gemc/clas12Tags_old/5.1/source/README.md

 
 
 

<b>GE</b>ant4 <b>M</b>onte-<b>C</b>arlo

<b>gemc</b> is an application based on <a href="https://geant4.cern.ch"> Geant4 </a> to simulate the 
passage of particles through matter.

It provides:

* application independent geometry description
* easy interface to build / run experiments
* cad/gdml imports

<p align="center">
	
	
	
	
</p>
<i> examples of experiments using gemc. From left to right: a <a href="https://www.jlab.org/Hall-B/clas12-web/">CLAS12</a> beamline event; 
The electron and ion beamline and interation point detectors for the <a href="https://www.jlab.org/meic/">electron-ion collider</a>.
The gemc simulation of the Electron Ion Collider beamline and detectors.
10,000 electrons producing photons in the 6mm collimator in the bubble experiments at Jefferson Lab.</i>

========

### Overview:

gemc makes easy things trivial and hard things possible.

Users can build and run complex setups with minimal programming knowledge. 
See for example <a href="https://gemc.jlab.org/gemc/html/examples/paddles.html#simplepaddleexample">how to build a TOF with
few lines of code</a>.

Experiments can be loaded  using a combination of several available factories:

- MYSQL
- TEXT
- GDML
- CAD (STL, PLY, OBJ formats)
- C++ Plugin

<p align="center">
	<a href="https://github.com/gemc/detectors/blob/master/humanBody/Upper_GI.stl">
	</a>
	<a href="https://github.com/gemc/detectors/blob/master/forFun/enterprise.stl"> 
	</a><br>
	<small><i> gemc can <a href="https://gemc.jlab.org/gemc/html/documentation/gdmlCadFactories.html">import models from CAD and GDML</a>.
   	Left: the upper gastrointestinal system is modeled in CAD.
   	It can be <a href="https://gemc.jlab.org/gemc/html/examples/humanBody.html">imported in GEMC and made it sensitive</a> 
		so that radiation doses can be measured.
   	Right: the mighty USS Enterprise NCC 1701-A <a href="https://gemc.jlab.org/gemc/html/examples/forFun.html">can be
   	used to shoot protons torpedos</a>. 
   </i></small>
</p>

### Simulations are application independent

Once the user defined setup is loaded, it is translated in geant4. This includes:

- geometry
- materials
- mirrors
- physics list
- digitization
- electromagnetic fields

All particles are transported through matters and
produce radiation, hits, secondaries. The geant4 results are then collected and organized according to user preferences.

<p align="center">
	
</p>

### Documentation:
* <a href="http://gemc.jlab.org"> gemc home page </a>
