gemc/clas12Tags_old/5.1/config/surveyCyril.png

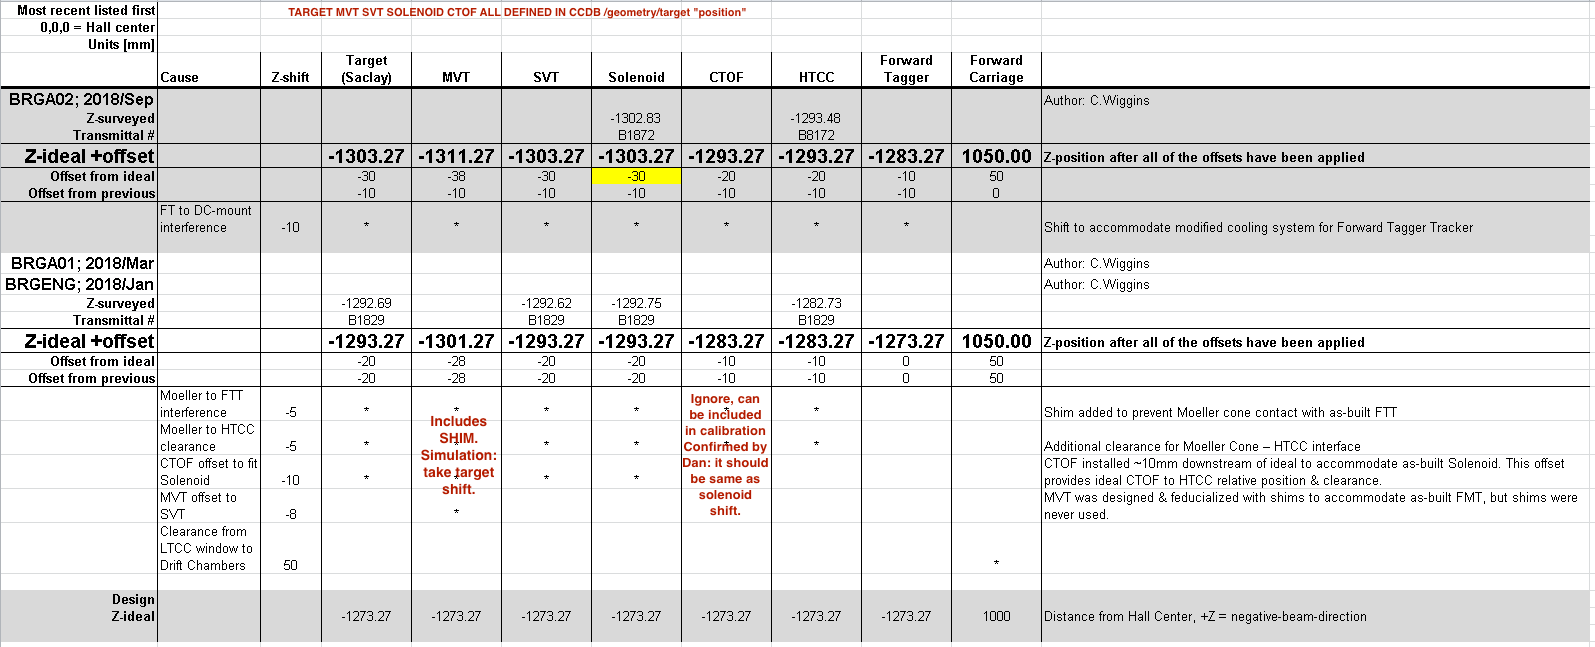
5.1/config/surveyCyril.png
