gemc/clas12Tags_old/ftOff.png

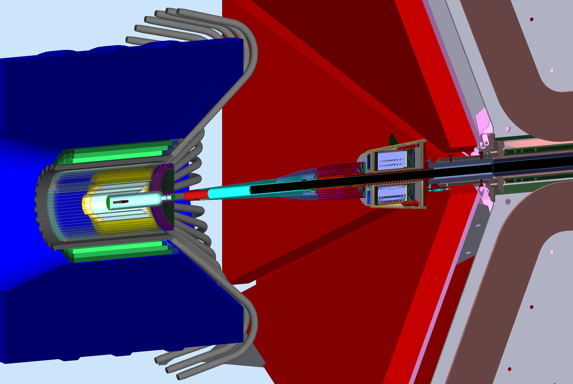
ftOff.png
