gemc/clas12Tags_old/ftOn.png

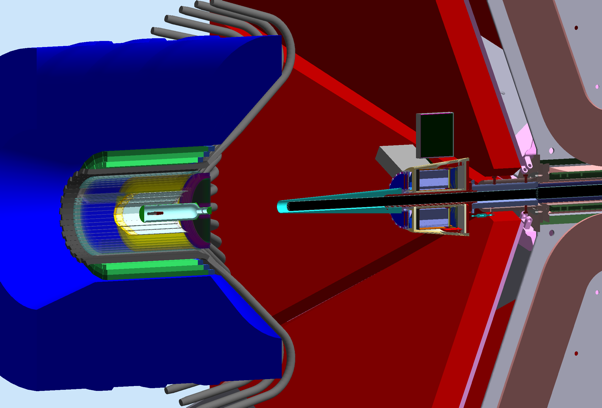
ftOn.png
