gemc/clas12Tags_old/4.4.2/experiments/clas12/beamline/cadBeamline/main-cone.stl

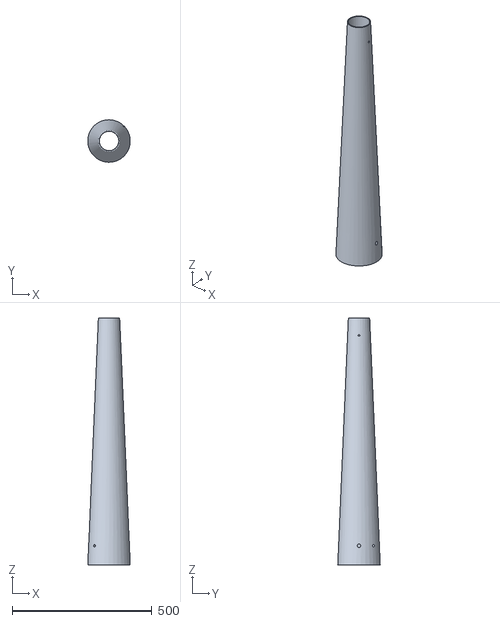
[picture p5: CAD file, 2016-12-02]
4.4.2/experiments/clas12/beamline/cadBeamline/main-cone.stl
151.9 x 152.1 x 882.6
