gemc/clas12Tags_old/4.4.2/experiments/clas12/beamline/cadBeamlineFTOFF/flange-assembly.stl

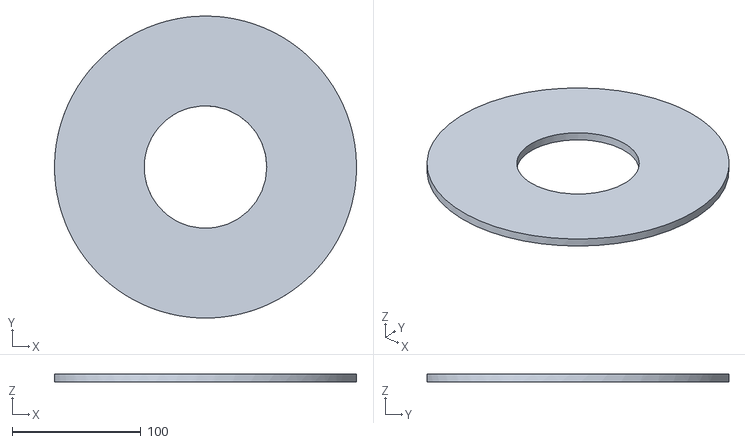
[picture p6: CAD file, 2016-12-02]
4.4.2/experiments/clas12/beamline/cadBeamlineFTOFF/flange-assembly.stl
234.7 x 234.7 x 6.35
