gemc/clas12Tags_old/5.1/experiments/clas12/beamline/cadBeamlineFTOFF/inner-assembly.stl

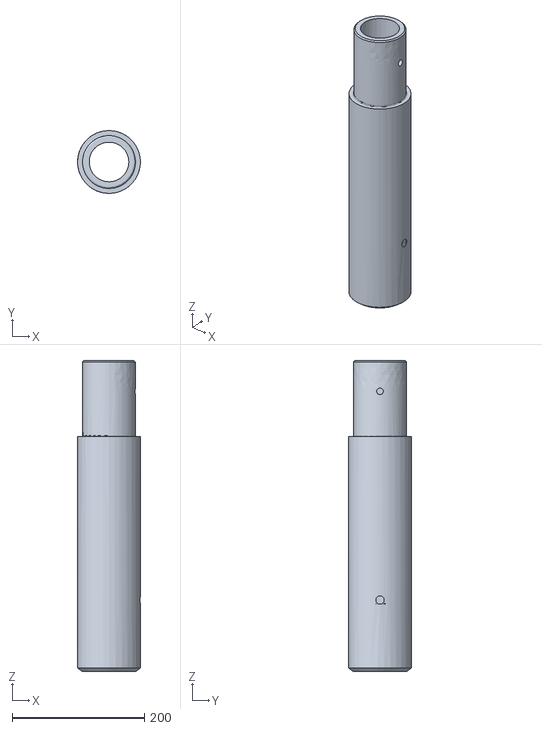
[picture p7: CAD file, 2016-12-02]
5.1/experiments/clas12/beamline/cadBeamlineFTOFF/inner-assembly.stl
95.2 x 95.2 x 471.0
