gemc/clas12Tags_old/5.1/experiments/clas12/beamline/cadBeamlineFTOFF/outer-assembly.stl

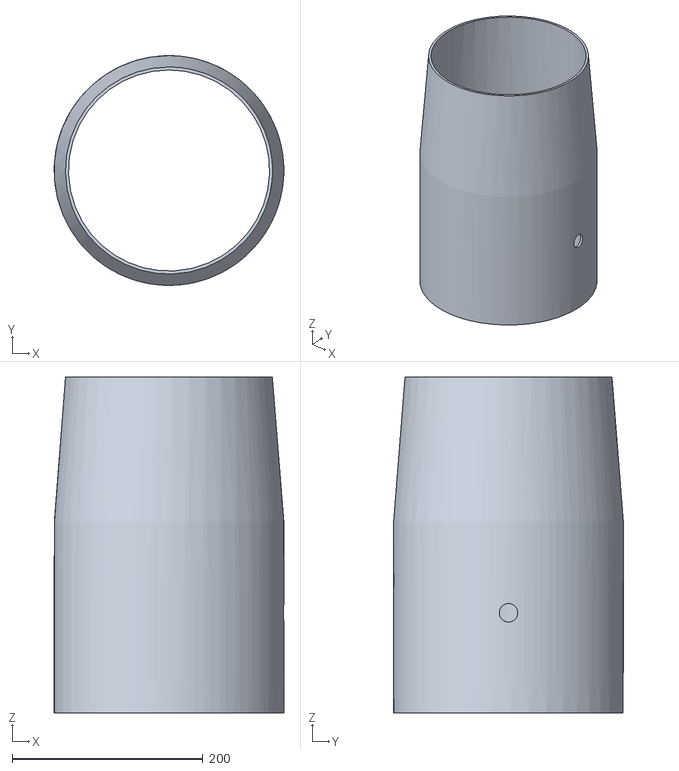
[picture p8: CAD file, 2016-12-02]
5.1/experiments/clas12/beamline/cadBeamlineFTOFF/outer-assembly.stl
241.1 x 241.1 x 352.5
