gemc/clas12Tags_old/4.4.2/experiments/clas12/beamline/cadBeamline/DSShieldFrontAss.stl

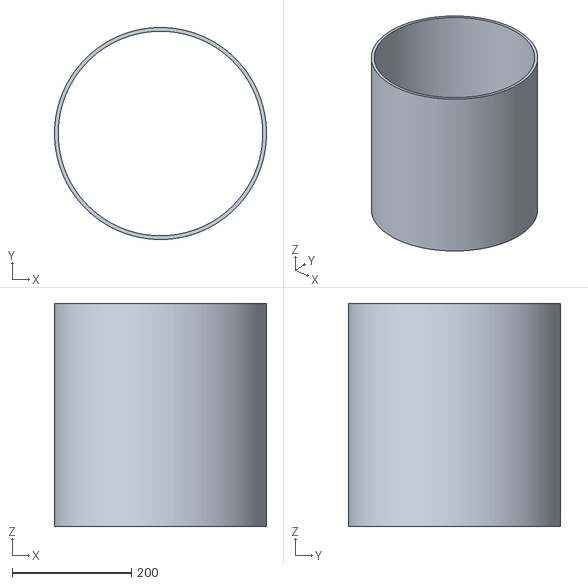
[picture p9: CAD file, 2017-10-10]
4.4.2/experiments/clas12/beamline/cadBeamline/DSShieldFrontAss.stl
355.6 x 355.6 x 374.7
