gemc/clas12Tags_old/4.4.2/experiments/clas12/beamline/cadBeamlineELMO/DSShieldFrontCover.stl

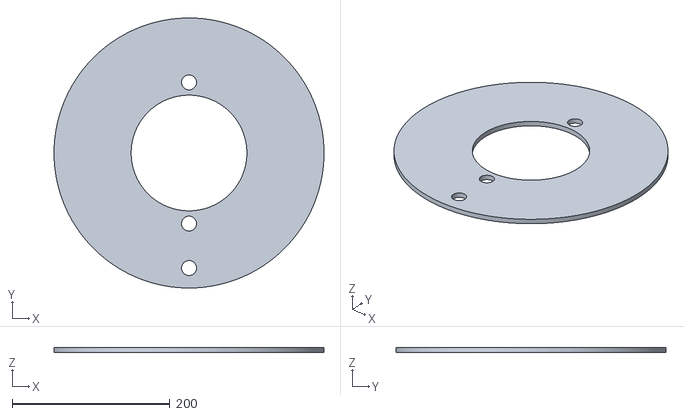
[picture p10: CAD file, 2017-10-10]
4.4.2/experiments/clas12/beamline/cadBeamlineELMO/DSShieldFrontCover.stl
342.9 x 342.9 x 6.35
