gemc/clas12Tags_old/4.4.2/experiments/clas12/beamline/cadBeamlineFTOFF/DSShieldInnerAss.stl

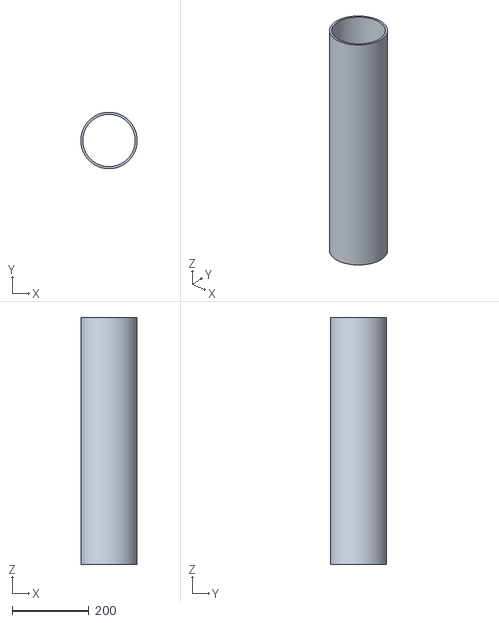
[picture p11: CAD file, 2017-10-10]
4.4.2/experiments/clas12/beamline/cadBeamlineFTOFF/DSShieldInnerAss.stl
146.9 x 147.0 x 642.9
