gemc/clas12Tags_old/4.4.2/experiments/clas12/ctof/javacad_default/sc01.stl

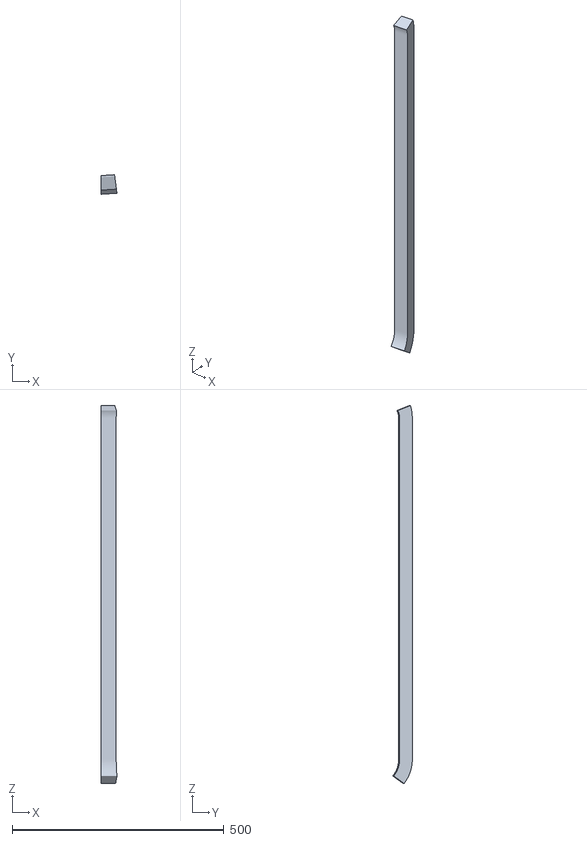
[picture p12: CAD file, 2017-07-05]
4.4.2/experiments/clas12/ctof/javacad_default/sc01.stl
37.8 x 46.3 x 892.3
