gemc/clas12Tags_old/4.4.2/experiments/clas12/ctof/javacad_rga_fall2018/sc33.stl

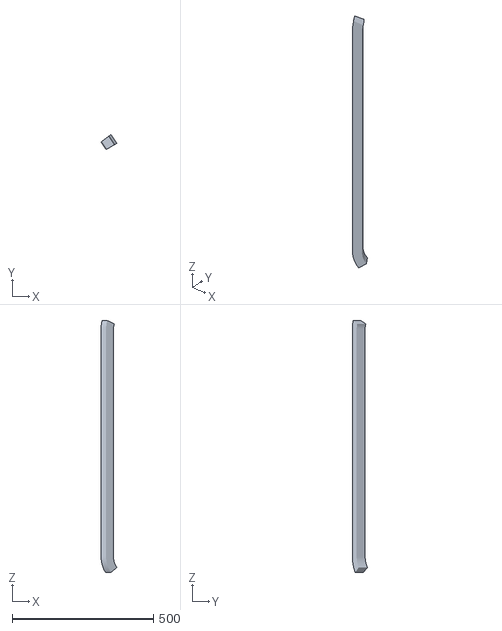
[picture p13: CAD file, 2017-07-05]
4.4.2/experiments/clas12/ctof/javacad_rga_fall2018/sc33.stl
56.2 x 53.6 x 892.3
