gemc/clas12Tags_old/4.4.2/experiments/clas12/ctof/javacad_rga_spring2018/lgd14.stl

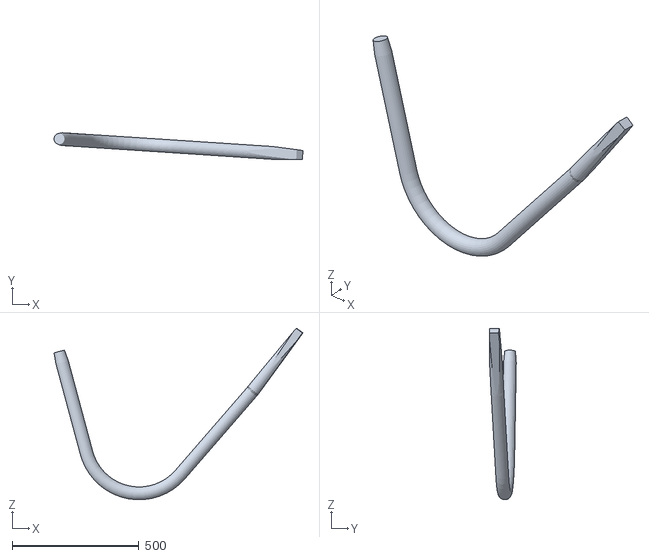
[picture p14: CAD file, 2017-07-05]
4.4.2/experiments/clas12/ctof/javacad_rga_spring2018/lgd14.stl
984.0 x 105.0 x 677.2
