gemc/clas12Tags_old/4.4.2/experiments/clas12/targets/cade/TargetVacuumWindow50umAl.stl

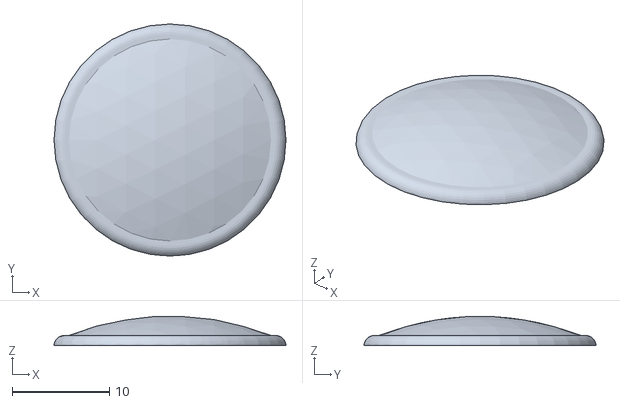
[picture p15: CAD file, 2017-08-30]
4.4.2/experiments/clas12/targets/cade/TargetVacuumWindow50umAl.stl
23.8 x 23.8 x 3.01
