gemc/clas12Tags_old/4a.1.1/experiments/clas12/ctof/javacad/lgu14.stl

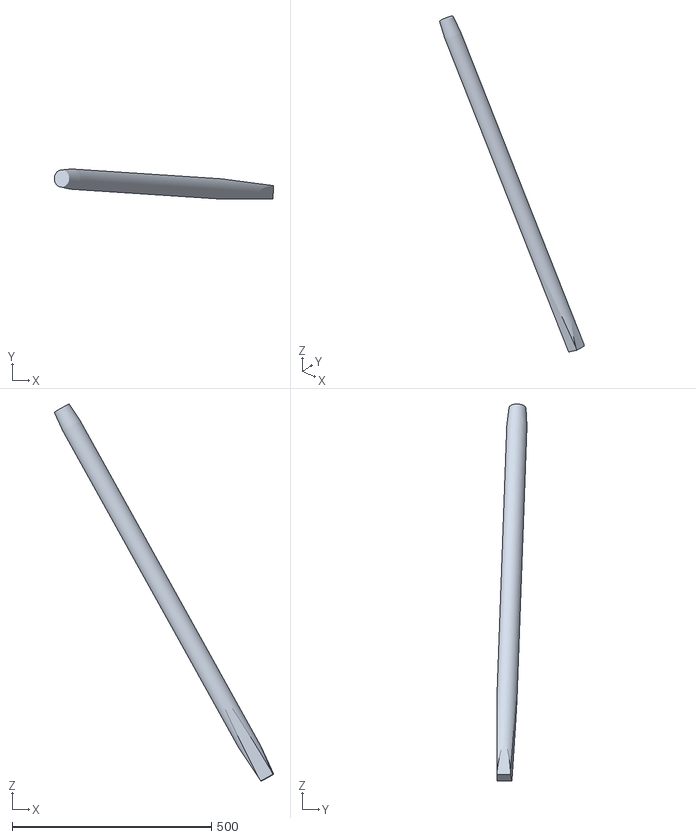
[picture p16: CAD file, 2017-07-05]
4a.1.1/experiments/clas12/ctof/javacad/lgu14.stl
550.6 x 75.2 x 945.6
