gemc/clas12Tags_old/5.1/experiments/atlas/cad/LargeOuterWheel.stl

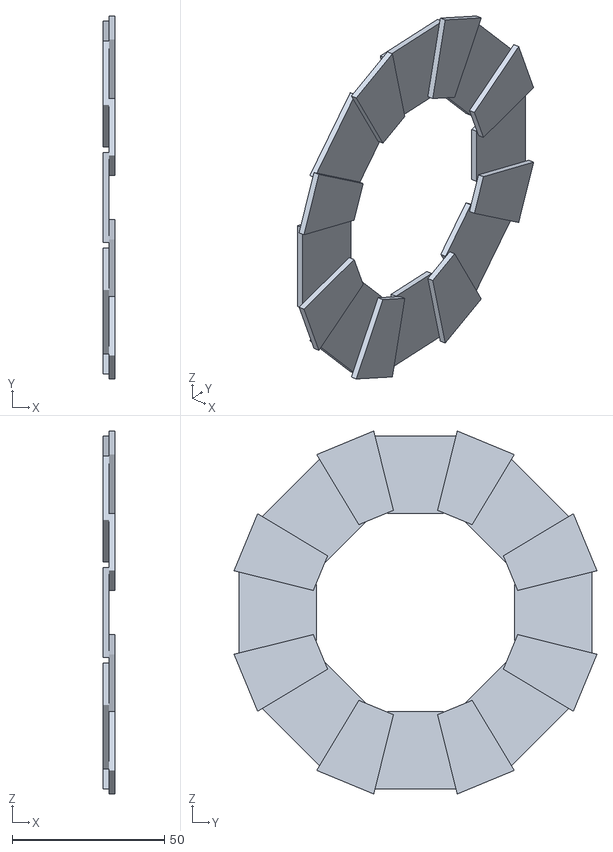
[picture p17: CAD file, 2018-10-09]
5.1/experiments/atlas/cad/LargeOuterWheel.stl
4.00 x 119.3 x 119.3
