gemc/clas12Tags_old/5.1/experiments/clas12/beamline/cadBeamline/DSShieldBackAss.stl

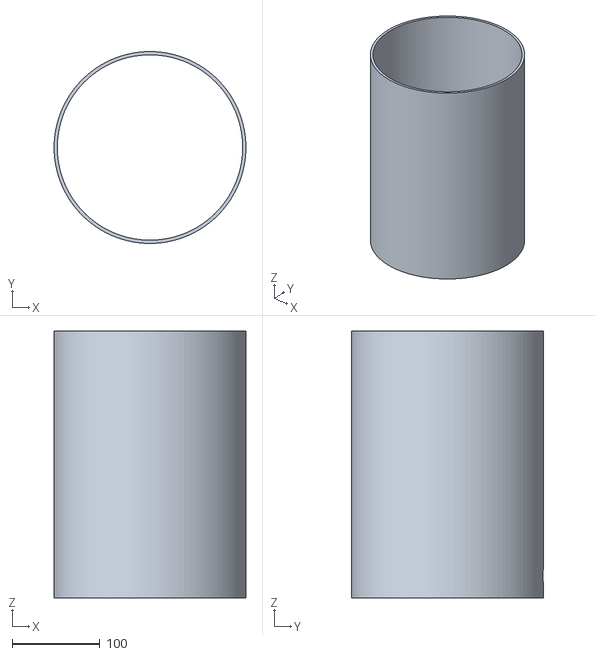
[picture p18: CAD file, 2017-10-10]
5.1/experiments/clas12/beamline/cadBeamline/DSShieldBackAss.stl
219.1 x 219.1 x 304.8
