gemc/clas12Tags_old/5.1/experiments/clas12/beamline/cadBeamlineFTOFF/DSShieldBackCover.stl

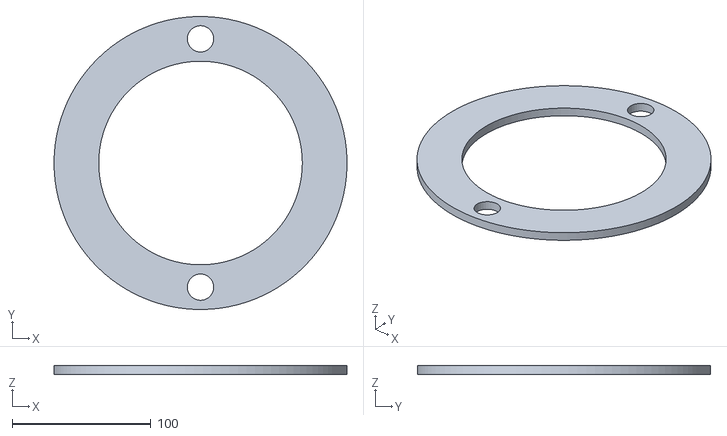
[picture p19: CAD file, 2017-10-10]
5.1/experiments/clas12/beamline/cadBeamlineFTOFF/DSShieldBackCover.stl
211.5 x 211.5 x 6.35
