gemc/clas12Tags_old/5.1/experiments/clas12/beamline/vacuumLine/connectUpstreamToTorusPipe.stl

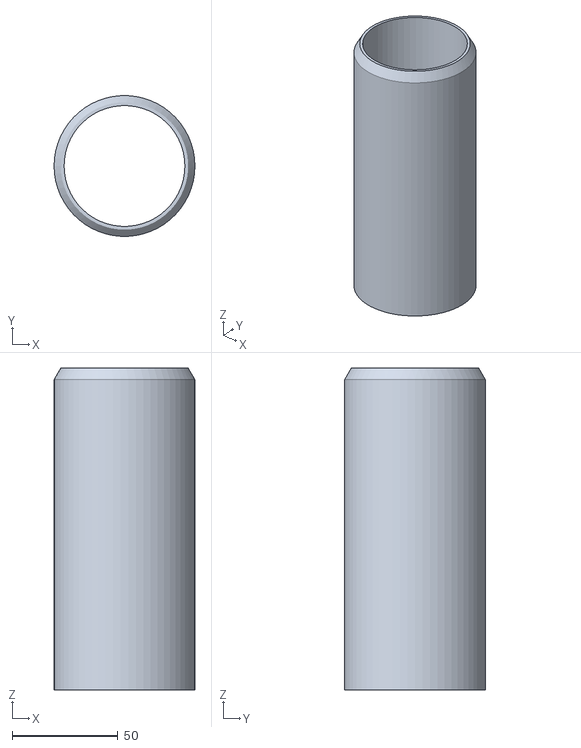
[picture p20: CAD file, 2017-10-10]
5.1/experiments/clas12/beamline/vacuumLine/connectUpstreamToTorusPipe.stl
66.7 x 66.6 x 152.4
