gemc/clas12Tags_old/5.1/experiments/clas12/ctof/javacad_default/lgd12.stl

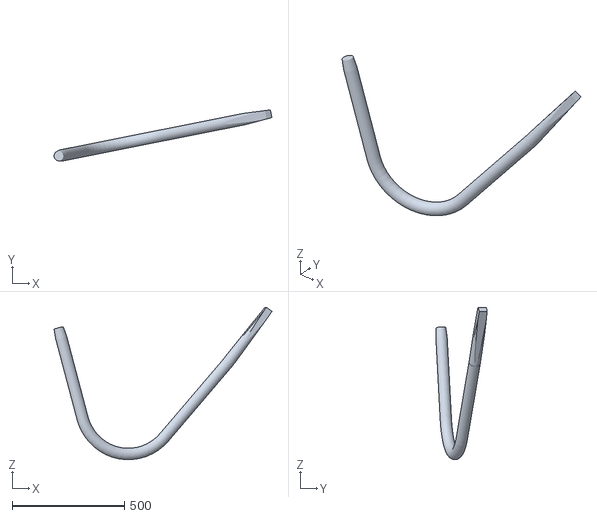
[picture p21: CAD file, 2017-07-05]
5.1/experiments/clas12/ctof/javacad_default/lgd12.stl
969.9 x 228.3 x 677.2
