gemc/clas12Tags_old/5.1/experiments/clas12/ctof/javacad_default_upstream/lgu39.stl

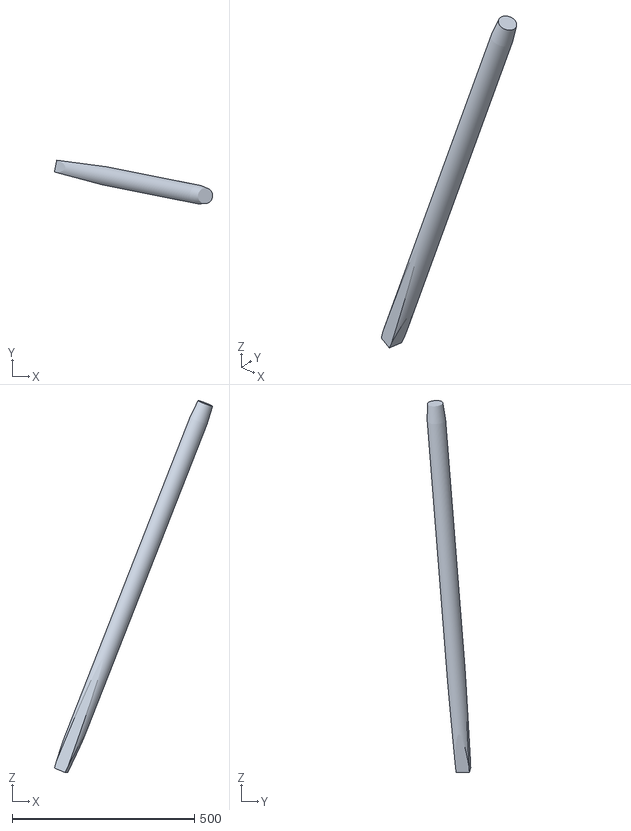
[picture p22: CAD file, 2017-07-05]
5.1/experiments/clas12/ctof/javacad_default_upstream/lgu39.stl
433.6 x 119.4 x 1019.2
