gemc/clas12Tags_old/5.1/experiments/clas12/ctof/javacad_rga_fall2018/sc22.stl

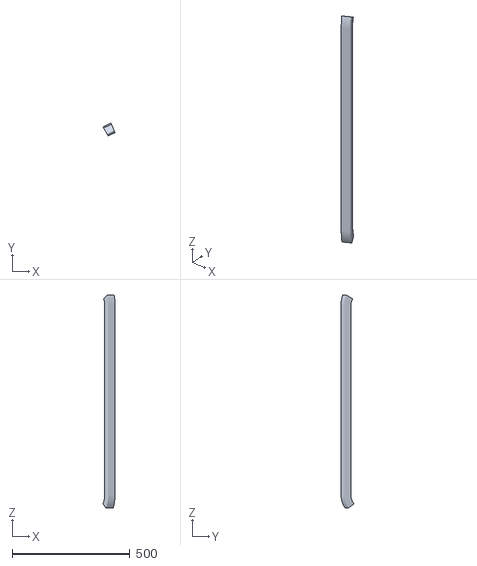
[picture p23: CAD file, 2017-07-05]
5.1/experiments/clas12/ctof/javacad_rga_fall2018/sc22.stl
50.9 x 55.1 x 904.3
