gemc/clas12Tags_old/5.1/experiments/clas12/ctof/javacad_rga_spring2018/lgd17.stl

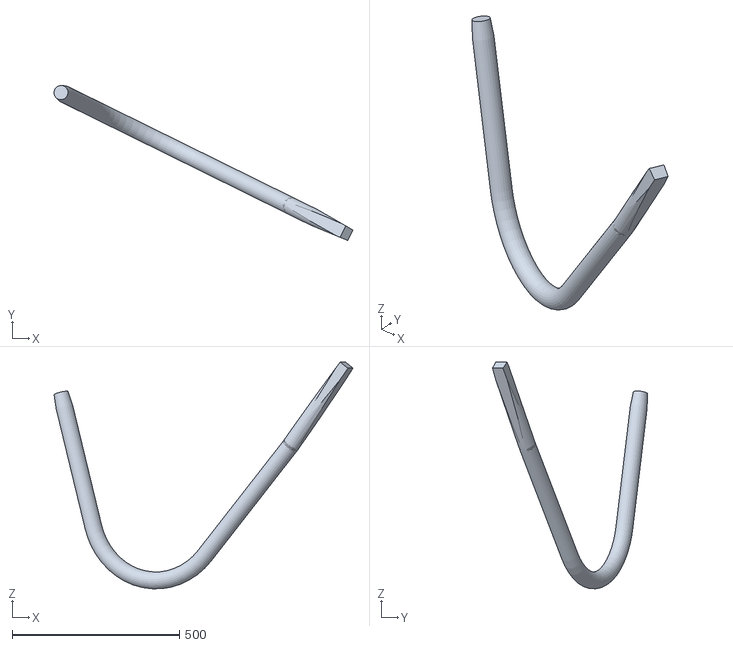
[picture p24: CAD file, 2017-07-05]
5.1/experiments/clas12/ctof/javacad_rga_spring2018/lgd17.stl
893.4 x 463.3 x 677.2
