gemc/clas12Tags_old/5.1/experiments/clas12/ctof/javacad_rga_spring2018_upstream/lgu19.stl

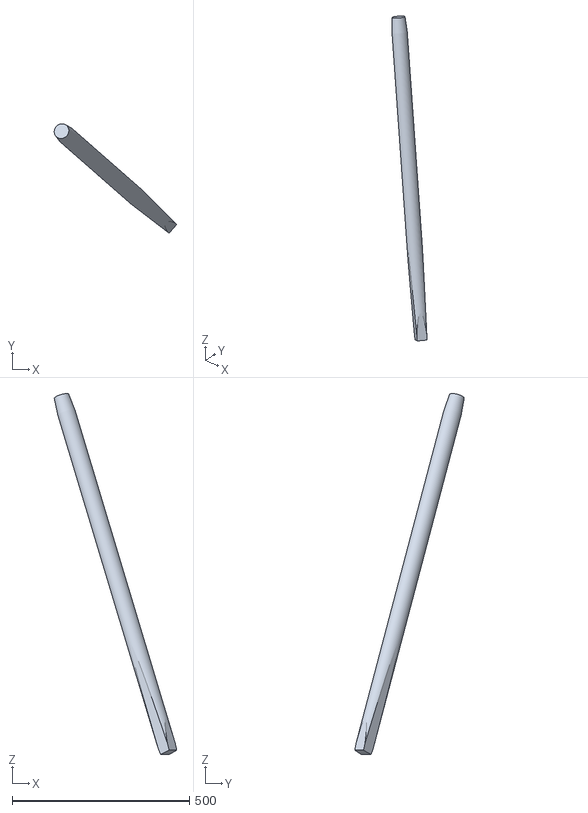
[picture p25: CAD file, 2017-07-05]
5.1/experiments/clas12/ctof/javacad_rga_spring2018_upstream/lgu19.stl
346.0 x 309.1 x 1019.2
