gemc/clas12Tags_old/5.1/experiments/clas12/ddvcs/cad/layout_calorimeter.stl

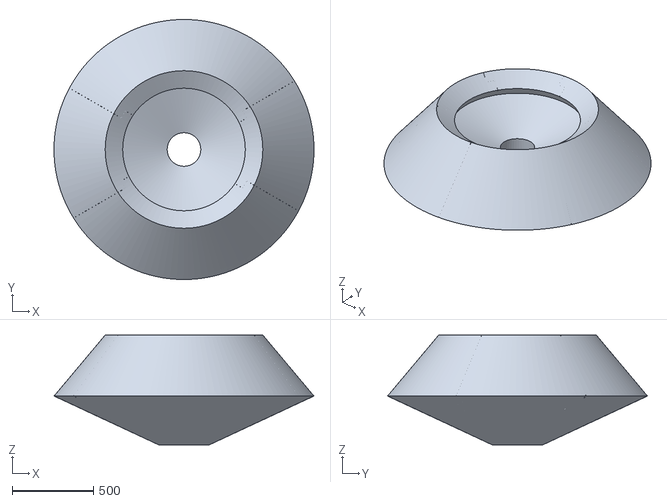
[picture p26: CAD file, 2023-02-24]
5.1/experiments/clas12/ddvcs/cad/layout_calorimeter.stl
1597.0 x 1597.1 x 675.6
