gemc/clas12Tags_old/5.1/experiments/clas12/htcc/cad/htccMollerCone.stl

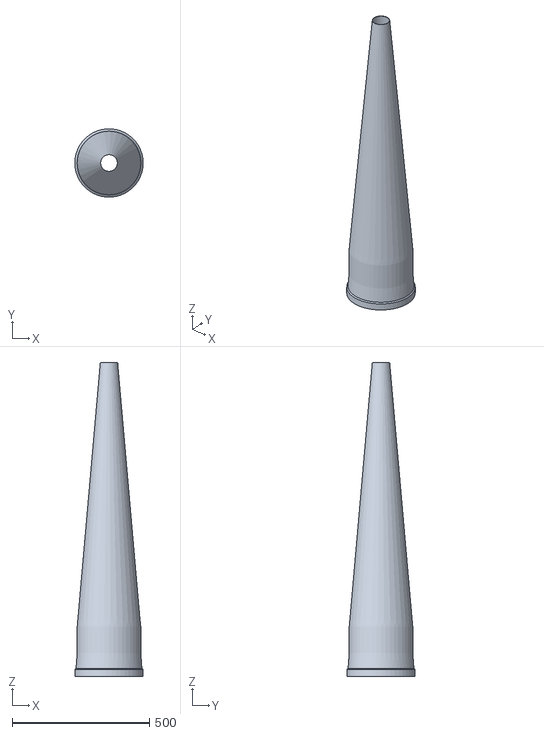
[picture p27: CAD file, 2021-12-09]
5.1/experiments/clas12/htcc/cad/htccMollerCone.stl
249.6 x 249.1 x 1145.4
