gemc/clas12Tags_old/5.1/experiments/clas12/ltcc/cad/S1-TLB.stl

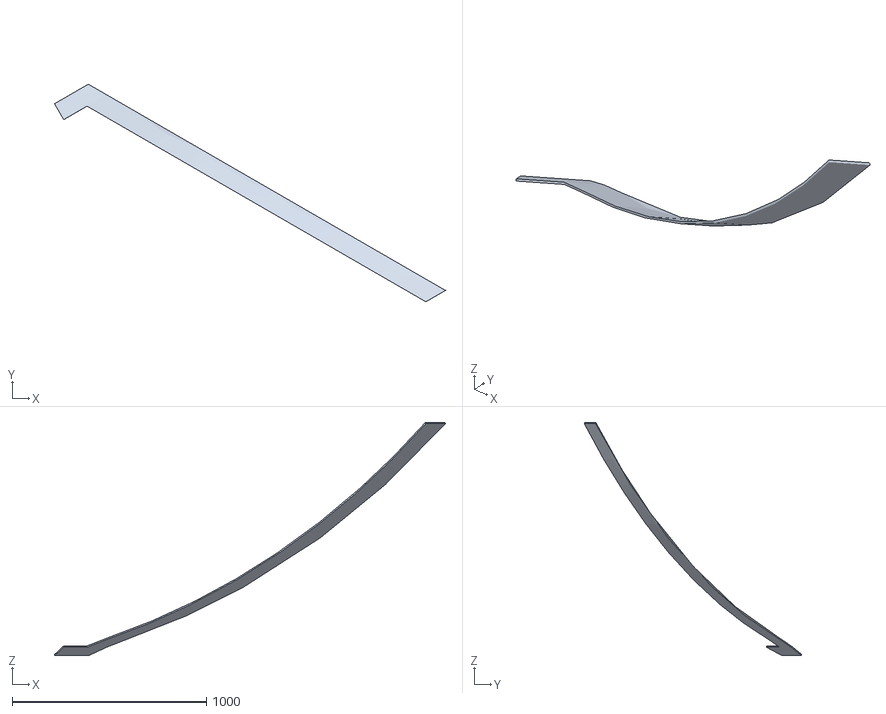
[picture p28: CAD file, 2017-04-17]
5.1/experiments/clas12/ltcc/cad/S1-TLB.stl
2014.9 x 1121.2 x 1201.1
