gemc/clas12Tags_old/5.1/experiments/clas12/ltcc/cad_cone/WC_S.stl

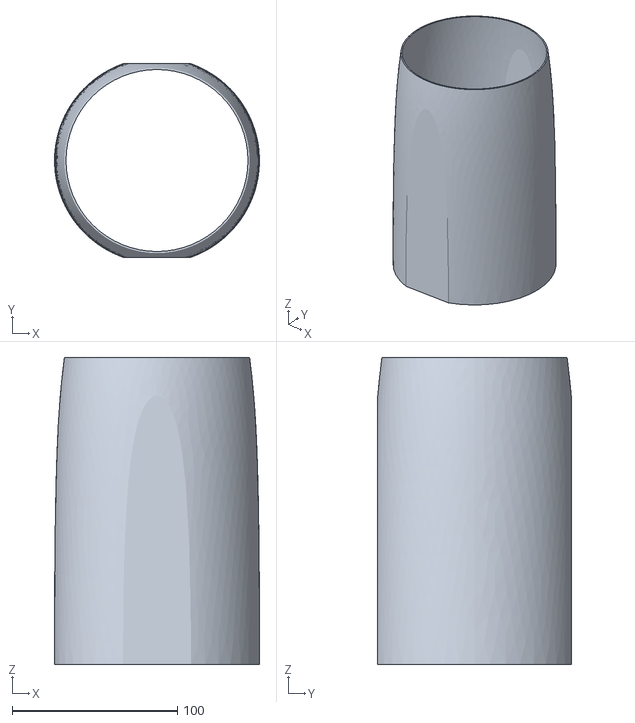
[picture p29: CAD file, 2017-04-17]
5.1/experiments/clas12/ltcc/cad_cone/WC_S.stl
124.0 x 117.0 x 185.6
