gemc/clas12Tags_old/5.1/experiments/clas12/magnets/cad/apex.stl

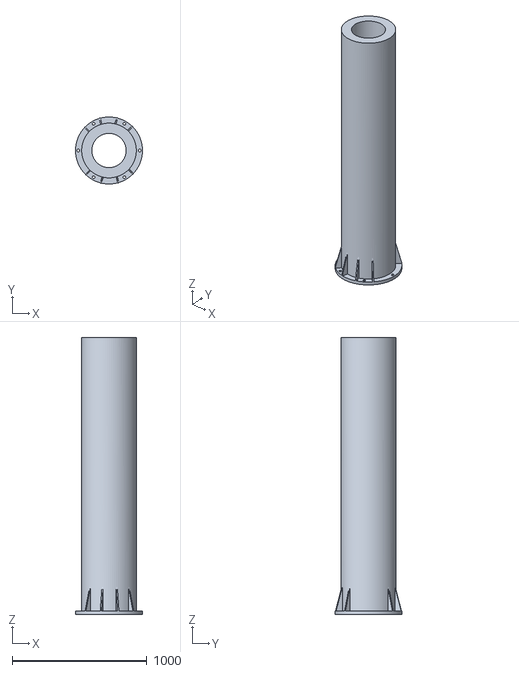
[picture p30: CAD file, 2017-08-21]
5.1/experiments/clas12/magnets/cad/apex.stl
497.8 x 497.8 x 2057.4
