gemc/clas12Tags_old/5.1/experiments/clas12/nuclearTargetTest/cad/TargetFoam.stl

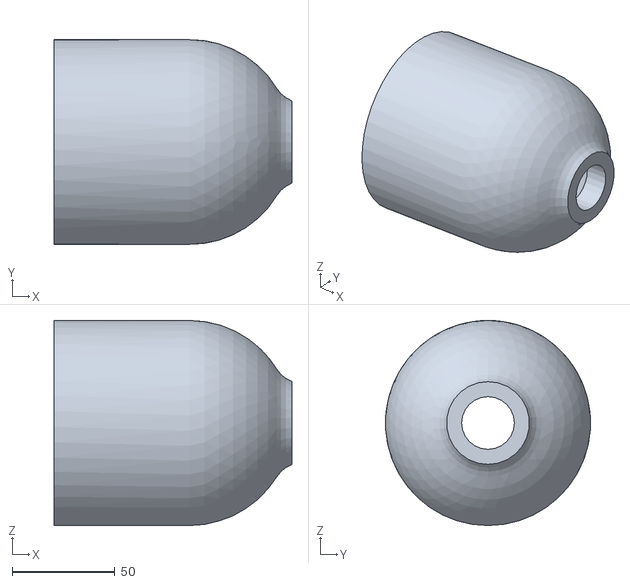
[picture p31: CAD file, 2018-12-03]
5.1/experiments/clas12/nuclearTargetTest/cad/TargetFoam.stl
116.0 x 99.9 x 100.0
