gemc/clas12Tags_old/5.1/experiments/clas12/rich_sector4/javacad/Layer_204_component_32.stl

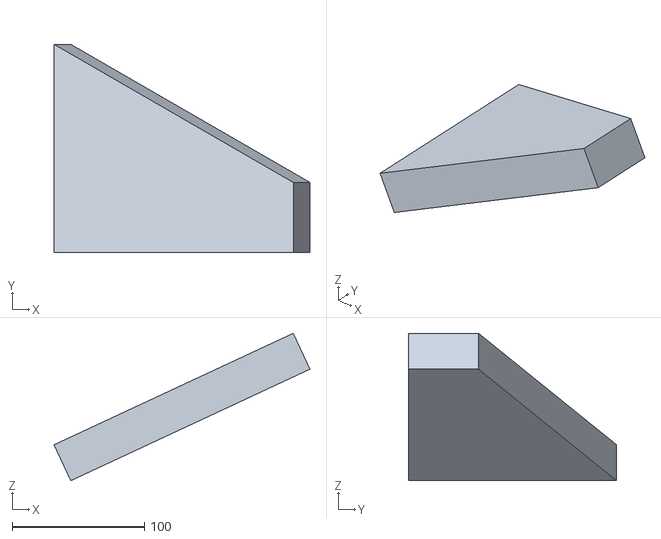
[picture p32: CAD file, 2022-10-13]
5.1/experiments/clas12/rich_sector4/javacad/Layer_204_component_32.stl
193.4 x 157.4 x 111.4
