gemc/clas12Tags_old/5.1/experiments/clas12/targets/APOLLO/InsertBath_NoVoid_6.stl

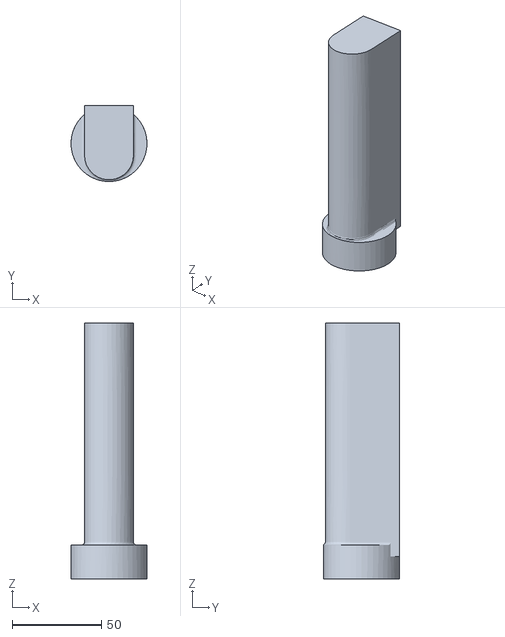
[picture p33: CAD file, 2019-01-10]
5.1/experiments/clas12/targets/APOLLO/InsertBath_NoVoid_6.stl
42.6 x 42.6 x 143.3
