gemc/clas12Tags_old/5.1/experiments/clas12/targets/cad/scatteringChamber.stl

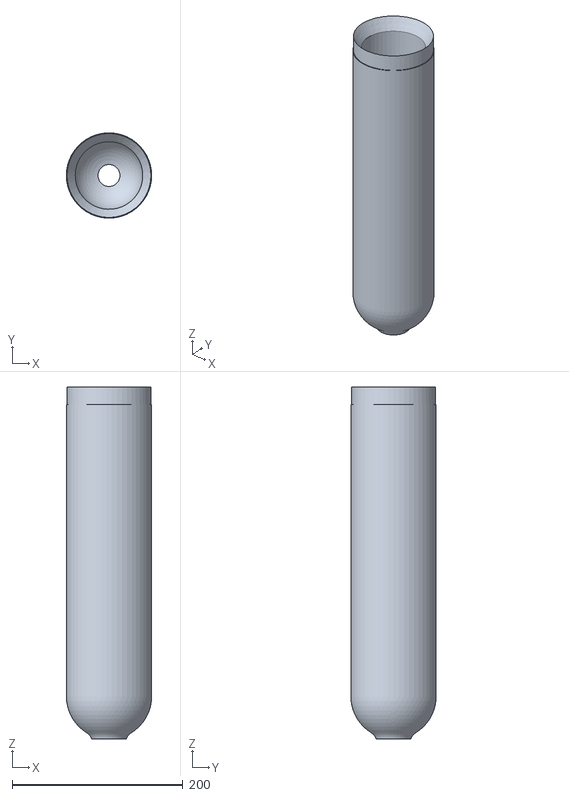
[picture p34: CAD file, 2021-04-02]
5.1/experiments/clas12/targets/cad/scatteringChamber.stl
100.0 x 99.8 x 412.4
