gemc/clas12Tags_old/5.1/experiments/clas12/targets/cade/foamExtended.stl

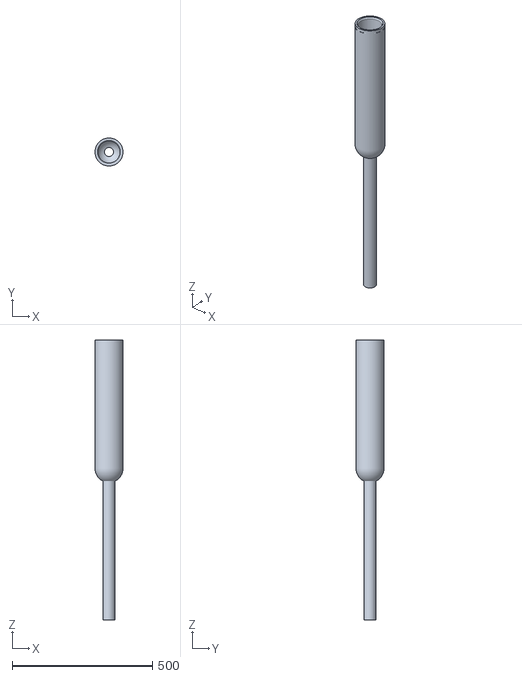
[picture p35: CAD file, 2019-10-15]
5.1/experiments/clas12/targets/cade/foamExtended.stl
100.0 x 100.0 x 998.7
