gemc/clas12Tags_old/5.1/experiments/clas12/targets/EG2p/targetContainer.stl

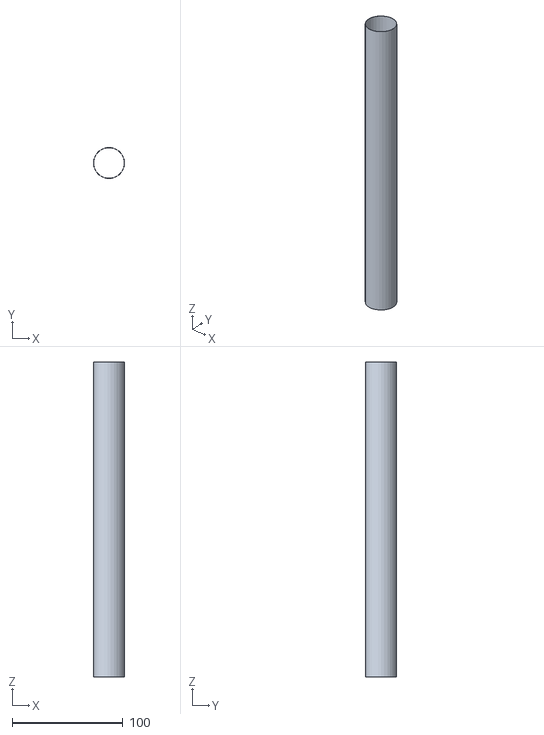
[picture p36: CAD file, 2019-04-11]
5.1/experiments/clas12/targets/EG2p/targetContainer.stl
28.0 x 27.8 x 285.0
