gemc/clas12Tags_old/5.1/experiments/clas12/targets/hdIce/unit_PCTFE.stl

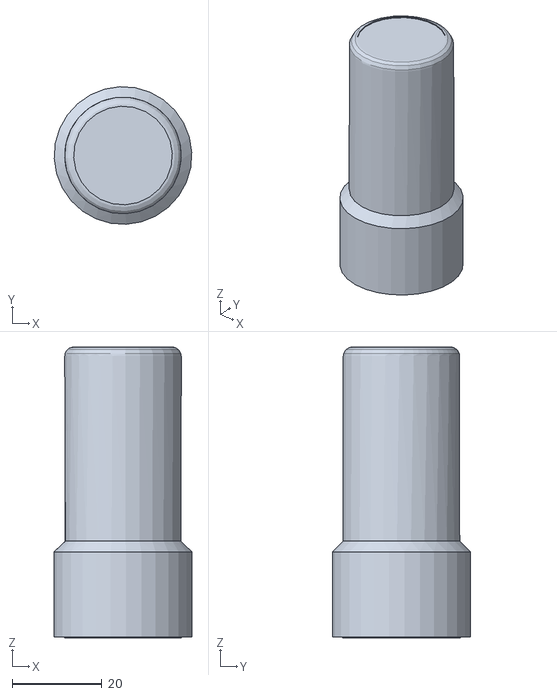
[picture p37: CAD file, 2021-04-02]
5.1/experiments/clas12/targets/hdIce/unit_PCTFE.stl
30.7 x 30.7 x 64.9
