gemc/clas12Tags_old/5.1/experiments/clas12/targets/ltarget/MEOP_CLAS12.stp

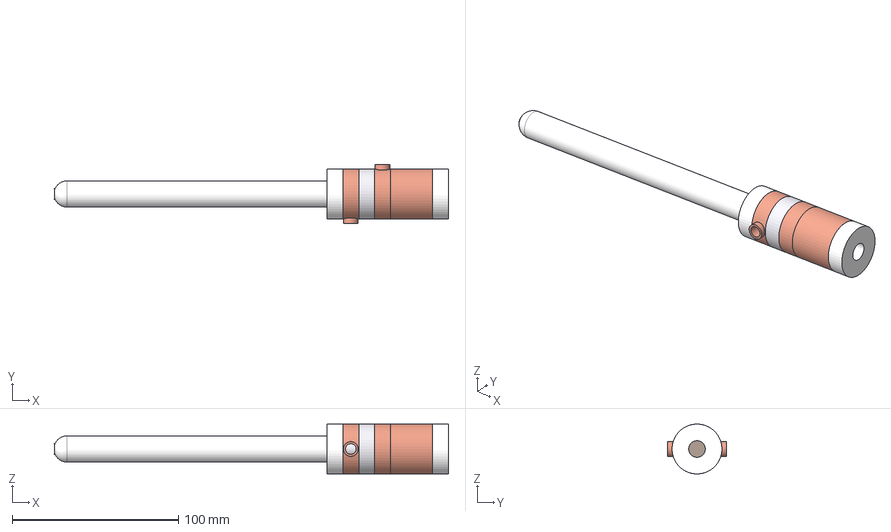
[picture p38: CAD file, 2021-04-02]
5.1/experiments/clas12/targets/ltarget/MEOP_CLAS12.stp
237.0 x 35.6 x 30.0 mm
deverter
flow_entrance x 2
outer_cell
exchanger
beam_window
be
al_window
he3
