gemc/clas12Tags_old/5.1/experiments/clas12/targets/transverseTargetCad/AdditionalWindows.stp

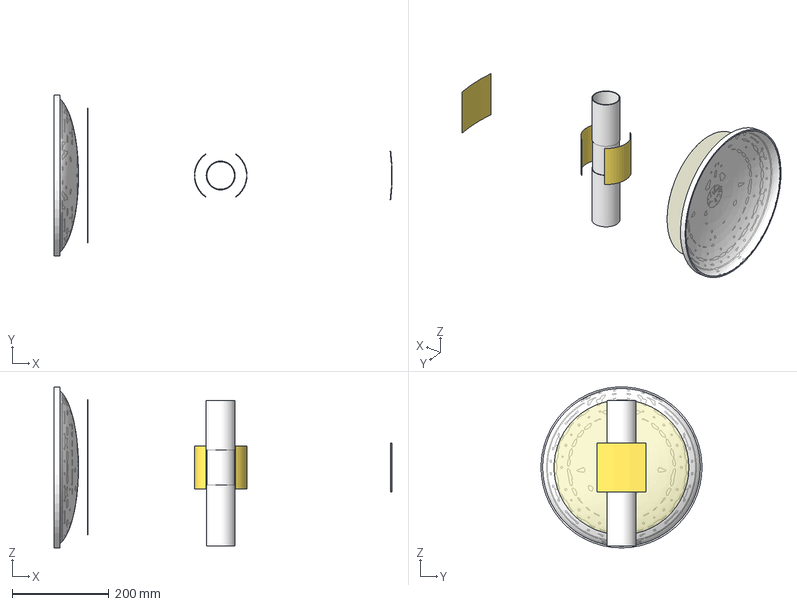
[picture p39: CAD file, 2021-11-22]
5.1/experiments/clas12/targets/transverseTargetCad/AdditionalWindows.stp
699.8 x 333.2 x 333.1 mm
Upstream RS
Beam Path exit window
Downstream RS
Upstream RS_1
Pumpline-7inch
Inner RS Sheet_MIR1
