gemc/clas12Tags_old/5.1/experiments/forFun/cad/dragon.stl

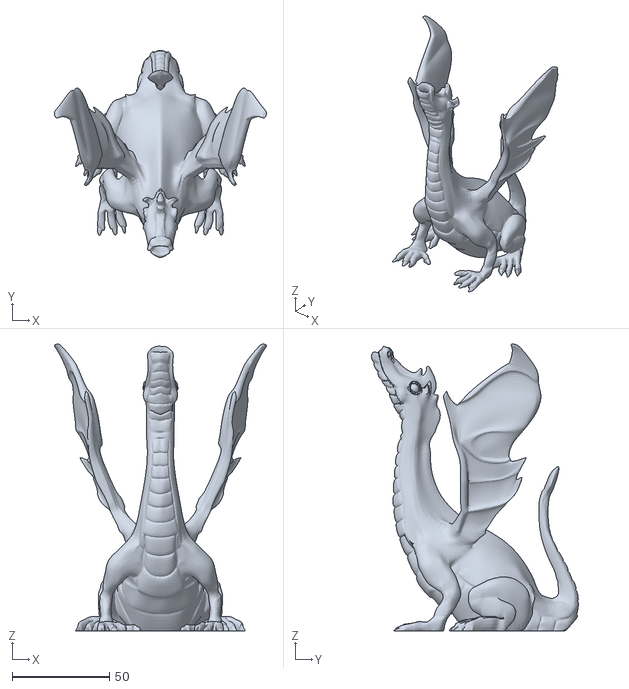
[picture p40: CAD file, 2016-12-02]
5.1/experiments/forFun/cad/dragon.stl
108.8 x 106.3 x 147.2
