gemc/clas12Tags_old/5.1/experiments/humanBody/cad/heart.stl

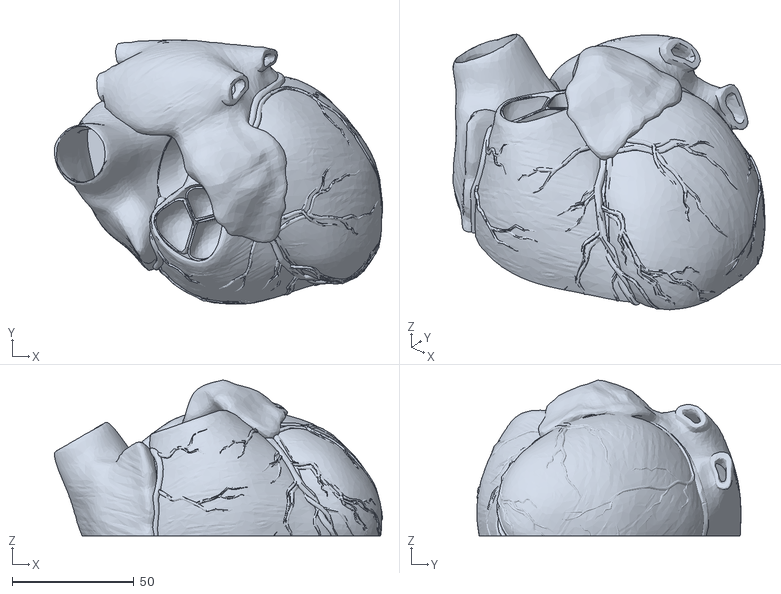
[picture p41: CAD file, 2016-12-02]
5.1/experiments/humanBody/cad/heart.stl
134.9 x 108.7 x 64.0
