gemc/clas12Tags_old/4.4.2/experiments/clas12/beamline/cadBeamline/DSShieldFrontLead.stl

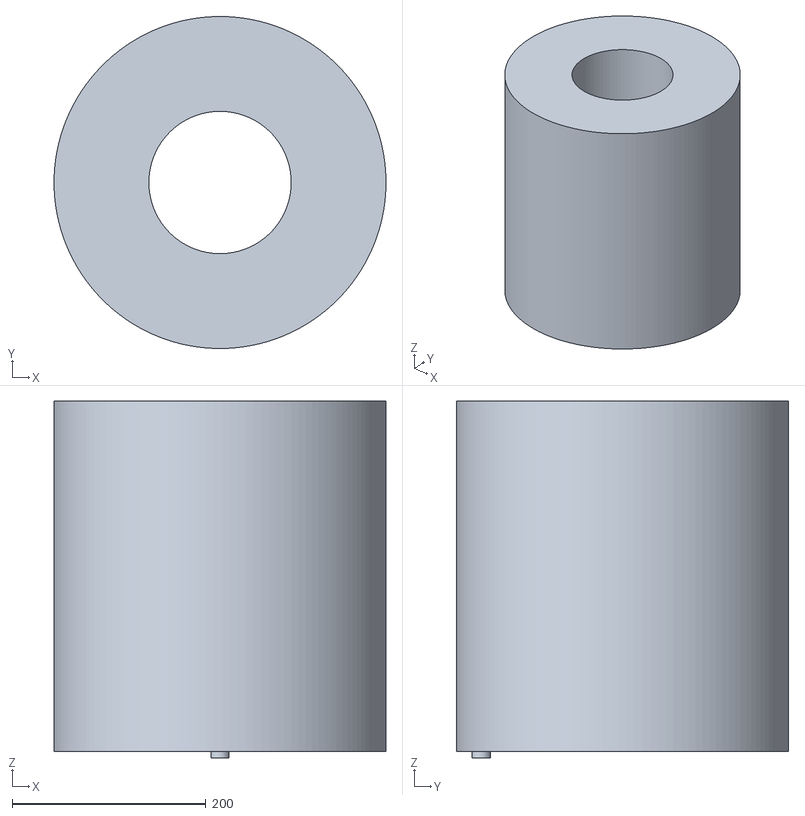
[picture p42: CAD file, 2017-10-10]
4.4.2/experiments/clas12/beamline/cadBeamline/DSShieldFrontLead.stl
342.9 x 342.9 x 368.3
