gemc/clas12Tags_old/4.4.2/experiments/clas12/ctof/javacad_default/lgd06.stl

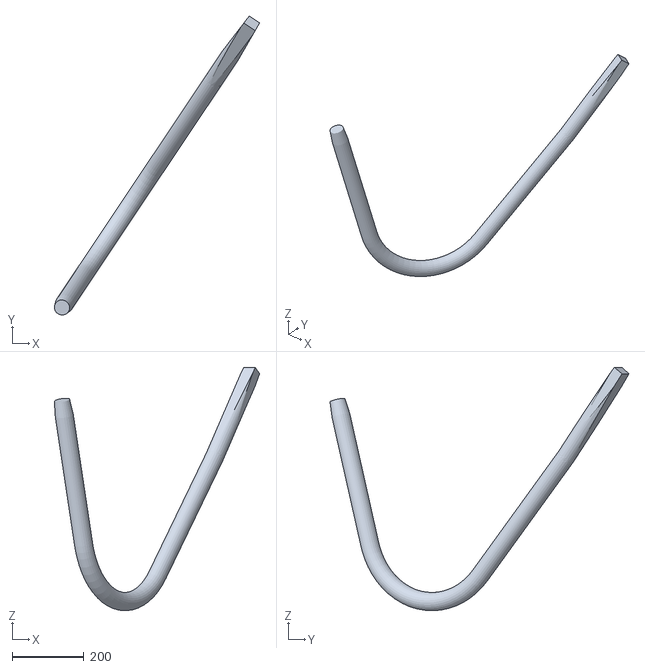
[picture p43: CAD file, 2017-07-05]
4.4.2/experiments/clas12/ctof/javacad_default/lgd06.stl
571.5 x 832.3 x 677.4
