gemc/clas12Tags_old/4a.1.1/experiments/clas12/ctof/javacad/lgu04.stl

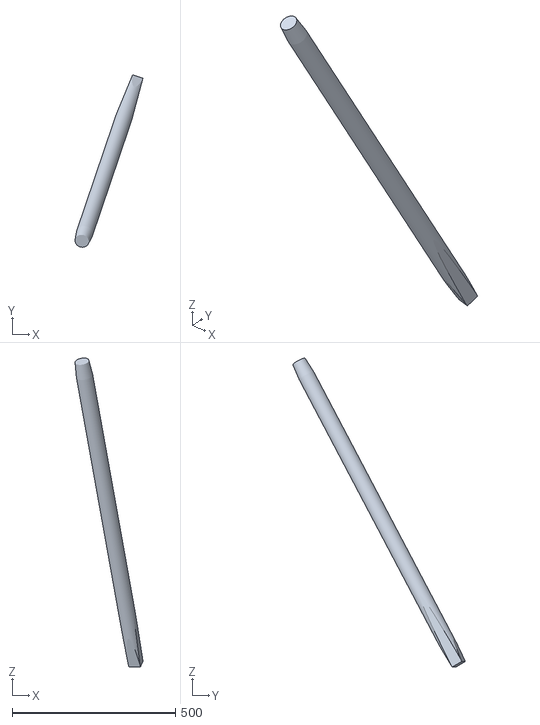
[picture p44: CAD file, 2017-07-05]
4a.1.1/experiments/clas12/ctof/javacad/lgu04.stl
208.0 x 528.0 x 945.6
