gemc/clas12Tags_old/5.1/experiments/atlas/cad/TRT.stl

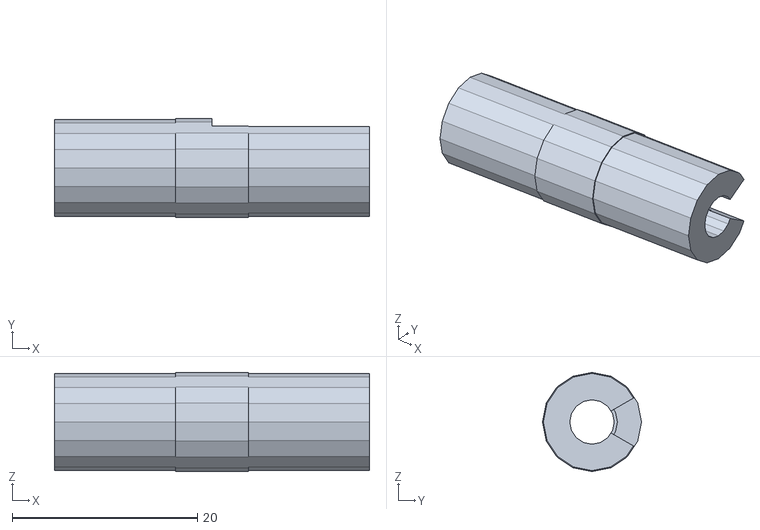
[picture p45: CAD file, 2018-10-09]
5.1/experiments/atlas/cad/TRT.stl
34.0 x 10.7 x 10.7
