gemc/clas12Tags_old/5.1/experiments/clas12/beamline/cadBeamline/DSShieldBackLead.stl

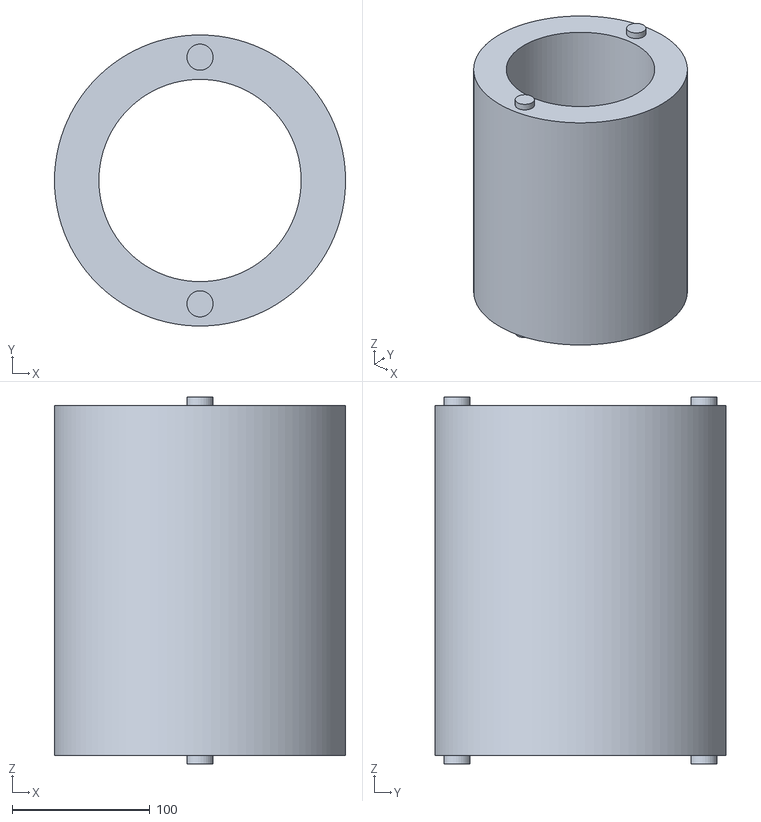
[picture p46: CAD file, 2017-10-10]
5.1/experiments/clas12/beamline/cadBeamline/DSShieldBackLead.stl
211.5 x 211.5 x 266.7
