gemc/clas12Tags_old/5.1/experiments/clas12/beamline/vacuumLine/downstreamPipeFlange.stl

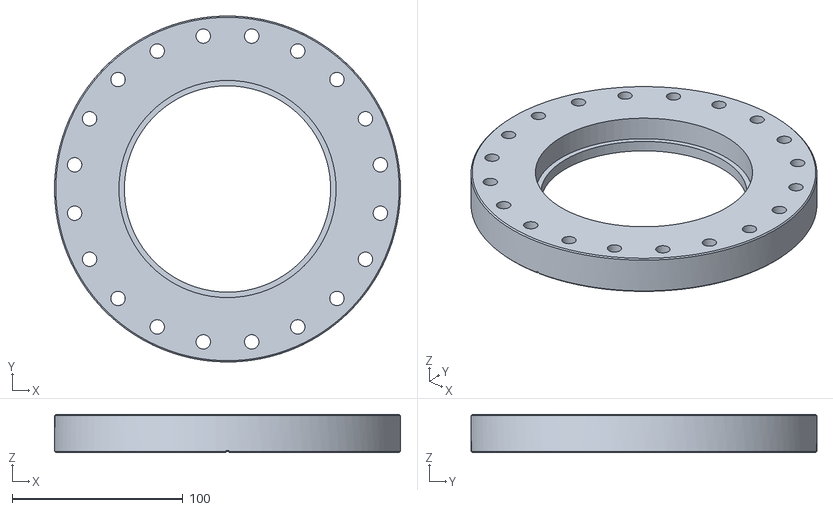
[picture p47: CAD file, 2017-10-10]
5.1/experiments/clas12/beamline/vacuumLine/downstreamPipeFlange.stl
202.4 x 202.4 x 22.4
