gemc/clas12Tags_old/5.1/experiments/clas12/ctof/javacad_default/sc17.stl

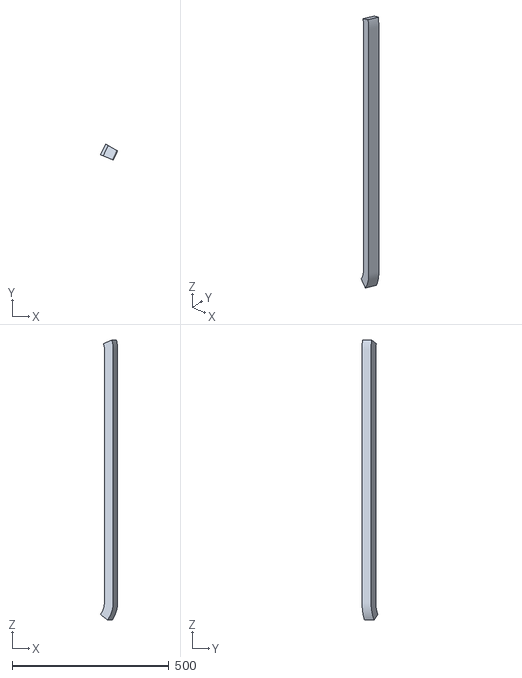
[picture p48: CAD file, 2017-07-05]
5.1/experiments/clas12/ctof/javacad_default/sc17.stl
55.1 x 50.9 x 892.3
