gemc/clas12Tags_old/5.1/experiments/clas12/ctof/javacad_default_upstream/lgu12.stl

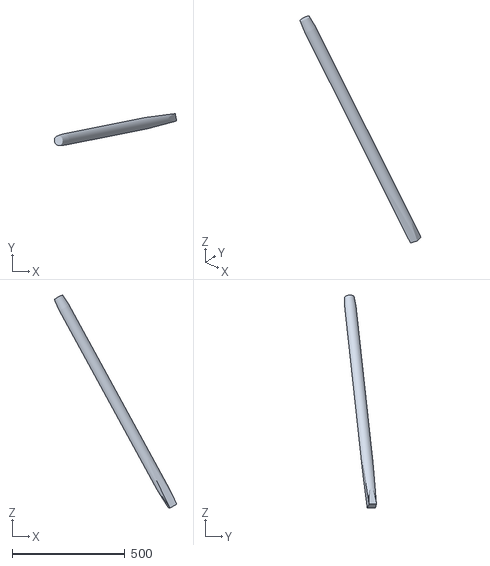
[picture p49: CAD file, 2017-07-05]
5.1/experiments/clas12/ctof/javacad_default_upstream/lgu12.stl
543.7 x 141.5 x 945.6
