gemc/clas12Tags_old/5.1/experiments/clas12/ctof/javacad_rga_fall2018/sc19.stl

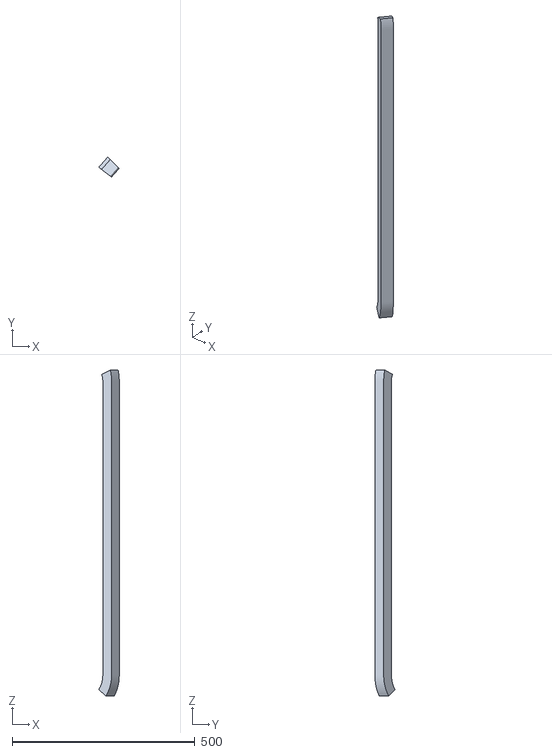
[picture p50: CAD file, 2017-07-05]
5.1/experiments/clas12/ctof/javacad_rga_fall2018/sc19.stl
56.3 x 55.4 x 892.3
