gemc/clas12Tags_old/5.1/experiments/clas12/ctof/javacad_rga_fall2018_upstream/lgu18.stl

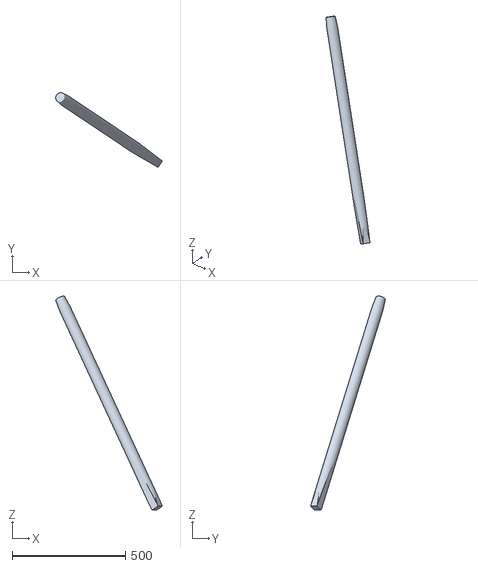
[picture p51: CAD file, 2017-07-05]
5.1/experiments/clas12/ctof/javacad_rga_fall2018_upstream/lgu18.stl
471.1 x 330.0 x 945.6
