gemc/clas12Tags_old/5.1/experiments/clas12/ctof/javacad_rga_spring2018_upstream/lgu21.stl

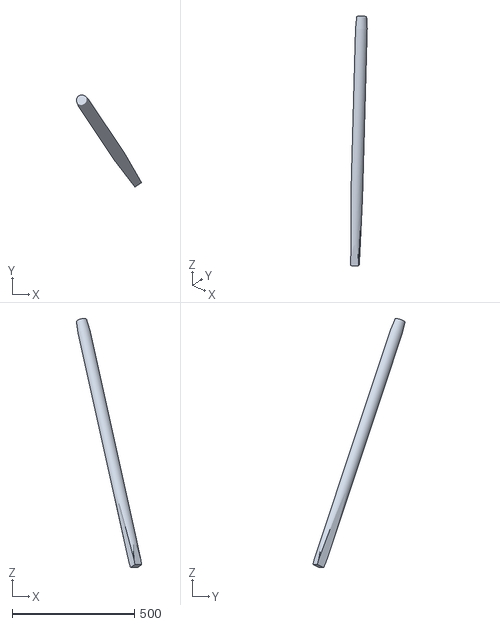
[picture p52: CAD file, 2017-07-05]
5.1/experiments/clas12/ctof/javacad_rga_spring2018_upstream/lgu21.stl
267.1 x 377.5 x 1019.2
