gemc/clas12Tags_old/5.1/experiments/clas12/ddvcs/cad/moeller_cone.stl

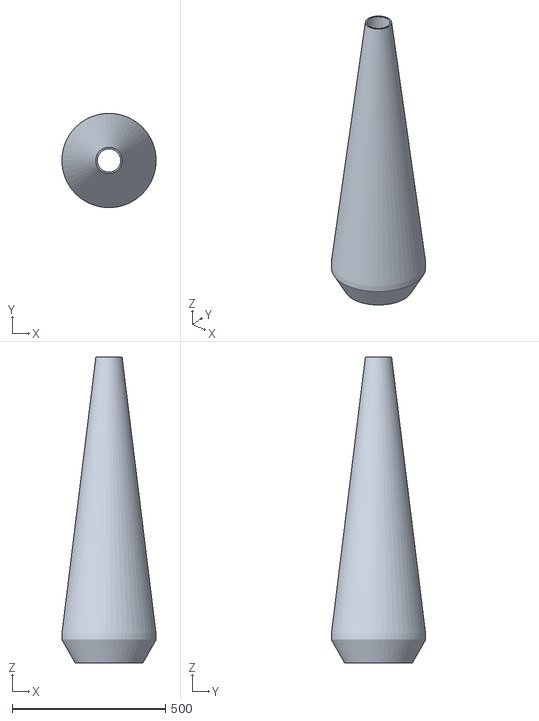
[picture p53: CAD file, 2023-02-24]
5.1/experiments/clas12/ddvcs/cad/moeller_cone.stl
307.5 x 307.5 x 998.3
