gemc/clas12Tags_old/5.1/experiments/clas12/htcc/cad/htccCone.stl

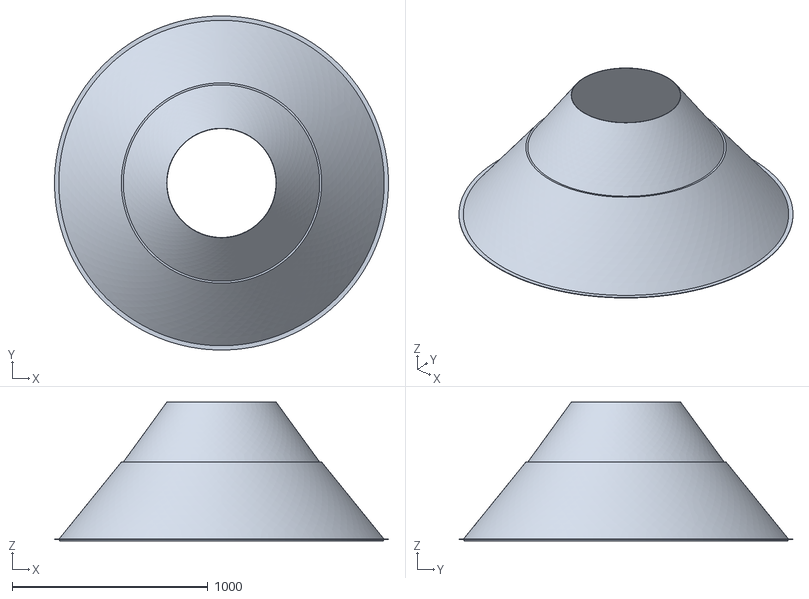
[picture p54: CAD file, 2021-12-09]
5.1/experiments/clas12/htcc/cad/htccCone.stl
1708.0 x 1707.9 x 708.9
