gemc/clas12Tags_old/5.1/experiments/clas12/ltcc/cad/S1-TB.stl

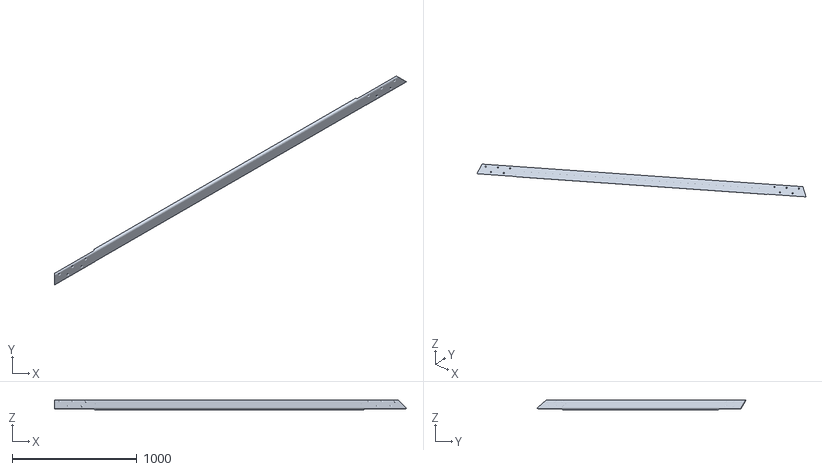
[picture p55: CAD file, 2017-04-17]
5.1/experiments/clas12/ltcc/cad/S1-TB.stl
2820.1 x 1674.6 x 82.8
