gemc/clas12Tags_old/5.1/experiments/clas12/ltcc/cad_cone/WC_M.stl

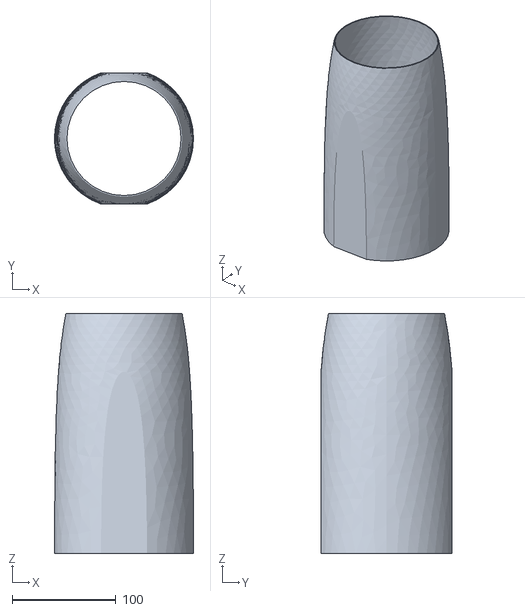
[picture p56: CAD file, 2017-04-17]
5.1/experiments/clas12/ltcc/cad_cone/WC_M.stl
134.0 x 126.5 x 231.3
