gemc/clas12Tags_old/5.1/experiments/clas12/magnets/cad/Plate3.stl

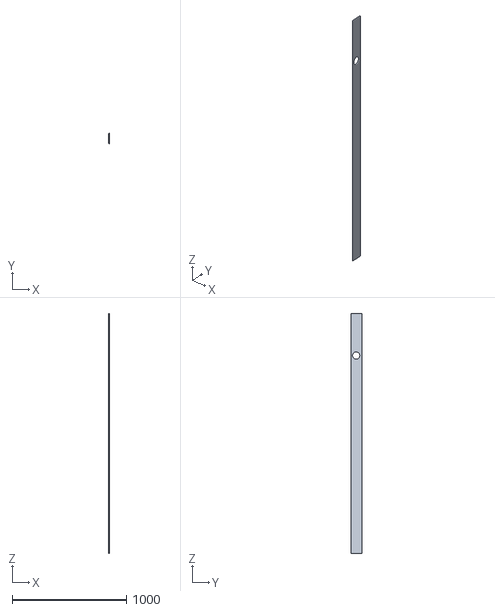
[picture p57: CAD file, 2017-07-05]
5.1/experiments/clas12/magnets/cad/Plate3.stl
6.35 x 95.9 x 2102.5
