gemc/clas12Tags_old/5.1/experiments/clas12/nuclearTargetTest/cad/TargetFoam2.stl

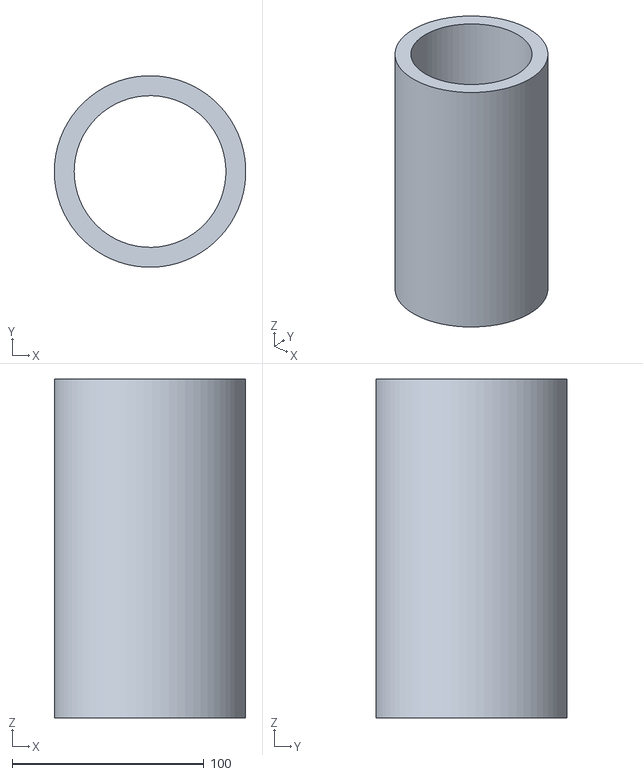
[picture p58: CAD file, 2017-08-30]
5.1/experiments/clas12/nuclearTargetTest/cad/TargetFoam2.stl
100.0 x 100.0 x 177.0
