gemc/clas12Tags_old/5.1/experiments/clas12/rich_sector4/javacad/RICH_s4.stl

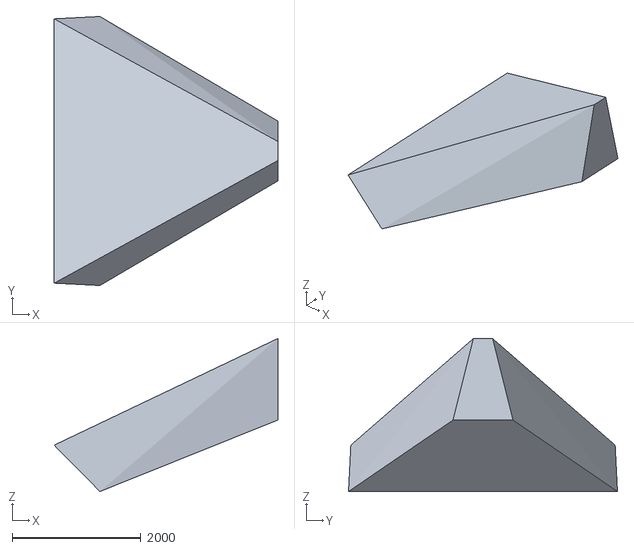
[picture p59: CAD file, 2022-03-03]
5.1/experiments/clas12/rich_sector4/javacad/RICH_s4.stl
3472.1 x 4176.0 x 2375.3
