gemc/clas12Tags_old/5.1/experiments/clas12/targets/cad/TargetBaseTubeTorlon.stl

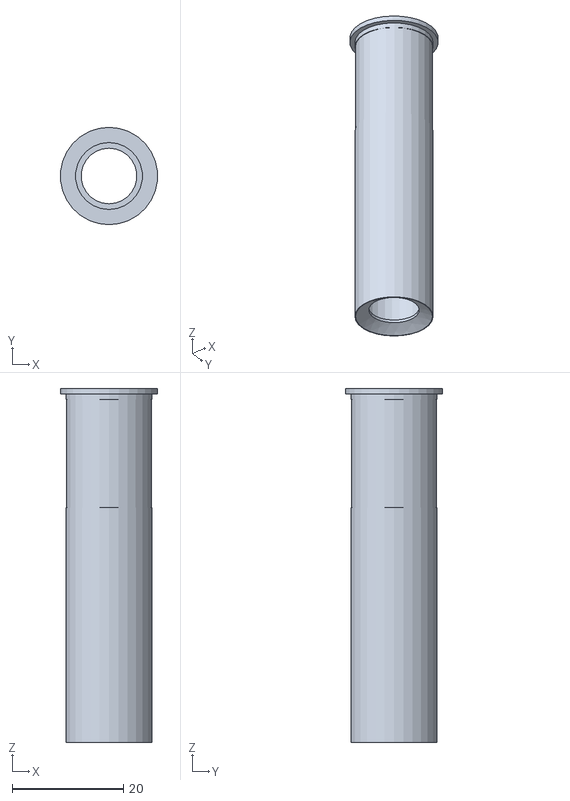
[picture p60: CAD file, 2017-08-30]
5.1/experiments/clas12/targets/cad/TargetBaseTubeTorlon.stl
17.4 x 17.5 x 63.7
