gemc/clas12Tags_old/5.1/experiments/clas12/targets/cade/TargetAlWindowD.stl

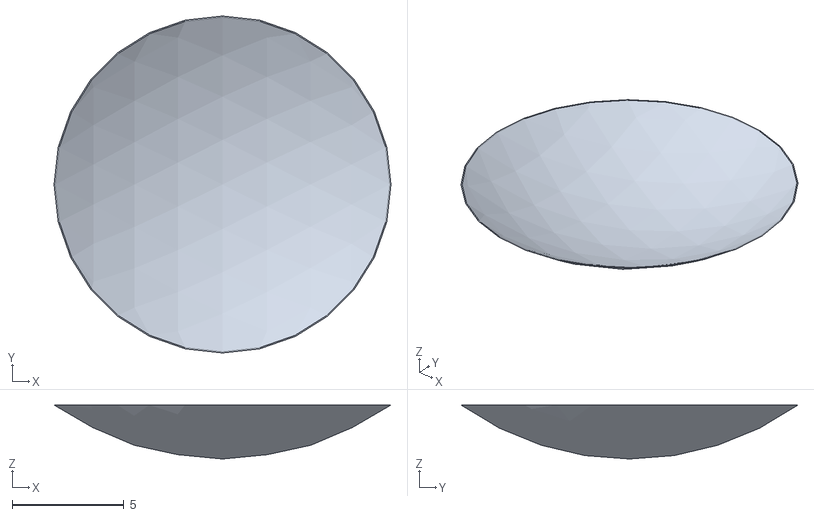
[picture p61: CAD file, 2017-08-30]
5.1/experiments/clas12/targets/cade/TargetAlWindowD.stl
15.1 x 15.1 x 2.41
