gemc/clas12Tags_old/5.1/experiments/clas12/targets/EG2p/secondRohacellSpacer.stl

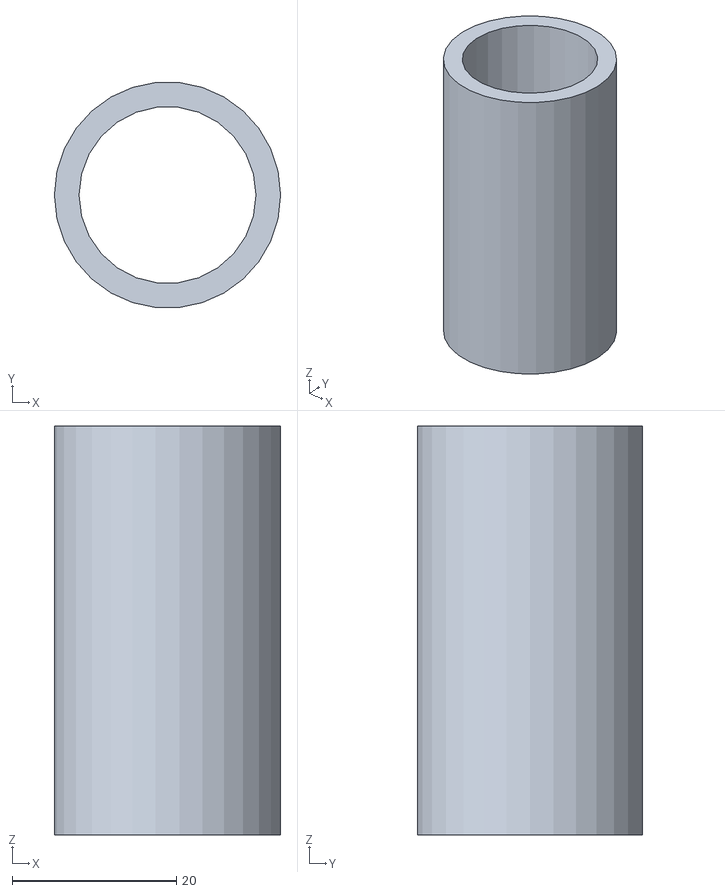
[picture p62: CAD file, 2019-04-11]
5.1/experiments/clas12/targets/EG2p/secondRohacellSpacer.stl
27.5 x 27.4 x 49.8
