gemc/clas12Tags_old/5.1/experiments/clas12/targets/hdIce/mgb2cylinder.stp

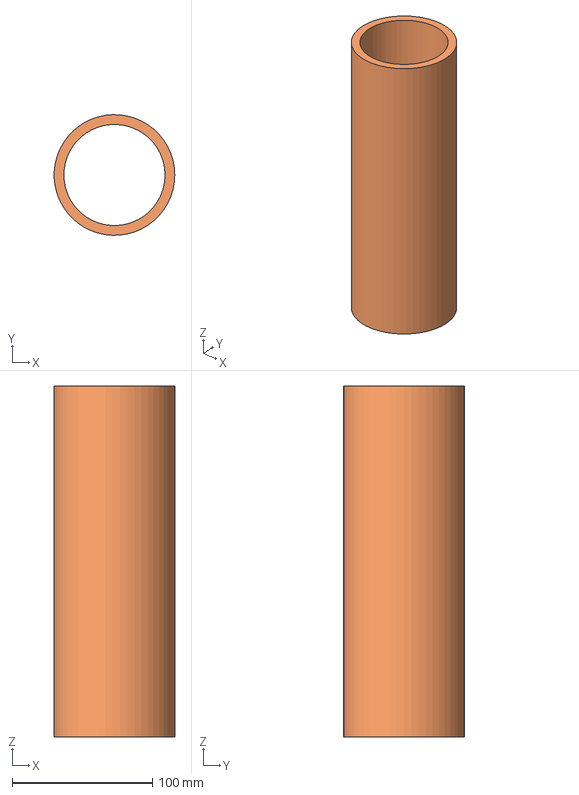
[picture p63: CAD file, 2021-04-02]
5.1/experiments/clas12/targets/hdIce/mgb2cylinder.stp
85.9 x 86.0 x 250.0 mm
