gemc/clas12Tags_old/5.1/experiments/clas12/targets/ltarget/deverter.stl

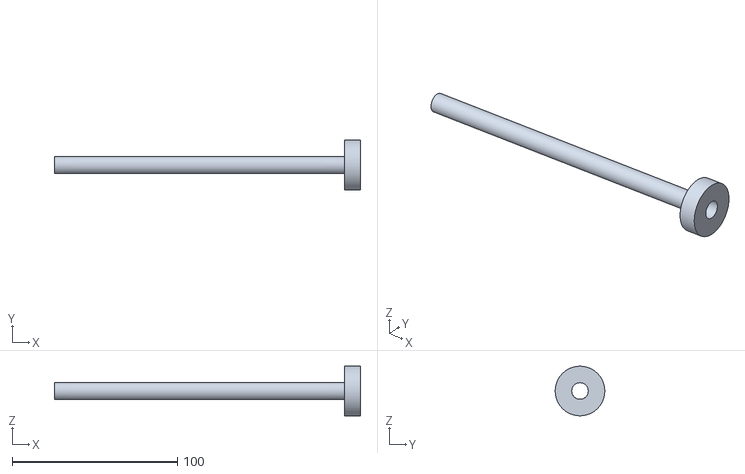
[picture p64: CAD file, 2021-04-02]
5.1/experiments/clas12/targets/ltarget/deverter.stl
185.0 x 30.0 x 30.0
