gemc/clas12Tags_old/5.1/experiments/clas12/targets/transverseTargetCad/InnerRSSheetMIR1.stl

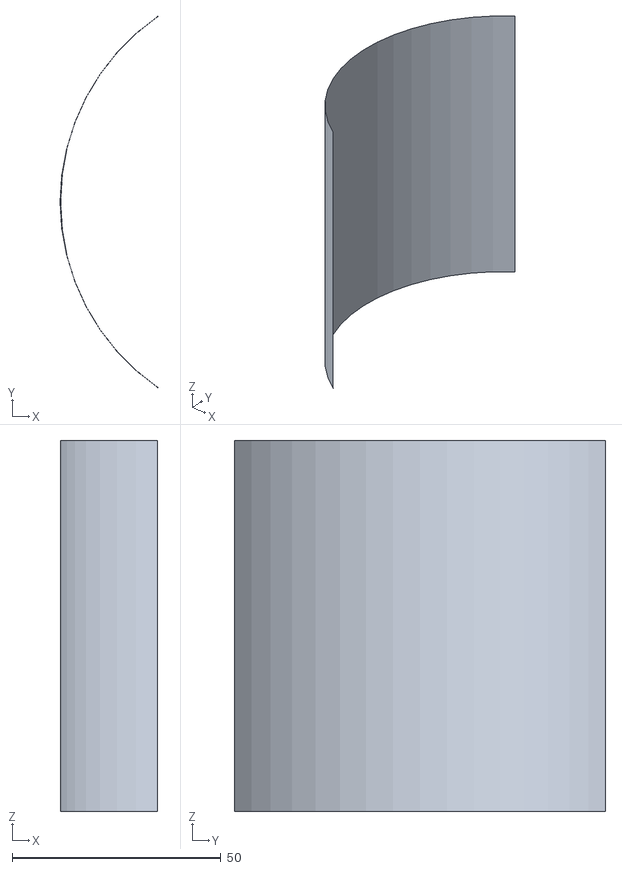
[picture p65: CAD file, 2021-07-07]
5.1/experiments/clas12/targets/transverseTargetCad/InnerRSSheetMIR1.stl
23.4 x 88.9 x 88.9
