gemc/clas12Tags_old/5.1/experiments/forFun/cad/truck.stl

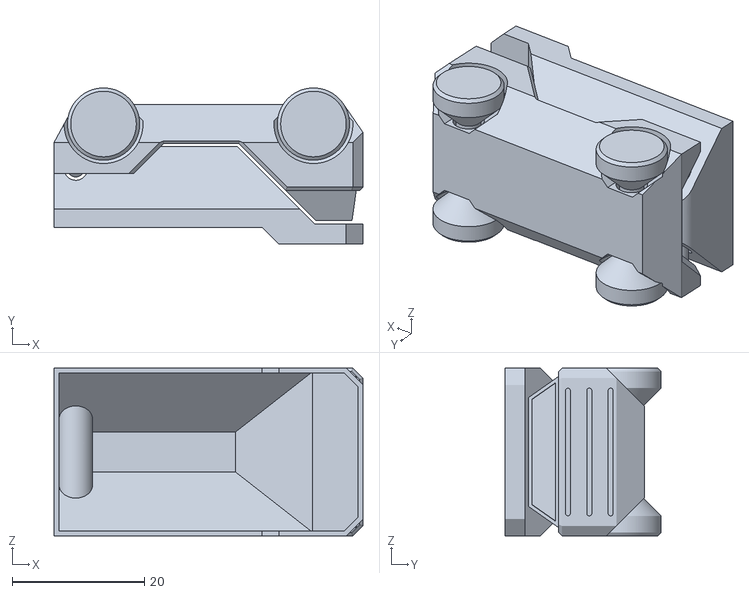
[picture p66: CAD file, 2016-12-02]
5.1/experiments/forFun/cad/truck.stl
46.7 x 23.6 x 25.4
