gemc/clas12Tags_old/5.1/experiments/humanBody/cad/brain.stl

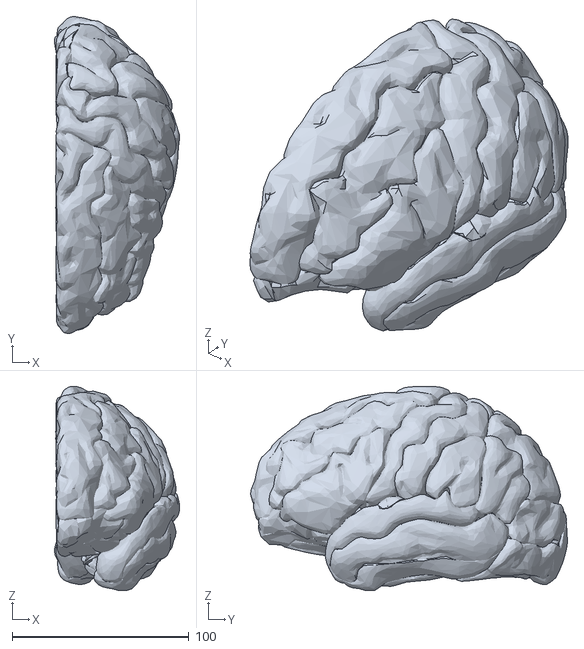
[picture p67: CAD file, 2016-12-02]
5.1/experiments/humanBody/cad/brain.stl
71.0 x 179.6 x 115.8
