gemc/clas12Tags_old/4.4.2/experiments/clas12/beamline/cadBeamline/DSShieldFlange.stl

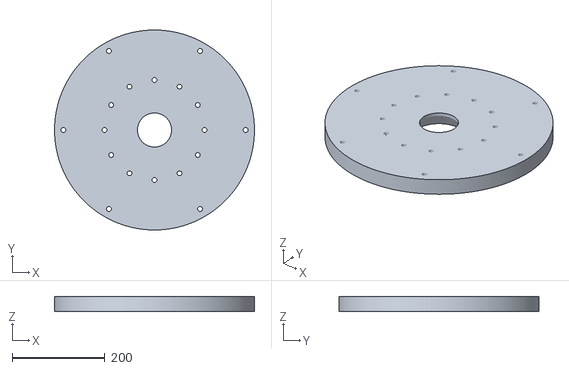
[picture p68: CAD file, 2017-10-10]
4.4.2/experiments/clas12/beamline/cadBeamline/DSShieldFlange.stl
431.8 x 431.7 x 31.8
