gemc/clas12Tags_old/4.4.2/experiments/clas12/beamline/cadBeamlineELMO/DSShieldFlangeAttachment.stl

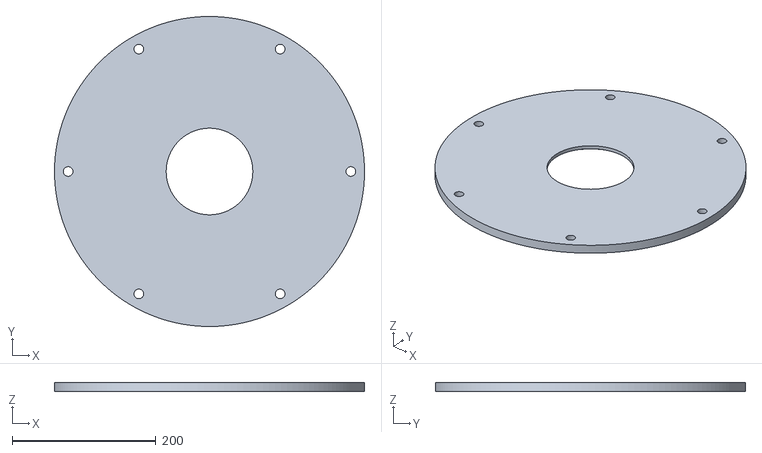
[picture p69: CAD file, 2017-10-10]
4.4.2/experiments/clas12/beamline/cadBeamlineELMO/DSShieldFlangeAttachment.stl
431.8 x 431.8 x 12.7
