gemc/clas12Tags_old/5.1/experiments/atlas/cad/SmallBarrel.stl

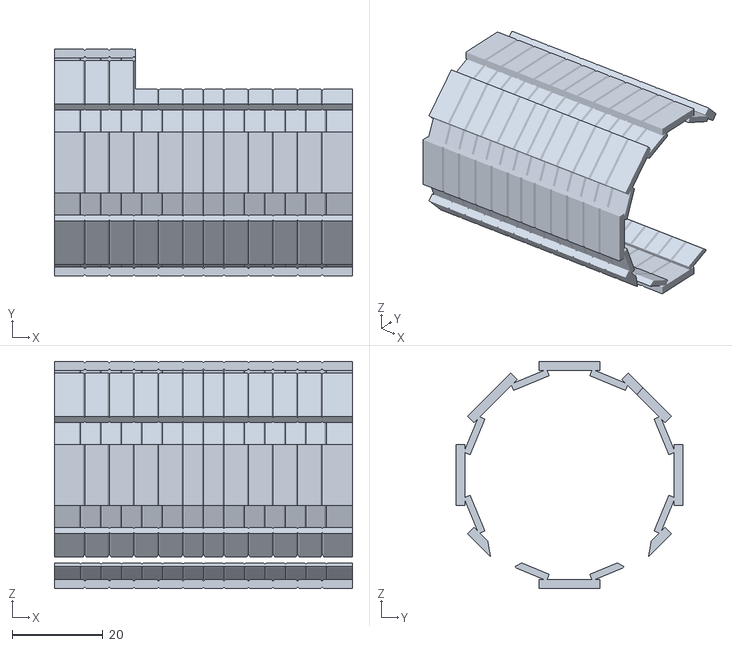
[picture p70: CAD file, 2018-10-09]
5.1/experiments/atlas/cad/SmallBarrel.stl
65.5 x 50.0 x 50.0
