gemc/clas12Tags_old/5.1/experiments/clas12/beamline/vacuumLine/connectTorusToDownstreamPipe.stl

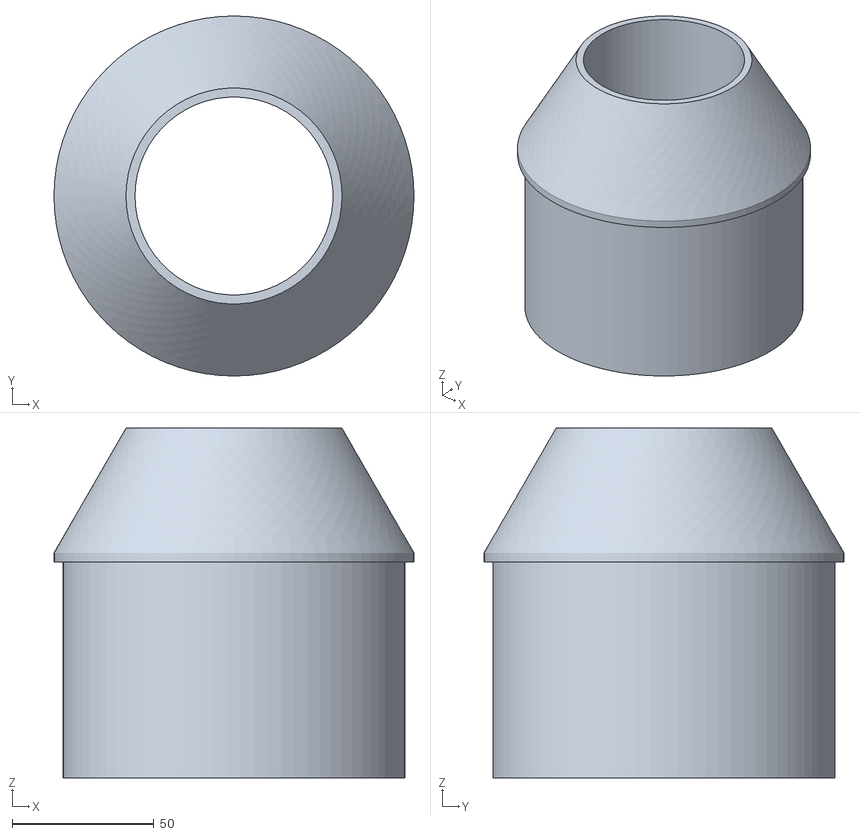
[picture p71: CAD file, 2017-10-10]
5.1/experiments/clas12/beamline/vacuumLine/connectTorusToDownstreamPipe.stl
127.0 x 127.0 x 123.4
