gemc/clas12Tags_old/5.1/experiments/clas12/ctof/javacad_default_upstream/lgu08.stl

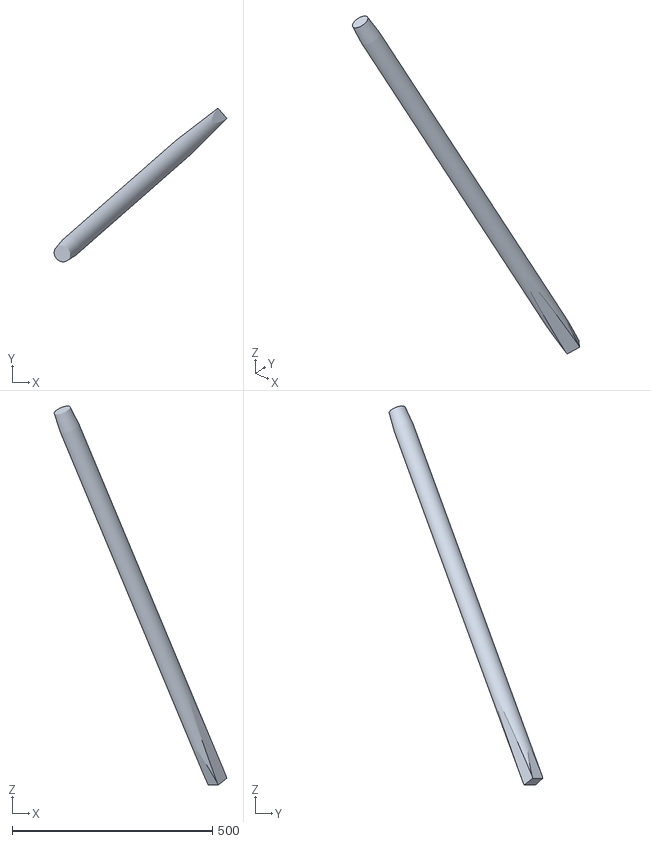
[picture p72: CAD file, 2017-07-05]
5.1/experiments/clas12/ctof/javacad_default_upstream/lgu08.stl
430.8 x 383.6 x 945.6
