gemc/clas12Tags_old/5.1/experiments/clas12/ctof/javacad_rga_fall2018/sc42.stl

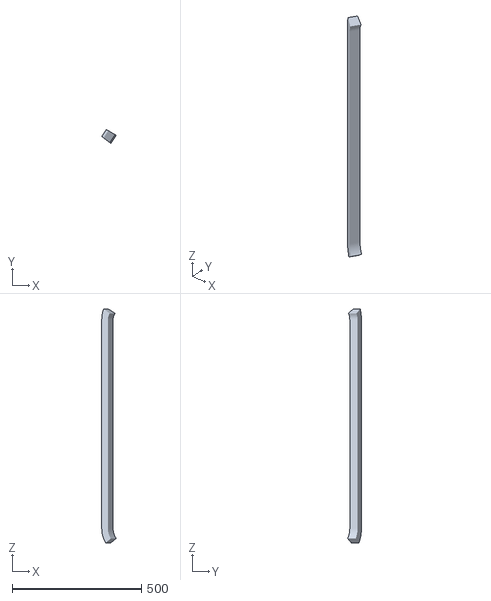
[picture p73: CAD file, 2017-07-05]
5.1/experiments/clas12/ctof/javacad_rga_fall2018/sc42.stl
56.2 x 53.6 x 904.3
