gemc/clas12Tags_old/5.1/experiments/clas12/htcc/cad/htccMollerConeExt.stl

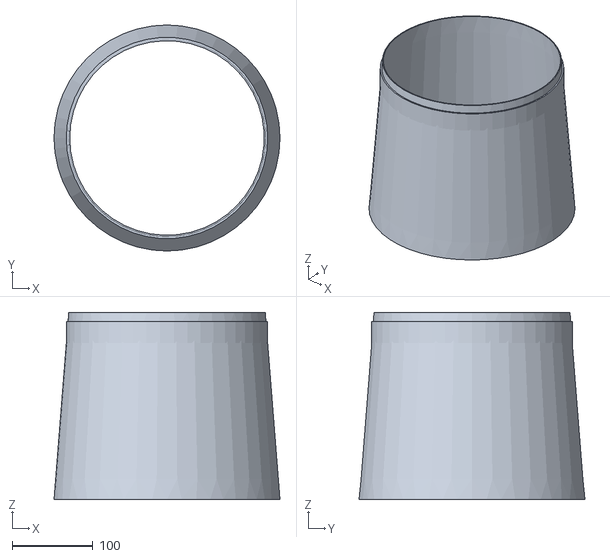
[picture p75: CAD file, 2021-12-09]
5.1/experiments/clas12/htcc/cad/htccMollerConeExt.stl
280.2 x 280.2 x 232.0
