gemc/clas12Tags_old/5.1/experiments/clas12/ltcc/cad/S1-BRB.stl

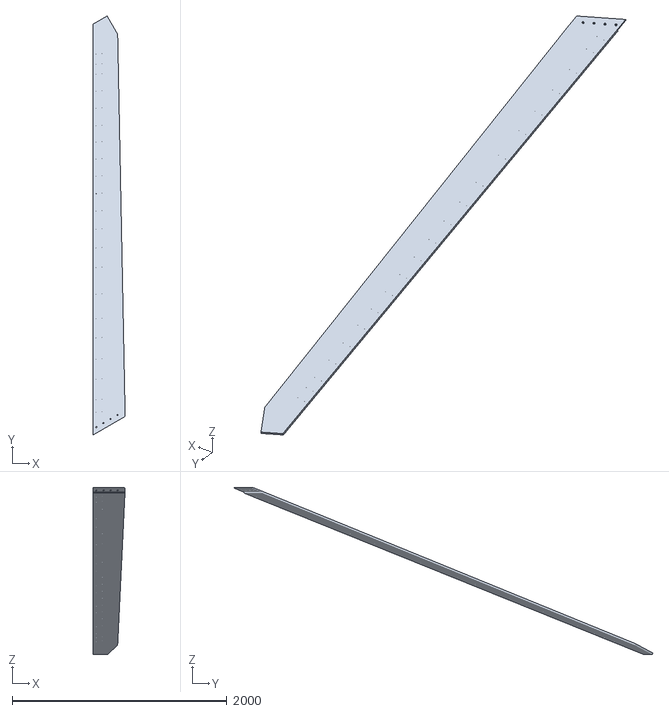
[picture p76: CAD file, 2017-04-17]
5.1/experiments/clas12/ltcc/cad/S1-BRB.stl
297.9 x 3906.4 x 1559.5
