gemc/clas12Tags_old/5.1/experiments/clas12/ltcc/cad_cone/WC_L.stl

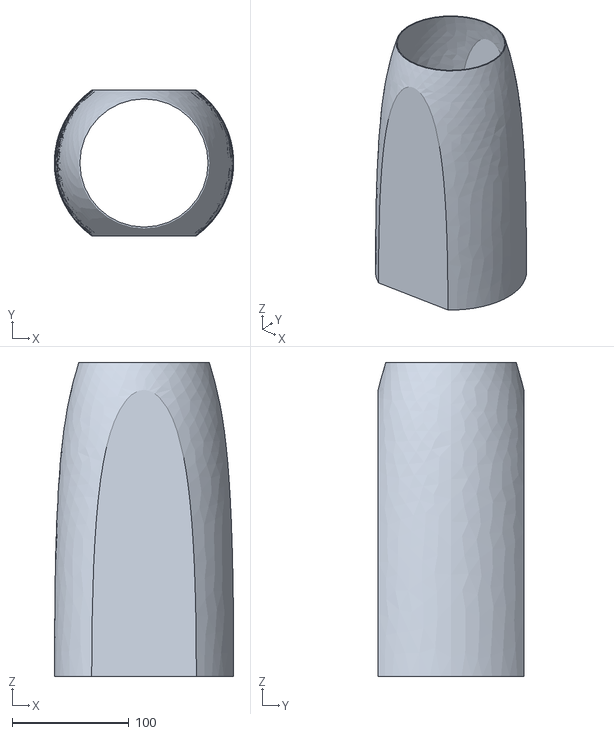
[picture p77: CAD file, 2017-04-17]
5.1/experiments/clas12/ltcc/cad_cone/WC_L.stl
154.0 x 125.1 x 269.4
