gemc/clas12Tags_old/5.1/experiments/clas12/magnets/cad/shell6b.stl

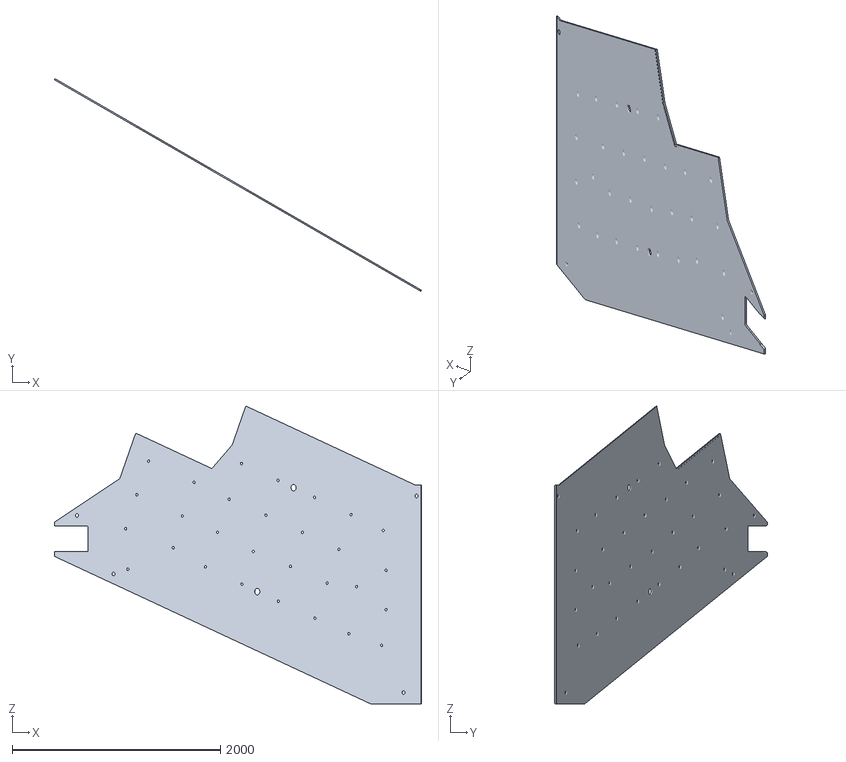
[picture p78: CAD file, 2017-07-05]
5.1/experiments/clas12/magnets/cad/shell6b.stl
3527.0 x 2044.1 x 2859.1
