gemc/clas12Tags_old/5.1/experiments/clas12/nuclearTargetTest/cad/TargetFoam3.stl

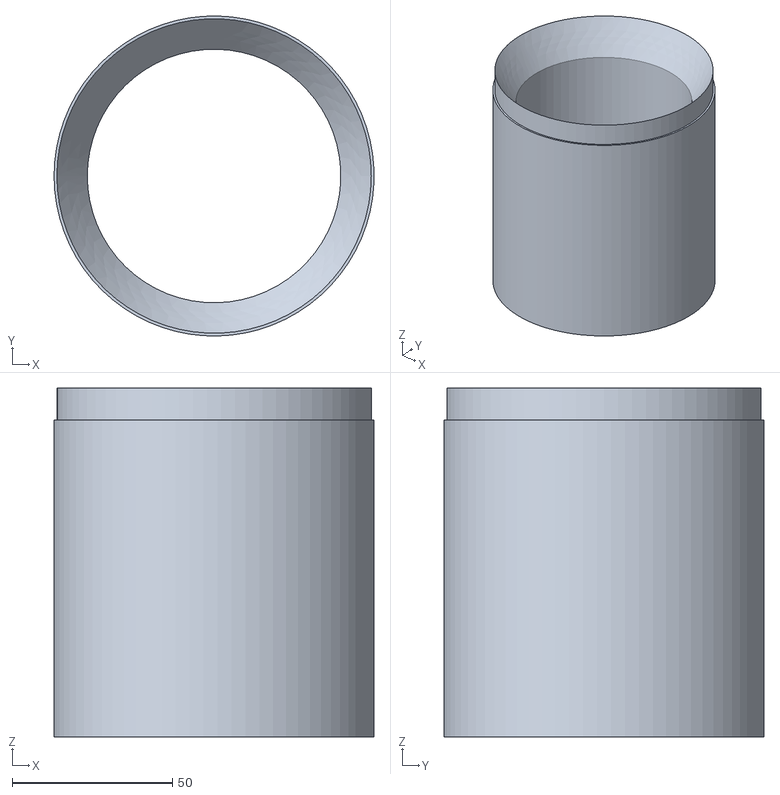
[picture p79: CAD file, 2017-08-30]
5.1/experiments/clas12/nuclearTargetTest/cad/TargetFoam3.stl
100.0 x 100.0 x 109.0
