gemc/clas12Tags_old/5.1/experiments/clas12/rich_sector4/javacad/Layer_204_component_10.stl

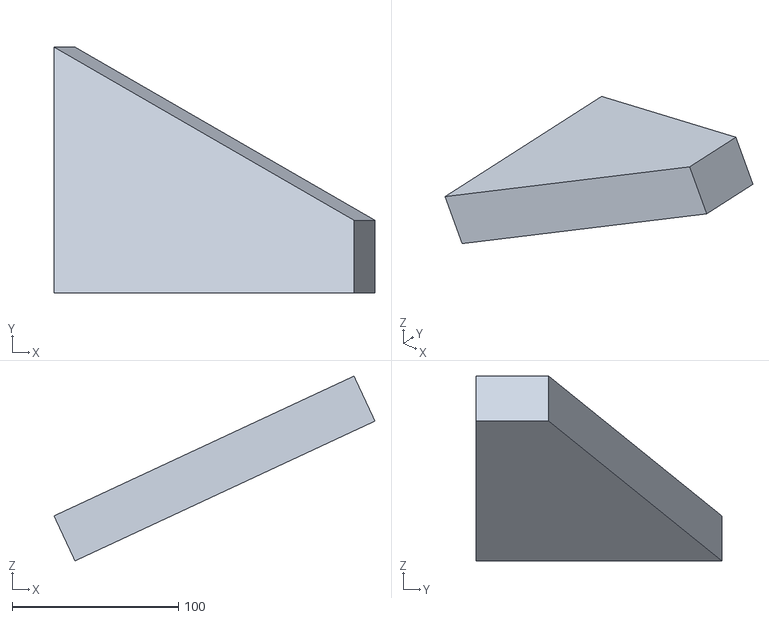
[picture p80: CAD file, 2022-02-14]
5.1/experiments/clas12/rich_sector4/javacad/Layer_204_component_10.stl
193.4 x 148.1 x 111.4
