gemc/clas12Tags_old/5.1/experiments/clas12/targets/cade/TargetWindowAdapterTorlon.stl

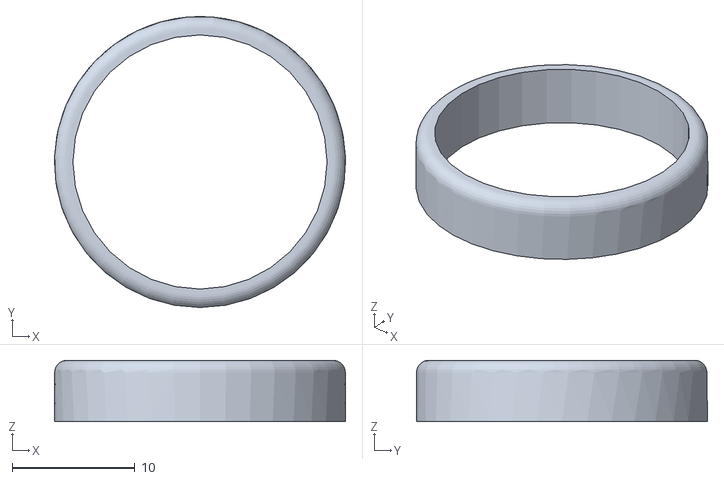
[picture p81: CAD file, 2017-08-30]
5.1/experiments/clas12/targets/cade/TargetWindowAdapterTorlon.stl
23.7 x 23.7 x 5.00
