gemc/clas12Tags_old/5.1/experiments/clas12/targets/EG2p/cellendcap.stl

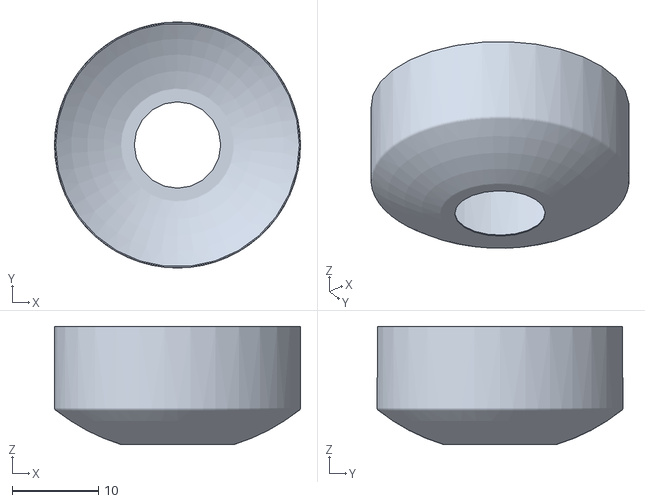
[picture p82: CAD file, 2019-04-11]
5.1/experiments/clas12/targets/EG2p/cellendcap.stl
28.5 x 28.5 x 13.7
