gemc/clas12Tags_old/5.1/experiments/clas12/targets/hdIce/superinsulator.step

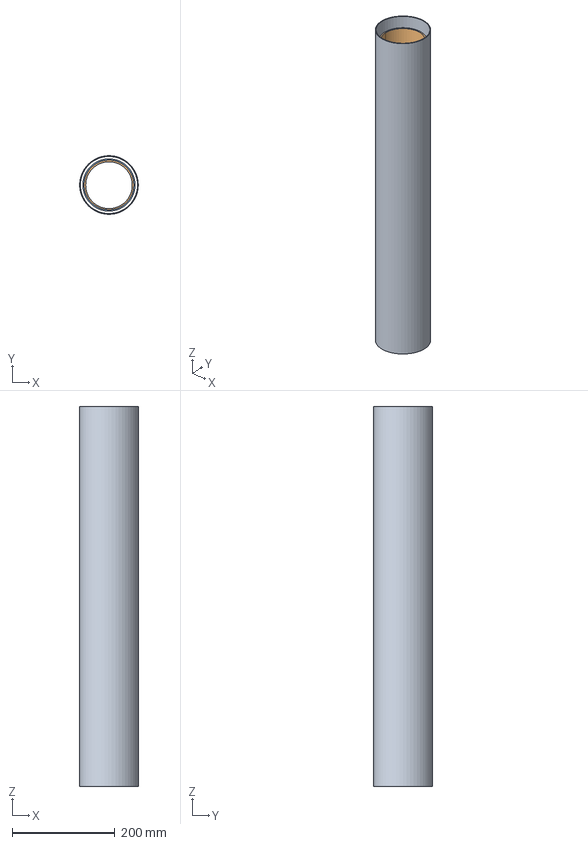
[picture p83: CAD file, 2021-04-02]
5.1/experiments/clas12/targets/hdIce/superinsulator.step
114.1 x 114.1 x 738.9 mm
