gemc/clas12Tags_old/5.1/experiments/clas12/targets/ltarget/beam_window.stl

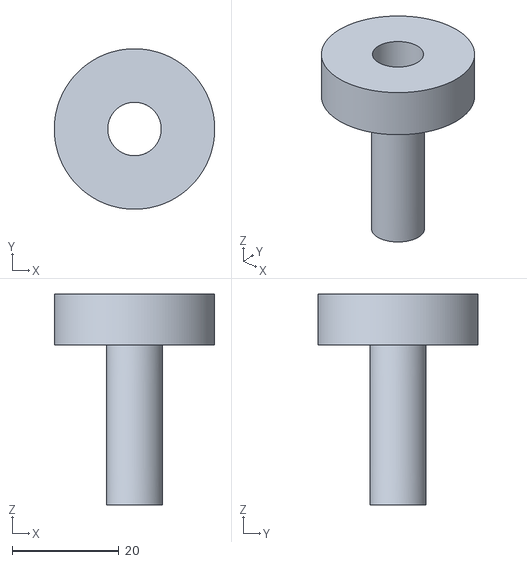
[picture p84: CAD file, 2021-04-02]
5.1/experiments/clas12/targets/ltarget/beam_window.stl
30.0 x 30.0 x 39.4
