gemc/clas12Tags_old/5.1/experiments/clas12/targets/transverseTargetCad/Pumpline60mm.stl

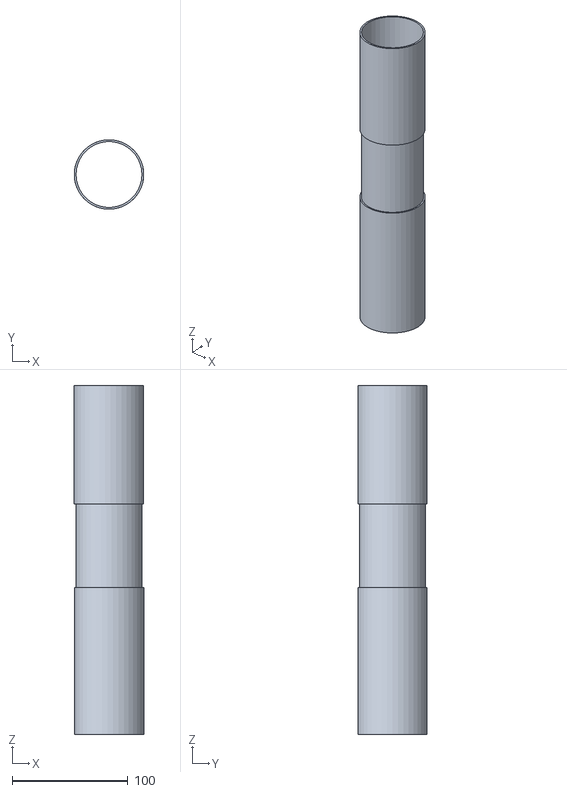
[picture p85: CAD file, 2021-07-07]
5.1/experiments/clas12/targets/transverseTargetCad/Pumpline60mm.stl
60.0 x 60.0 x 301.3
