gemc/clas12Tags_old/5.1/experiments/forFun/cad/enterprise.stl

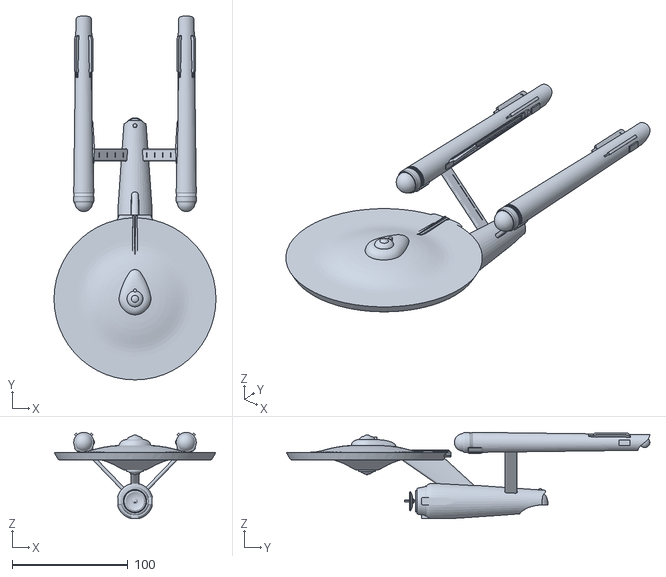
[picture p86: CAD file, 2016-12-02]
5.1/experiments/forFun/cad/enterprise.stl
140.0 x 314.4 x 74.7
