gemc/clas12Tags_old/5.1/experiments/humanBody/cad/Upper_GI.stl

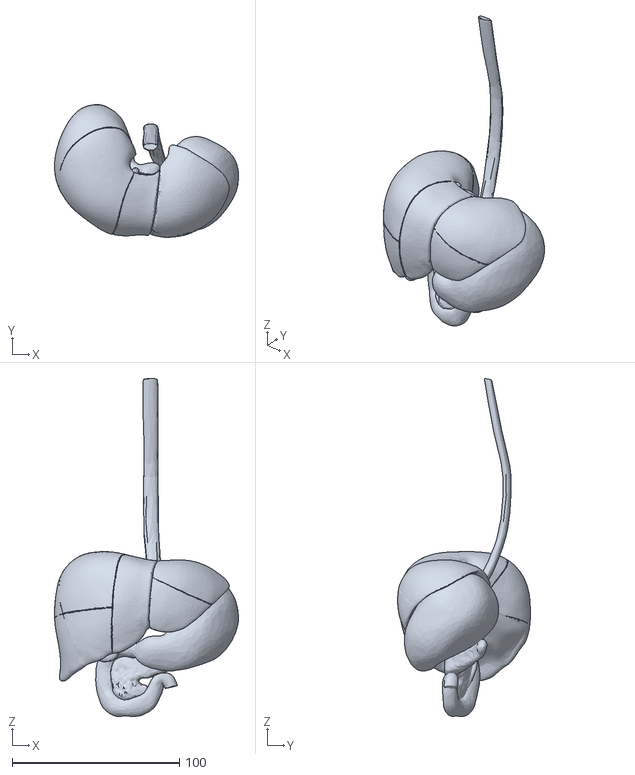
[picture p87: CAD file, 2016-12-02]
5.1/experiments/humanBody/cad/Upper_GI.stl
110.3 x 79.5 x 202.4
