gemc/clas12Tags_old/5.1/experiments/atlas/cad/ForwardShield.stl

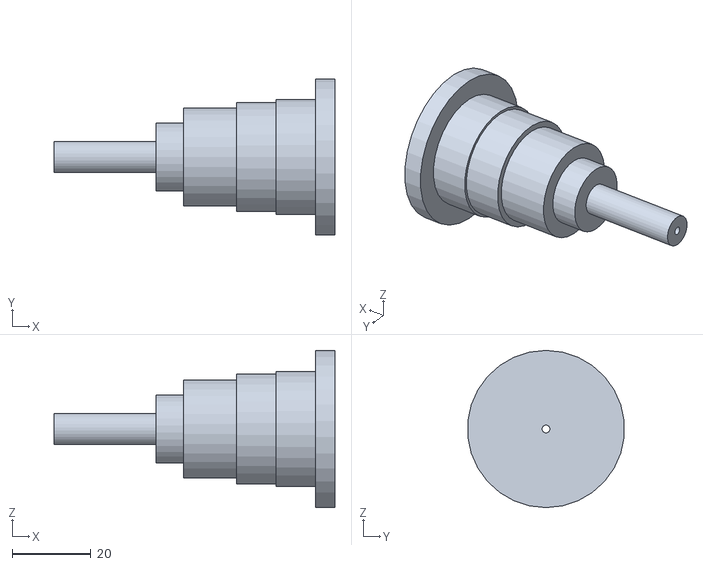
[picture p88: CAD file, 2018-10-09]
5.1/experiments/atlas/cad/ForwardShield.stl
71.5 x 39.8 x 40.0
