gemc/clas12Tags_old/5.1/experiments/clas12/ctof/javacad_default/sc26.stl

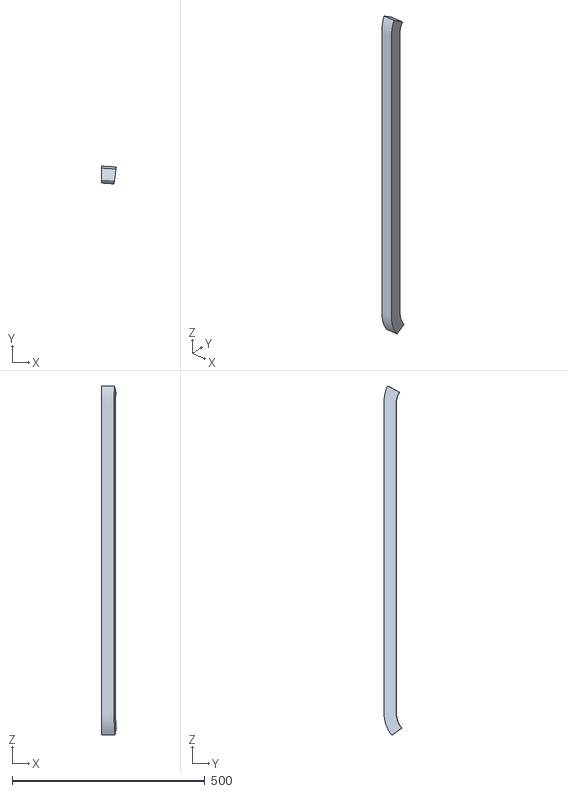
[picture p89: CAD file, 2017-07-05]
5.1/experiments/clas12/ctof/javacad_default/sc26.stl
37.8 x 46.3 x 904.3
