gemc/clas12Tags_old/5.1/experiments/clas12/ctof/javacad_rga_fall2018/lgd16.stl

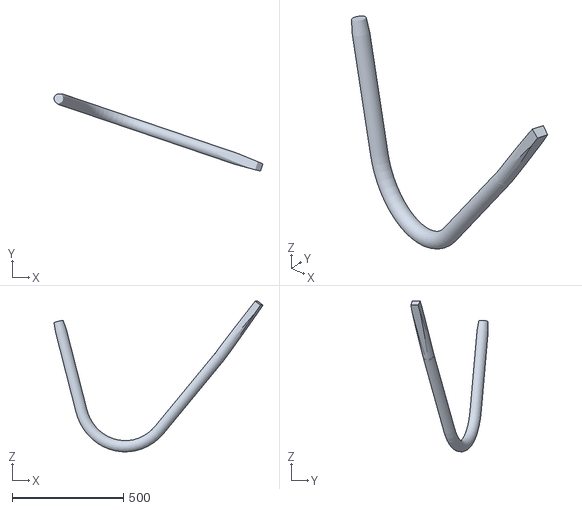
[picture p90: CAD file, 2017-07-05]
5.1/experiments/clas12/ctof/javacad_rga_fall2018/lgd16.stl
939.4 x 348.0 x 677.2
