gemc/clas12Tags_old/5.1/experiments/clas12/ctof/javacad_rga_fall2018_upstream/lgu23.stl

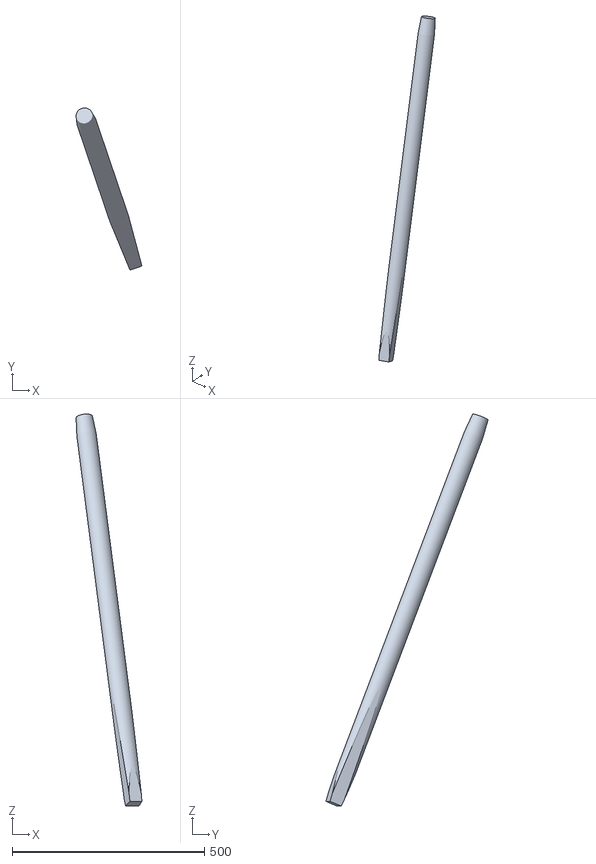
[picture p91: CAD file, 2017-07-05]
5.1/experiments/clas12/ctof/javacad_rga_fall2018_upstream/lgu23.stl
171.4 x 421.6 x 1019.2
