gemc/clas12Tags_old/5.1/experiments/clas12/ctof/javacad_rga_spring2018/lgd19.stl

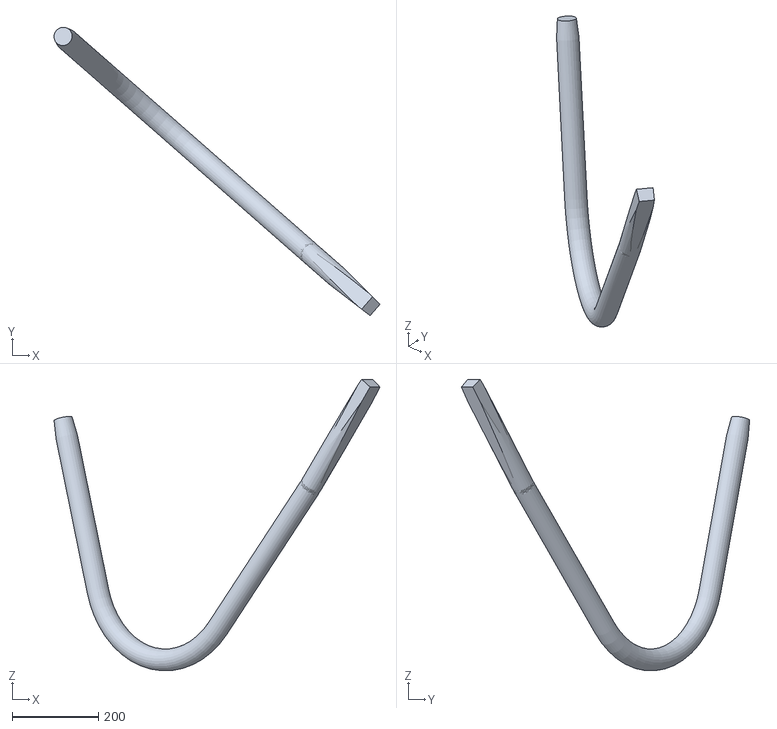
[picture p92: CAD file, 2017-07-05]
5.1/experiments/clas12/ctof/javacad_rga_spring2018/lgd19.stl
757.5 x 669.9 x 677.2
