gemc/clas12Tags_old/5.1/experiments/clas12/ctof/javacad_rga_spring2018_upstream/lgu37.stl

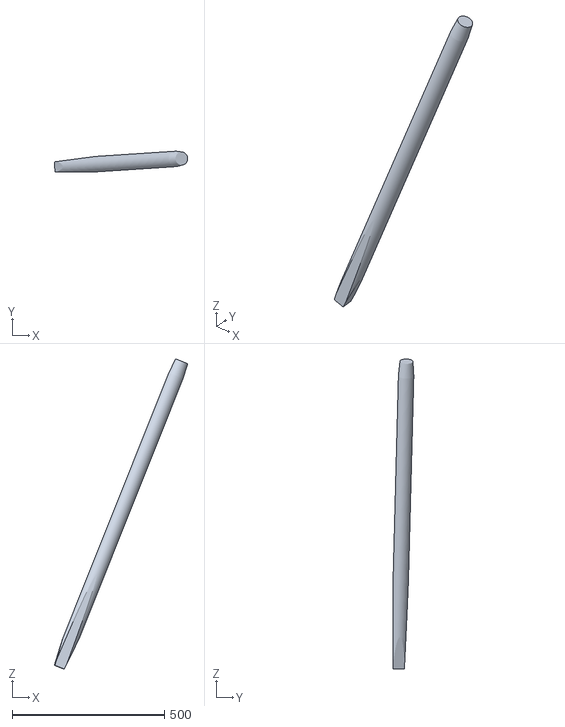
[picture p93: CAD file, 2017-07-05]
5.1/experiments/clas12/ctof/javacad_rga_spring2018_upstream/lgu37.stl
438.5 x 67.9 x 1019.2
