gemc/clas12Tags_old/5.1/experiments/clas12/ddvcs/cad/crystal_shell.stl

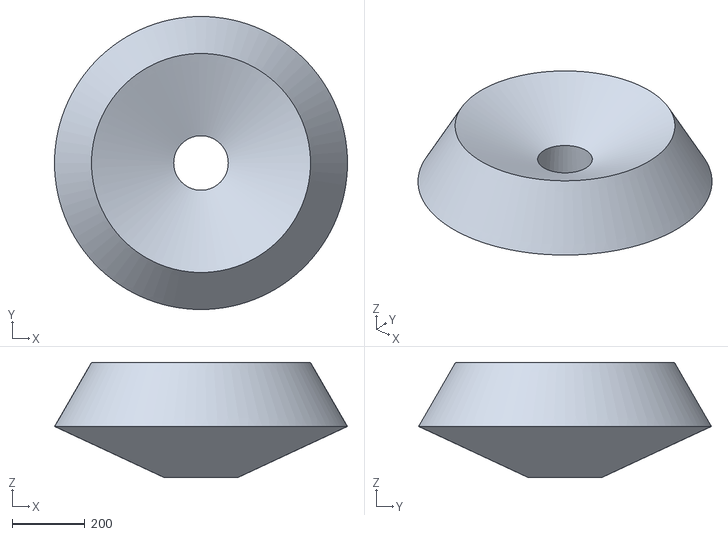
[picture p94: CAD file, 2023-02-24]
5.1/experiments/clas12/ddvcs/cad/crystal_shell.stl
807.5 x 807.5 x 317.7
