gemc/clas12Tags_old/5.1/experiments/clas12/ltcc/cad/S1-BB.stl

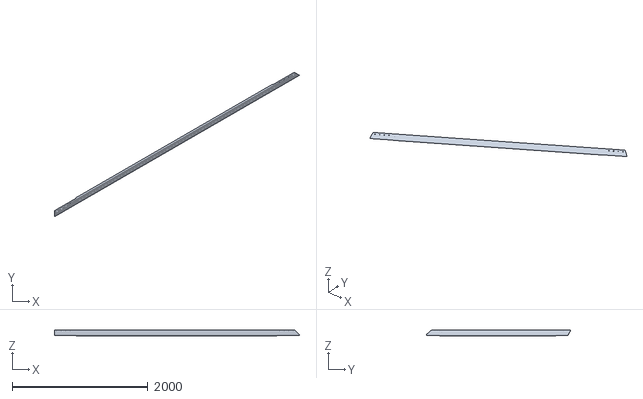
[picture p95: CAD file, 2017-04-17]
5.1/experiments/clas12/ltcc/cad/S1-BB.stl
3606.1 x 2126.0 x 89.8
