gemc/clas12Tags_old/5.1/experiments/clas12/magnets/cad/shell5a.stl

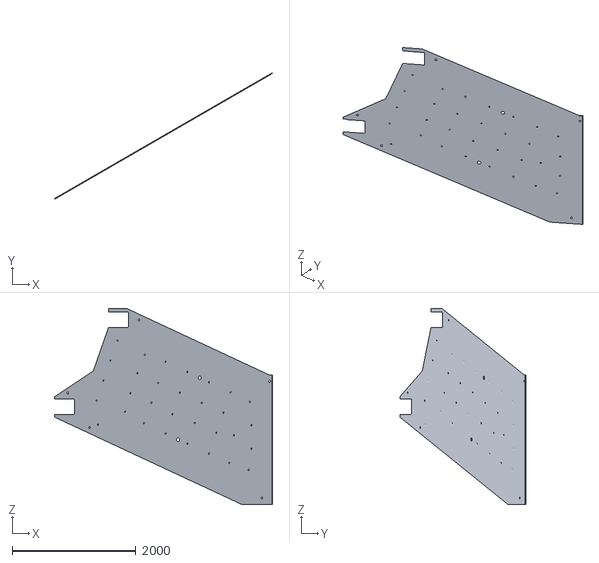
[picture p96: CAD file, 2017-07-05]
5.1/experiments/clas12/magnets/cad/shell5a.stl
3527.0 x 2044.1 x 3176.2
