gemc/clas12Tags_old/5.1/experiments/clas12/rich_sector4/javacad/Layer_203_component_25.stl

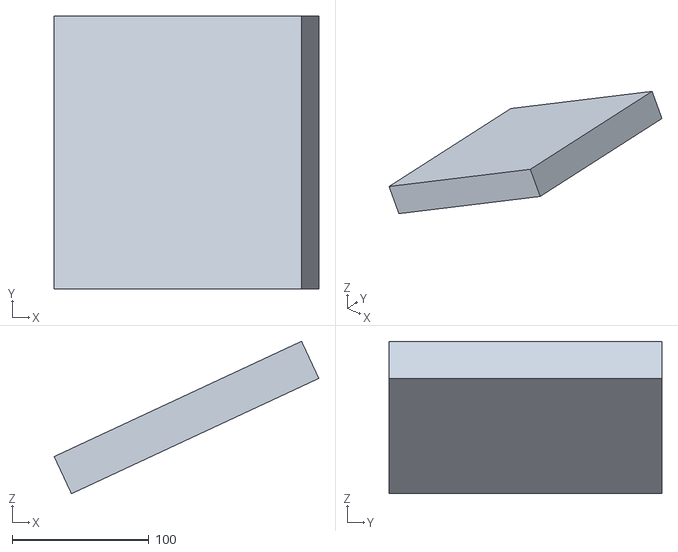
[picture p97: CAD file, 2022-02-14]
5.1/experiments/clas12/rich_sector4/javacad/Layer_203_component_25.stl
193.4 x 199.4 x 111.4
