gemc/clas12Tags_old/5.1/experiments/clas12/targets/cad/TargetWallKapton.stl

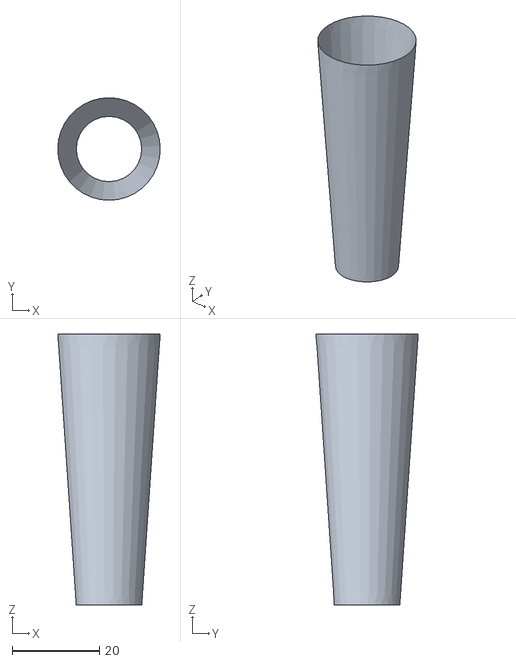
[picture p98: CAD file, 2017-08-30]
5.1/experiments/clas12/targets/cad/TargetWallKapton.stl
23.5 x 23.5 x 62.2
