gemc/clas12Tags_old/5.1/experiments/clas12/targets/hdIce/LHeCan_SS.stl

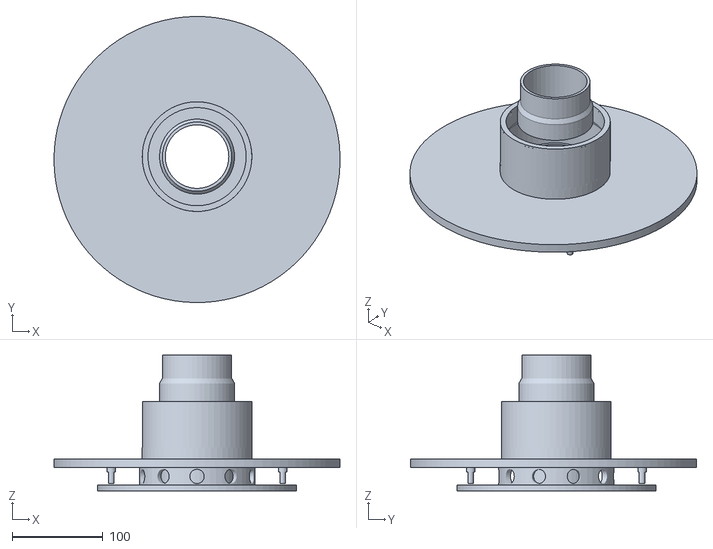
[picture p99: CAD file, 2021-04-02]
5.1/experiments/clas12/targets/hdIce/LHeCan_SS.stl
314.6 x 314.7 x 149.2
