gemc/clas12Tags_old/5.1/experiments/clas12/targets/ltarget/flow_entrance001.stl

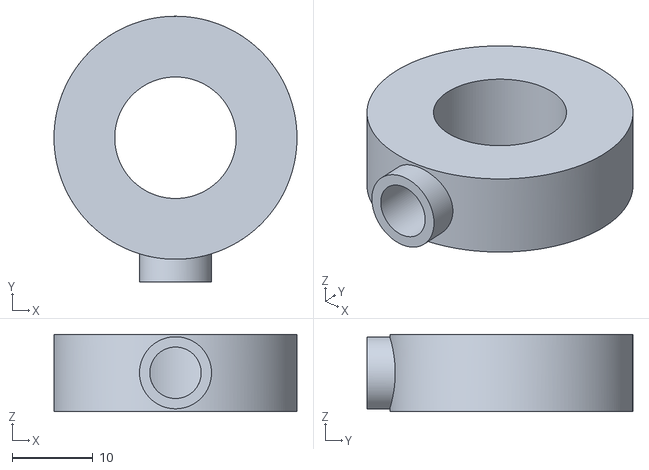
[picture p100: CAD file, 2021-04-02]
5.1/experiments/clas12/targets/ltarget/flow_entrance001.stl
30.0 x 32.8 x 9.52
