gemc/clas12Tags_old/5.1/experiments/clas12/targets/transverseTargetCad/UpstreamRS.stl

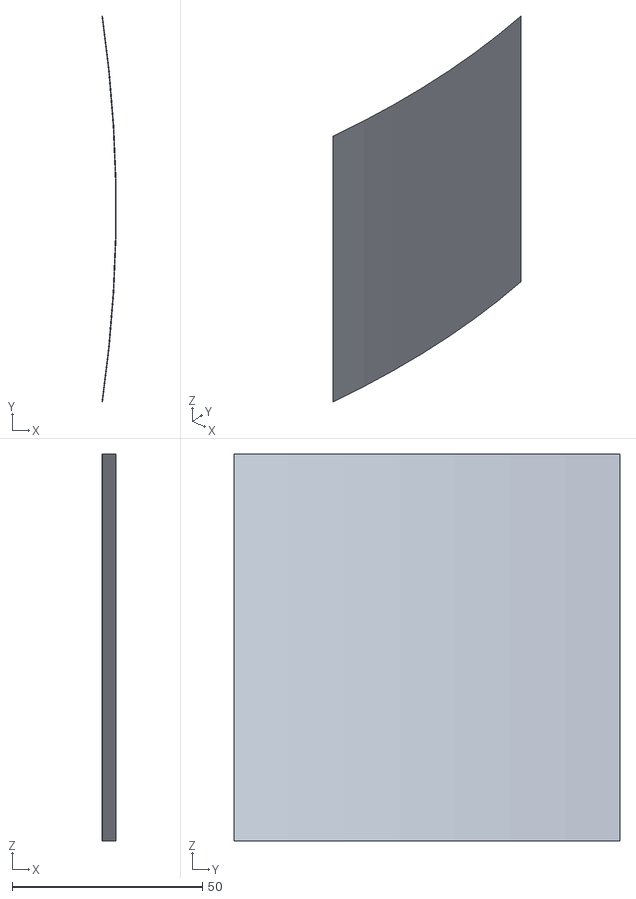
[picture p101: CAD file, 2021-07-07]
5.1/experiments/clas12/targets/transverseTargetCad/UpstreamRS.stl
3.61 x 101.3 x 101.6
