gemc/clas12Tags_old/5.1/experiments/humanBody/cad/Lower_GI.stl

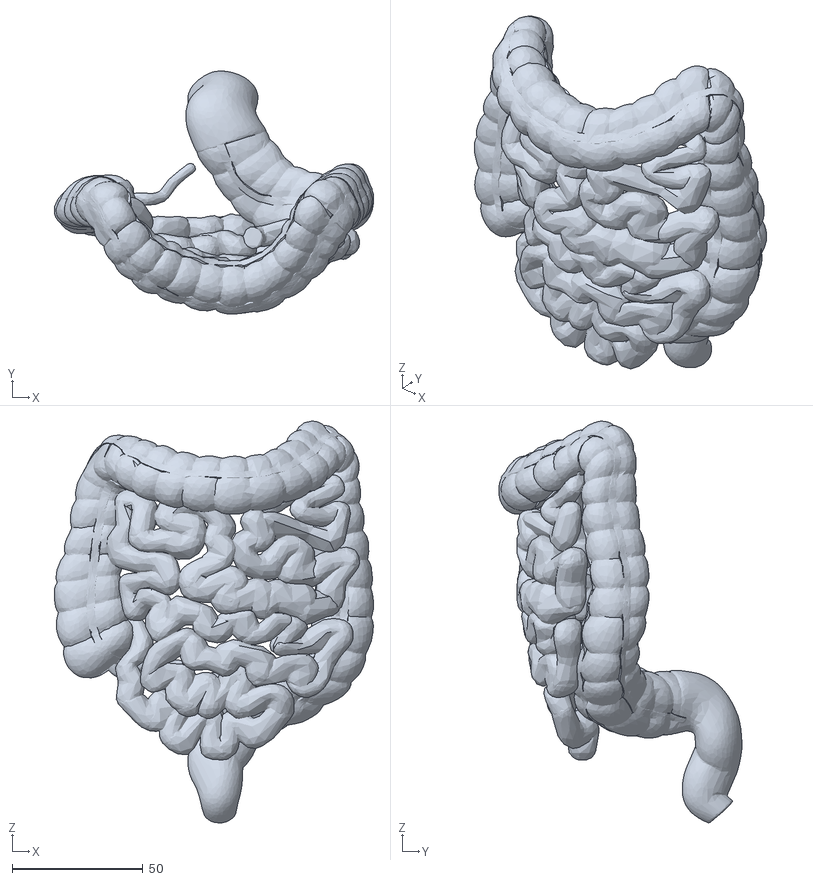
[picture p102: CAD file, 2016-12-02]
5.1/experiments/humanBody/cad/Lower_GI.stl
122.1 x 92.8 x 153.7
