gemc/clas12Tags_old/(list of files, cad)

Other CAD files:
5.1/experiments/clas12/ctof/javacad_rga_fall2018_upstream/lgu15.stl
4.4.2/experiments/clas12/ctof/javacad_rga_fall2018/sc45.stl
4.4.2/experiments/clas12/ctof/javacad_rga_spring2018/lgd09.stl
5.1/experiments/clas12/ctof/javacad_rga_spring2018/lgd10.stl
4.4.2/experiments/clas12/ctof/javacad_default/lgd03.stl
4.4.2/experiments/clas12/ctof/javacad_rga_fall2018/lgd37.stl
4.4.2/experiments/clas12/ctof/javacad_rga_spring2018/lgd03.stl
5.1/experiments/clas12/ctof/javacad_default/lgd27.stl
5.1/experiments/clas12/ctof/javacad_rga_fall2018_upstream/lgu24.stl
5.1/experiments/clas12/ctof/javacad_rga_spring2018/lgd33.stl
5.1/experiments/clas12/ctof/javacad_rga_spring2018_upstream/lgu28.stl
4.4.2/experiments/clas12/ctof/javacad_default/sc43.stl
4.4.2/experiments/clas12/ctof/javacad_rga_fall2018/lgd33.stl
5.1/experiments/clas12/targets/cade/TargetAlWindowU.stl
5.1/experiments/clas12/targets/EG2p/cellAlwindow.stl
4.3.0/experiments/clas12/beamline/cadBeamline/adjuster1.stl
4.3.0/experiments/clas12/beamline/cadBeamline/adjuster2.stl
4.3.0/experiments/clas12/beamline/cadBeamline/adjuster3.stl
4.3.0/experiments/clas12/beamline/cadBeamline/innerShieldAndFlange.stl
4.3.0/experiments/clas12/beamline/cadBeamline/nut1.stl
4.3.0/experiments/clas12/beamline/cadBeamline/nut2.stl
4.3.0/experiments/clas12/beamline/cadBeamline/nut3.stl
4.3.0/experiments/clas12/beamline/cadBeamline/nut4.stl
4.3.0/experiments/clas12/beamline/cadBeamline/nut5.stl
4.3.0/experiments/clas12/beamline/cadBeamline/nut6.stl
4.3.0/experiments/clas12/beamline/cadBeamline/nut7.stl
4.3.0/experiments/clas12/beamline/cadBeamline/nut8.stl
4.3.0/experiments/clas12/beamline/cadBeamline/nut9.stl
4.3.0/experiments/clas12/beamline/cadBeamline/outerFlange.stl
4.3.0/experiments/clas12/beamline/cadBeamline/outerMount.stl
4.3.0/experiments/clas12/beamline/cadBeamline/taggerInnerShield.stl
4.3.0/experiments/clas12/beamline/cadBeamlineFTOFF/adjuster1.stl
4.3.0/experiments/clas12/beamline/cadBeamlineFTOFF/adjuster2.stl
4.3.0/experiments/clas12/beamline/cadBeamlineFTOFF/adjuster3.stl
4.3.0/experiments/clas12/beamline/cadBeamlineFTOFF/cone-tip.stl
4.3.0/experiments/clas12/beamline/cadBeamlineFTOFF/innerShieldAndFlange.stl
4.3.0/experiments/clas12/beamline/cadBeamlineFTOFF/lead-shield.stl
4.3.0/experiments/clas12/beamline/cadBeamlineFTOFF/nut1.stl
4.3.0/experiments/clas12/beamline/cadBeamlineFTOFF/nut2.stl
4.3.0/experiments/clas12/beamline/cadBeamlineFTOFF/nut3.stl
4.3.0/experiments/clas12/beamline/cadBeamlineFTOFF/nut4.stl
4.3.0/experiments/clas12/beamline/cadBeamlineFTOFF/nut5.stl
4.3.0/experiments/clas12/beamline/cadBeamlineFTOFF/nut6.stl
4.3.0/experiments/clas12/beamline/cadBeamlineFTOFF/nut7.stl
4.3.0/experiments/clas12/beamline/cadBeamlineFTOFF/nut8.stl
4.3.0/experiments/clas12/beamline/cadBeamlineFTOFF/nut9.stl
4.3.0/experiments/clas12/beamline/cadBeamlineFTOFF/outer-cone.stl
4.3.0/experiments/clas12/beamline/cadBeamlineFTOFF/outerFlange.stl
4.3.0/experiments/clas12/beamline/cadBeamlineFTOFF/outerMount.stl
4.3.0/experiments/clas12/beamline/cadBeamlineFTOFF/taggerInnerShield.stl
4.3.0/experiments/clas12/ctof/javacad/lgd01.stl
4.3.0/experiments/clas12/ctof/javacad/lgd02.stl
4.3.0/experiments/clas12/ctof/javacad/lgd03.stl
4.3.0/experiments/clas12/ctof/javacad/lgd04.stl
4.3.0/experiments/clas12/ctof/javacad/lgd05.stl
4.3.0/experiments/clas12/ctof/javacad/lgd07.stl
4.3.0/experiments/clas12/ctof/javacad/lgd08.stl
4.3.0/experiments/clas12/ctof/javacad/lgd09.stl
4.3.0/experiments/clas12/ctof/javacad/lgd10.stl
4.3.0/experiments/clas12/ctof/javacad/lgd11.stl
4.3.0/experiments/clas12/ctof/javacad/lgd13.stl
4.3.0/experiments/clas12/ctof/javacad/lgd15.stl
4.3.0/experiments/clas12/ctof/javacad/lgd18.stl
4.3.0/experiments/clas12/ctof/javacad/lgd20.stl
4.3.0/experiments/clas12/ctof/javacad/lgd21.stl
4.3.0/experiments/clas12/ctof/javacad/lgd22.stl
4.3.0/experiments/clas12/ctof/javacad/lgd23.stl
4.3.0/experiments/clas12/ctof/javacad/lgd24.stl
4.3.0/experiments/clas12/ctof/javacad/lgd25.stl
4.3.0/experiments/clas12/ctof/javacad/lgd26.stl
4.3.0/experiments/clas12/ctof/javacad/lgd27.stl
4.3.0/experiments/clas12/ctof/javacad/lgd28.stl
4.3.0/experiments/clas12/ctof/javacad/lgd29.stl
4.3.0/experiments/clas12/ctof/javacad/lgd30.stl
4.3.0/experiments/clas12/ctof/javacad/lgd31.stl
4.3.0/experiments/clas12/ctof/javacad/lgd32.stl
4.3.0/experiments/clas12/ctof/javacad/lgd33.stl
4.3.0/experiments/clas12/ctof/javacad/lgd34.stl
4.3.0/experiments/clas12/ctof/javacad/lgd35.stl
4.3.0/experiments/clas12/ctof/javacad/lgd36.stl
4.3.0/experiments/clas12/ctof/javacad/lgd37.stl
4.3.0/experiments/clas12/ctof/javacad/lgd38.stl
4.3.0/experiments/clas12/ctof/javacad/lgd39.stl
4.3.0/experiments/clas12/ctof/javacad/lgd40.stl
4.3.0/experiments/clas12/ctof/javacad/lgd41.stl
4.3.0/experiments/clas12/ctof/javacad/lgd42.stl
4.3.0/experiments/clas12/ctof/javacad/lgd43.stl
4.3.0/experiments/clas12/ctof/javacad/lgd44.stl
4.3.0/experiments/clas12/ctof/javacad/lgd45.stl
4.3.0/experiments/clas12/ctof/javacad/lgd46.stl
4.3.0/experiments/clas12/ctof/javacad/lgd47.stl
4.3.0/experiments/clas12/ctof/javacad/lgd48.stl
4.3.0/experiments/clas12/ctof/javacad/sc02.stl
4.3.0/experiments/clas12/ctof/javacad/sc03.stl
4.3.0/experiments/clas12/ctof/javacad/sc04.stl
4.3.0/experiments/clas12/ctof/javacad/sc05.stl
4.3.0/experiments/clas12/ctof/javacad/sc06.stl
4.3.0/experiments/clas12/ctof/javacad/sc07.stl
4.3.0/experiments/clas12/ctof/javacad/sc08.stl
4.3.0/experiments/clas12/ctof/javacad/sc09.stl
4.3.0/experiments/clas12/ctof/javacad/sc10.stl
4.3.0/experiments/clas12/ctof/javacad/sc11.stl
4.3.0/experiments/clas12/ctof/javacad/sc12.stl
4.3.0/experiments/clas12/ctof/javacad/sc13.stl
4.3.0/experiments/clas12/ctof/javacad/sc14.stl
4.3.0/experiments/clas12/ctof/javacad/sc15.stl
4.3.0/experiments/clas12/ctof/javacad/sc16.stl
4.3.0/experiments/clas12/ctof/javacad/sc18.stl
4.3.0/experiments/clas12/ctof/javacad/sc20.stl
4.3.0/experiments/clas12/ctof/javacad/sc21.stl
4.3.0/experiments/clas12/ctof/javacad/sc23.stl
4.3.0/experiments/clas12/ctof/javacad/sc24.stl
4.3.0/experiments/clas12/ctof/javacad/sc25.stl
4.3.0/experiments/clas12/ctof/javacad/sc27.stl
4.3.0/experiments/clas12/ctof/javacad/sc28.stl
4.3.0/experiments/clas12/ctof/javacad/sc29.stl
4.3.0/experiments/clas12/ctof/javacad/sc30.stl
4.3.0/experiments/clas12/ctof/javacad/sc31.stl
4.3.0/experiments/clas12/ctof/javacad/sc32.stl
4.3.0/experiments/clas12/ctof/javacad/sc34.stl
4.3.0/experiments/clas12/ctof/javacad/sc35.stl
4.3.0/experiments/clas12/ctof/javacad/sc36.stl
4.3.0/experiments/clas12/ctof/javacad/sc37.stl
4.3.0/experiments/clas12/ctof/javacad/sc38.stl
4.3.0/experiments/clas12/ctof/javacad/sc39.stl
4.3.0/experiments/clas12/ctof/javacad/sc40.stl
4.3.0/experiments/clas12/ctof/javacad/sc41.stl
4.3.0/experiments/clas12/ctof/javacad/sc43.stl
4.3.0/experiments/clas12/ctof/javacad/sc44.stl
4.3.0/experiments/clas12/ctof/javacad/sc45.stl
4.3.0/experiments/clas12/ctof/javacad/sc46.stl
4.3.0/experiments/clas12/ctof/javacad/sc47.stl
4.3.0/experiments/clas12/ctof/javacad/sc48.stl
4.3.0/experiments/clas12/targets/cad/TargetAlWindowU.stl
4.3.0/experiments/clas12/targets/cad/TargetEndCapKapton.stl
4.3.0/experiments/clas12/targets/cadShifted/TargetAlWindowU.stl
4.3.0/experiments/clas12/targets/cadShifted/TargetEndCapKapton.stl
4.3.1/experiments/clas12/beamline/cadBeamline/adjuster1.stl
4.3.1/experiments/clas12/beamline/cadBeamline/adjuster2.stl
4.3.1/experiments/clas12/beamline/cadBeamline/adjuster3.stl
4.3.1/experiments/clas12/beamline/cadBeamline/innerShieldAndFlange.stl
4.3.1/experiments/clas12/beamline/cadBeamline/nut1.stl
4.3.1/experiments/clas12/beamline/cadBeamline/nut2.stl
4.3.1/experiments/clas12/beamline/cadBeamline/nut3.stl
4.3.1/experiments/clas12/beamline/cadBeamline/nut4.stl
4.3.1/experiments/clas12/beamline/cadBeamline/nut5.stl
4.3.1/experiments/clas12/beamline/cadBeamline/nut6.stl
4.3.1/experiments/clas12/beamline/cadBeamline/nut7.stl
4.3.1/experiments/clas12/beamline/cadBeamline/nut8.stl
4.3.1/experiments/clas12/beamline/cadBeamline/nut9.stl
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
