gemc/clas12Tags_old/benchmarks/template.xlsx

Paste Output of results.txt into C colum then Wizard or Data > text to colum and chose space as delimiter
 |  |  |  | seconds | hours
Number of Events: | 5000 | Estimated Time For | 5000 | 11835.7 | 3.3
 |  | Cumulative |  |  |  |  |  | Single
 | Events Time | ms / event | rate (Hz) | Estimated Time To Simulate | Absolute Ratio to total | Single System Contribution |  | rate (Hz) | ms / event | % of total
target | 6.00909 | 1.2 | 832.1 | 6.0 | 0.2% | 6.00909 | target | 832.1 | 1.2 | 0.20%
svt | 10.638 | 2.1 | 470.0 | 10.6 | 0.4% | 4.62891 | svt | 1080.2 | 0.9 | 0.16%
ctof | 12.486 | 2.5 | 400.4 | 12.5 | 0.4% | 1.848 | ctof | 2705.6 | 0.4 | 0.06%
cnd | 13.5182 | 2.7 | 369.9 | 13.5 | 0.5% | 1.0322 | cnd | 4844.0 | 0.2 | 0.04%
solenoid | 183.069 | 36.6 | 27.3 | 183.1 | 6.2% | 169.5508 | solenoid | 29.5 | 33.9 | 5.77%
mm | 313.517 | 62.7 | 15.9 | 313.5 | 10.7% | 130.448 | mm | 38.3 | 26.1 | 4.44%
htcc | 415.989 | 83.2 | 12.0 | 416.0 | 14.1% | 102.472 | htcc | 48.8 | 20.5 | 3.49%
torus | 641.352 | 128.3 | 7.8 | 641.4 | 21.8% | 225.363 | torus | 22.2 | 45.1 | 7.66%
ft | 693.802 | 138.8 | 7.2 | 693.8 | 23.6% | 52.45 | ft | 95.3 | 10.5 | 1.78%
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
