gemc/clas12Tags_old/5.1/source/hitprocess/clas12/htcc_hitprocess.cc

// G4 headers
#include "G4MaterialPropertyVector.hh"
#include "Randomize.hh"

// gemc headers
#include "htcc_hitprocess.h"
#include "detector.h"
#include <set>

// CLHEP units
#include "CLHEP/Units/PhysicalConstants.h"
using namespace CLHEP;

// ccdb
#include <CCDB/Calibration.h>
#include <CCDB/Model/Assignment.h>
#include <CCDB/CalibrationGenerator.h>
using namespace ccdb;

static htccConstants initializeHTCCConstants(int runno, string digiVariation = "default", string digiSnapshotTime = "no", bool accountForHardwareStatus = false)
{
	// all these constants should be read from CCDB
	htccConstants htccc;
	
	// do not initialize at the beginning, only after the end of the first event,
	// with the proper run number coming from options or run table
	if(runno == -1) return htccc;
	string timestamp = "";
	if(digiSnapshotTime != "no") {
		timestamp = ":"+digiSnapshotTime;
	}
	
	// database
	htccc.runNo = runno;
	if(getenv ("CCDB_CONNECTION") != nullptr)
		htccc.connection = (string) getenv("CCDB_CONNECTION");
	else
		htccc.connection = "mysql://clas12reader@clasdb.jlab.org/clas12";
	
	int isec,ilay;
	
	vector<vector<double> > data;
	
	unique_ptr<Calibration> calib(CalibrationGenerator::CreateCalibration(htccc.connection));
	
	if(accountForHardwareStatus) {
		
		cout<<"HTCC:Getting status"<<endl;
		sprintf(htccc.database,"/calibration/htcc/status:%d:%s%s", htccc.runNo, digiVariation.c_str(), timestamp.c_str());
		data.clear() ; calib->GetCalib(data,htccc.database);
		for(unsigned row = 0; row < data.size(); row++)
		{
			isec   = data[row][0]; ilay   = data[row][1];
			htccc.status[isec-1][ilay-1].push_back(data[row][3]);
		}
	}
	cout<<"HTCC:Getting mc_gain"<<endl;
	sprintf(htccc.database,"/calibration/htcc/mc_gain:%d:%s%s", htccc.runNo, digiVariation.c_str(), timestamp.c_str());
	data.clear() ; calib->GetCalib(data,htccc.database);
	for(unsigned row = 0; row < data.size(); row++)
	{
		isec   = data[row][0]; ilay   = data[row][1];
		htccc.mc_gain[isec-1][ilay-1].push_back(data[row][3]);
	}
	cout <<"HTCC:Getting mc_gain, mc_smearing" <<endl;
	sprintf(htccc.database,"/calibration/htcc/mc_smear:%d:%s%s", htccc.runNo, digiVariation.c_str(), timestamp.c_str());
	data.clear() ; calib->GetCalib(data,htccc.database);
	for(unsigned row = 0; row < data.size(); row++)
	{
		isec   = data[row][0]; ilay   = data[row][1];
		htccc.mc_smear[isec-1][ilay-1].push_back(data[row][3]);
	}
	
	
	
	
	
	cout<<"HTCC:Getting time_offset"<<endl;
	sprintf(htccc.database,"/calibration/htcc/time:%d:%s%s", htccc.runNo, digiVariation.c_str(), timestamp.c_str());
	data.clear() ; calib->GetCalib(data,htccc.database);
	for(unsigned row = 0; row < data.size(); row++) {
		isec   = data[row][0]; ilay   = data[row][1];
		htccc.tshift[isec-1][ilay-1].push_back(data[row][3]);
	}
	
	// we should read the database and and fill the Hardware object
	string database   = "/daq/tt/htcc:1";
	
	data.clear(); calib->GetCalib(data, database);
	cout << "  > " << htccc.TT.getName() << " TT Data loaded from CCDB with " << data.size() << " columns." << endl;
	
	// filling translation table
	for(unsigned row = 0; row < data.size(); row++)
	{
		int crate   = data[row][0];
		int slot    = data[row][1];
		int channel = data[row][2];
		
		int idsector = data[row][3];
		int idhalf   = data[row][4];
		int idring   = data[row][5];
		int order    = data[row][6];  // 0 Corresponds to FADC, and 2 corresponds to TDC
		
		// order is important as we could have duplicate entries w/o it
		htccc.TT.addHardwareItem({idsector, idhalf, idring, order}, Hardware(crate, slot, channel));
	}
	cout << "  > Data loaded in translation table " << htccc.TT.getName() << endl;
	
	// FOR now we will initialize pedestals and sigmas to a random value, in the future
	// they will be initialized from DB
	const double const_ped_value = 101;
	const double const_ped_sigm_value = 2;
	
	std::fill(&htccc.pedestal[0][0][0], &htccc.pedestal[0][0][0] + sizeof(htccc.pedestal)/sizeof(htccc.pedestal[0][0][0]), const_ped_value);
	std::fill(&htccc.pedestal_sigm[0][0][0], &htccc.pedestal_sigm[0][0][0] + sizeof(htccc.pedestal_sigm)/sizeof(htccc.pedestal_sigm[0][0][0]), const_ped_sigm_value);
	
	// setting voltage signal parameters
	// THese values are copied from EC and PCal code, later when we will have a better understanding
	// of signal shapes of each channel they probably can be defined channel dependent
	htccc.vpar[0] = 0.;  // delay, ns
	htccc.vpar[1] = 2.8; // rise time, ns
	htccc.vpar[2] = 20;  // fall time, ns
	htccc.vpar[3] = 1;   // amplifier
	
	return htccc;
}

map<string, double> htcc_HitProcess :: integrateDgt(MHit* aHit, int hitn)
{
	map<string, double> dgtz;
	vector<identifier> identity = aHit->GetId();
	rejectHitConditions = false;
	writeHit = true;


	int idsector = identity[0].id;
	int idring   = identity[1].id;
	int idhalf   = identity[2].id; // layer is half sector (1 or 2)
	int thisPid  = aHit->GetPID();
	
	if(aHit->isBackgroundHit == 1) {
		
		// background hit has all the nphe in the charge infp. Time is also first step
		double nphe     = aHit->GetCharge();
		double stepTime = aHit->GetTime()[0];
		
		dgtz["hitn"]   = hitn;
		
		dgtz["sector"]    = idsector;
		dgtz["layer"]     = idhalf;
		dgtz["component"] = idring;
		dgtz["ADC_order"] = 0;
		dgtz["ADC_ADC"]   = (int) nphe*100;
		dgtz["ADC_time"]  = (stepTime*24.0/1000);
		dgtz["ADC_ped"]   = 0;
		
		dgtz["TDC_order"] = 0;
		dgtz["TDC_TDC"]   = (int) stepTime;
		
		return dgtz;
	}
	
	
	trueInfos tInfos(aHit);
	
	// return if the particle is not an opticalphoton
	// notice: the optical photon PID changed from 0 to -22 with 10.7
	if(thisPid != MHit::OPTICALPHOTONPID) {
		
		return dgtz;
		
		dgtz["sector"]    = -idsector;
		dgtz["layer"]     = -idhalf;
		dgtz["component"] = -idring;
		
	}
	
	
	int ndetected;
	
	
	// Since the HTCC hit involves a PMT which detects photons with a certain quantum efficiency (QE)
	// we want to implement QE here in a flexible way:
	
	// That means we want to find out if the material of the photocathode has been defined,
	// and if so, find out if it has a material properties table which defines an efficiency.
	// if we find both of these properties, then we accept this event with probability QE:
	
	vector<int> tids = aHit->GetTIds(); // track ID at EACH STEP
	vector<int> pids = aHit->GetPIDs(); // particle ID at EACH STEP
	set<int> TIDS;                      // an array containing all UNIQUE tracks in this hit
	vector<double> photon_energies;
	
	vector<double> Energies = aHit->GetEs();
	
	// this needs to be optimized
	// uaing the return value of insert is unnecessary
	
	for(unsigned int s=0; s<tids.size(); s++)
	{
		// selecting optical photons
		if(pids[s] == MHit::OPTICALPHOTONPID)
		{
			// insert this step into the set of track ids (set can only have unique values).
			pair< set<int> ::iterator, bool> newtrack = TIDS.insert(tids[s]);
			
			// if we found a new track, then add the initial photon energy of this
			// track to the list of photon energies, for when we calculate quantum efficiency later
			if( newtrack.second ) photon_energies.push_back( Energies[s] );
		}
	}
	
	
	// here is the fun part: figure out the number of photons we detect based
	// on the quantum efficiency of the photocathode material, if defined:
	
	
	// If the detector corresponding to this hit has a material properties table with "Efficiency" defined:
	G4MaterialPropertiesTable* MPT = aHit->GetDetector().GetLogical()->GetMaterial()->GetMaterialPropertiesTable();
	G4MaterialPropertyVector* efficiency = nullptr;
	ndetected = 0;
	bool gotefficiency = false;
	if( MPT != nullptr ) {
		efficiency = (G4MaterialPropertyVector*) MPT->GetProperty("EFFICIENCY");
		if( efficiency != nullptr ) gotefficiency = true;
	}
	
	for( unsigned int iphoton = 0; iphoton<TIDS.size(); iphoton++ )
	{
		//loop over all unique photons contributing to the hit:
		if( gotefficiency )
		{
			// If the material of this detector has a material properties table
			// with "EFFICIENCY" defined, then "detect" this photon with probability = efficiency
			bool outofrange = false;
			double uniformR = G4UniformRand();
			double peff = efficiency->GetValue( photon_energies[iphoton], outofrange );
			
			if(  uniformR <= peff) {
				ndetected++;
			}
			
			if( verbosity > 4 )
			{
				cout << log_msg << " Found efficiency definition for material "
				<< aHit->GetDetector().GetLogical()->GetMaterial()->GetName()
				<< ": (Ephoton, efficiency)=(" << photon_energies[iphoton] << ", "
				<< ( (G4MaterialPropertyVector*) efficiency )->GetValue( photon_energies[iphoton], outofrange )
				<< ")" << endl;
			}
		} else {
			// No efficiency definition, "detect" all photons
			ndetected++;
		}
	}
	
	if(verbosity>4) {
		cout <<  log_msg << " (sector, ring, half)=(" << idsector << ", " << idring << ", " << idhalf << ")"
		<< " x=" << tInfos.x/cm << " y=" << tInfos.y/cm << " z=" << tInfos.z/cm << endl;
	}
	
	
	//status flags
	if(accountForHardwareStatus) {
		
		switch (htccc.status[idsector-1][idhalf-1][idring-1])
		{
			case 0:
				break;
			case 1:
				ndetected=0;
				break;
			case 2:
				tInfos.time = 0;
				
				break;
			case 3:
				tInfos.time = 0;
				ndetected = 0;
				
				break;
			case 5:
				break;
				
			default:
				cout << " > Unknown HTCC status: " << htccc.status[idsector-1][idhalf-1][idring-1] << " for sector " << idsector << ",  halfsector " << idhalf << ", ring  " << idring << endl;
		}
	}
	
	double adc  = 100 * G4RandGauss::shoot(ndetected*htccc.mc_gain[idsector-1][idhalf-1][idring-1], ndetected*htccc.mc_smear[idsector-1][idhalf-1][idring-1]);
	double time = tInfos.time + htccc.tshift[idsector-1][idhalf-1][idring-1];
	
	dgtz["hitn"]   = hitn;
	
	dgtz["sector"]    = idsector;
	dgtz["layer"]     = idhalf;
	dgtz["component"] = idring;
	dgtz["ADC_order"] = 0;
	dgtz["ADC_ADC"]   = (int) adc;
	dgtz["ADC_time"]  = time;
	dgtz["ADC_ped"]   = 0;
	
	dgtz["TDC_order"] = 0;
	dgtz["TDC_TDC"]   = (int) time;
	
	
	// define conditions to reject hit
	if(rejectHitConditions) {
		writeHit = false;
	}
	
	return dgtz;
}


vector<identifier>  htcc_HitProcess :: processID(vector<identifier> id, G4Step *step, detector Detector)
{
	id[id.size()-1].id_sharing = 1;
	return id;
}




// - electronicNoise: returns a vector of hits generated / by electronics. 
vector<MHit*> htcc_HitProcess :: electronicNoise()
{
	vector<MHit*> noiseHits;
	
	// first, identify the cells that would have electronic noise
	// then instantiate hit with energy E, time T, identifier IDF:
	//
	// MHit* thisNoiseHit = new MHit(E, T, IDF, pid);
	
	// push to noiseHits collection:
	// noiseHits.push_back(thisNoiseHit)
	
	return noiseHits;
}


map< string, vector <int> >  htcc_HitProcess :: multiDgt(MHit* aHit, int hitn)
{
	map< string, vector <int> > MH;
	return MH;
}


// - charge: returns charge/time digitized information / step
map< int, vector <double> > htcc_HitProcess :: chargeTime(MHit* aHit, int hitn)
{
	map< int, vector <double> >  CT;
	
	// Following variables that are defined, will be "KEY"s of
	// CT
	vector<double> hitNumbers;
	vector<double> stepIndex;
	vector<double> chargeAtElectronics;
	vector<double> timeAtElectronics;
	vector<double> identifiers;
	vector<double> hardware;
	
	hitNumbers.push_back(hitn);
	
	// getting identifiers
	// we want to crash if identity doesn't have size 3
	vector<identifier> identity = aHit->GetId();
	int idsector = identity[0].id;
	int idring   = identity[1].id;
	int idhalf   = identity[2].id;
	
	identifiers.push_back(idsector);
	identifiers.push_back(idhalf);
	identifiers.push_back(idring);
	identifiers.push_back(0);       // 0=> FADC, 2=>TDC
	
	// getting hardware
	Hardware thisHardware = htccc.TT.getHardware({idsector, idhalf, idring, 0}); // 0=> FADC, 2=>TDC
	hardware.push_back(thisHardware.getCrate());
	hardware.push_back(thisHardware.getSlot());
	hardware.push_back(thisHardware.getChannel());
	
	// Adding pedestal mean and sigma into the hardware as well
	// All of these variables start from 1, therefore -1 is sbutracted, e.g. sector-1
	hardware.push_back(htccc.pedestal[idsector - 1][idhalf - 1][idring - 1]);
	hardware.push_back(htccc.pedestal_sigm[idsector - 1][idhalf - 1][idring - 1]);
	
	
	// Code below is mostly copied from the integrateDgt(MHit*, int) method,
	// Main difference is that here all optical photons here one by one will be
	// added into chargeAtElectronics and timeAtElectronics, while in the
	// integrateDgt, photons were added, and the digital integration was performed.
	
	trueInfos tInfos(aHit);
	
	// Since the HTCC hit involves a PMT which detects photons with a certain quantum efficiency (QE)
	// we want to implement QE here in a flexible way:
	
	// That means we want to find out if the material of the photocathode has been defined,
	// and if so, find out if it has a material properties table which defines an efficiency.
	// if we find both of these properties, then we accept this event with probability QE:
	
	vector<int> tids = aHit->GetTIds(); // track ID at EACH STEP
	vector<int> pids = aHit->GetPIDs(); // particle ID at EACH STEP
	set<int> TIDS;                      // an array containing all UNIQUE tracks in this hit
	vector<double> photon_energies;
	
	vector<double> Energies = aHit->GetEs();
	
	// this needs to be optimized
	// uaing the return value of insert is unnecessary
	
	for(unsigned int s=0; s<tids.size(); s++)
	{
		// selecting optical photons
		if(pids[s] == MHit::OPTICALPHOTONPID)
		{
			// insert this step into the set of track ids (set can only have unique values).
			pair< set<int> ::iterator, bool> newtrack = TIDS.insert(tids[s]);
			
			// if we found a new track, then add the initial photon energy of this
			// track to the list of photon energies, for when we calculate quantum efficiency later
			if( newtrack.second ) photon_energies.push_back( Energies[s] );
		}
	}
	
	
	
	// here is the fun part: figure out the number of photons we detect based
	// on the quantum efficiency of the photocathode material, if defined:
	
	
	// If the detector corresponding to this hit has a material properties table with "Efficiency" defined:
	G4MaterialPropertiesTable* MPT = aHit->GetDetector().GetLogical()->GetMaterial()->GetMaterialPropertiesTable();
	G4MaterialPropertyVector* efficiency = nullptr;
	//	ndetected = 0;
	bool gotefficiency = false;
	if( MPT != nullptr )
	{
		efficiency = (G4MaterialPropertyVector*) MPT->GetProperty("EFFICIENCY");
		if( efficiency != nullptr ) gotefficiency = true;
	}
	
	
	for( unsigned int iphoton = 0; iphoton<TIDS.size(); iphoton++ )
	{
		// Here for each photon we will define the charge, which is number of ADC counts/per photon
		// For now we will use a Gaussian distribution with a mean of 200 counts and sigma = 20 counts
		double charge_PMT = G4RandGauss::shoot(200., 20.);
		
		//loop over all unique photons contributing to the hit:
		if( gotefficiency )
		{
			// If the material of this detector has a material properties table
			// with "EFFICIENCY" defined, then "detect" this photon with probability = efficiency
			bool outofrange = false;
			if( G4UniformRand() <= efficiency->GetValue( photon_energies[iphoton], outofrange ) ){
				//ndetected++;
				// It passed through the quantum efficiency cut, then let's add charge, time,
				// and stepindex (should always be 1 for optical photons) into  CT components.
				stepIndex.push_back(iphoton);
				chargeAtElectronics.push_back(charge_PMT); //  For the moment 100 is an arbitrary number
				timeAtElectronics.push_back(tInfos.time);
			}
			if( verbosity > 4 )
			{
				cout << log_msg << " Found efficiency definition for material "
				<< aHit->GetDetector().GetLogical()->GetMaterial()->GetName()
				<< ": (Ephoton, efficiency)=(" << photon_energies[iphoton] << ", "
				<< ( (G4MaterialPropertyVector*) efficiency )->GetValue( photon_energies[iphoton], outofrange )
				<< ")" << endl;
			}
		}
		else
		{
			// No efficiency definition, "detect" all photons
			//ndetected++;
			
			stepIndex.push_back(iphoton);
			chargeAtElectronics.push_back(charge_PMT); //  For the moment 100 is an arbitrary number
			timeAtElectronics.push_back(tInfos.time);
			
		}
	}
	
	
	CT[0] = hitNumbers;
	CT[1] = stepIndex;
	CT[2] = chargeAtElectronics;
	CT[3] = timeAtElectronics;
	CT[4] = identifiers;
	CT[5] = hardware;
	
	
	return CT;
}

// - voltage: returns a voltage value for a given time. The inputs are:
// charge value (coming from chargeAtElectronics)
// time (coming from timeAtElectronics)
double htcc_HitProcess :: voltage(double charge, double time, double forTime)
{
	// The shape of the "PulseShape" function is defined in the HitProcess.h
	return PulseShape(forTime, htccc.vpar, charge, time);
}

void htcc_HitProcess::initWithRunNumber(int runno)
{
	string digiVariation    = gemcOpt.optMap["DIGITIZATION_VARIATION"].args;
	string digiSnapshotTime = gemcOpt.optMap["DIGITIZATION_TIMESTAMP"].args;
	
	if(htccc.runNo != runno) {
		cout << " > Initializing " << HCname << " digitization for run number " << runno << endl;
		htccc = initializeHTCCConstants(runno, digiVariation, digiSnapshotTime, accountForHardwareStatus);
		htccc.runNo = runno;
	}
}

// this static function will be loaded first thing by the executable
htccConstants htcc_HitProcess::htccc = initializeHTCCConstants(-1);
