gemc/clas12Tags_old/(commit log)

2016-12-02 clas12 geometry as of 12/2/2016
    [Lower_GI.stl, Upper_GI.stl, brain.stl, bst__parameters_java.txt, bst__parameters_original.txt, cnd__parameters_original.txt, cone-tip.stl, ctof__parameters_original.txt]
2016-12-07 updated cnd geometry and banks
    [cnd__parameters_original.txt]
2016-12-09 added 3a.0.1
    [Lower_GI.stl, Upper_GI.stl, brain.stl, bst__parameters_java.txt, bst__parameters_original.txt, cnd__parameters_original.txt, cone-tip.stl, ctof__parameters_original.txt]
2016-12-13 added 3a.0.2 with dc time to distance
    [Lower_GI.stl, Upper_GI.stl, brain.stl, bst__parameters_java.txt, bst__parameters_original.txt, cnd__parameters_original.txt, cone-tip.stl, ctof__parameters_original.txt]
2016-12-15 dc t vs d version becomes 3a.1.0 - Silvia fix becomes 3a.0.2
    [Lower_GI.stl, Upper_GI.stl, brain.stl, bst__parameters_java.txt, bst__parameters_original.txt, cnd__parameters_original.txt, cone-tip.stl, ctof__parameters_original.txt]
2017-02-16 latest experiments geometry
    [Lower_GI.stl, Upper_GI.stl, brain.stl, bst__parameters_java.txt, bst__parameters_original.txt, cnd__parameters_original.txt, cone-tip.stl, ctof__parameters_original.txt]
2017-02-20 added kpp version of ctof
    [lgd01.stl, lgd02.stl, lgd03.stl, lgd04.stl, lgd05.stl, lgd06.stl, lgd07.stl, lgd08.stl]
2017-03-14 ftof geometry fix for 4a.0.1
    [Lower_GI.stl, Upper_GI.stl, brain.stl, bst__parameters_java.txt, bst__parameters_original.txt, cnd__parameters_original.txt, cone-tip.stl, ctof__parameters_original.txt]
2017-04-13 adding ltcc geo to 4a.0.2
    [Lower_GI.stl, Upper_GI.stl, brain.stl, bst__parameters_java.txt, bst__parameters_original.txt, cnd__parameters_original.txt, cone-tip.stl, ctof__parameters_original.txt]
2017-04-13 added ltcc in both clas12 and gpp gcard
    [ltcc__parameters_original.txt]
2017-04-17 added cad volumes for ltcc
    [S1-BB.stl, S1-BLB.stl, S1-BRB.stl, S1-BW.stl, S1-LW.stl, S1-RW.stl, S1-TB.stl, S1-TLB.stl]
2017-05-08 - fixed bug that affected imports of multiple cad systems
2017-05-09 using 0 for npheD in case it is not optical photons
2017-05-12 release 4a.1.0
    [bst__parameters_java.txt, bst__parameters_original.txt, cnd__parameters_original.txt, cone-tip.stl, ctof__parameters_original.txt, ec__parameters_original.txt, flange-assembly.stl, ftof__parameters_java.txt]
2017-05-12 added ltcc cad files
    [S1-BB.stl, S1-BLB.stl, S1-BRB.stl, S1-BW.stl, S1-LW.stl, S1-RW.stl, S1-TB.stl, S1-TLB.stl]
2017-05-12 improved ltcc
    [ltcc__parameters_original.txt]
2017-07-05 added geometry for 4a.1.1 including cads
    [Beamline.stl, BoreShield.stl, CenterTube.stl, DownstreamShieldingPlate.stl, DownstreamVacuumJacket.stl, Hub001.stl, Plate1.stl, Plate2.stl]
2017-07-05 micromegas FMT added
    [micromegas__parameters_original.txt]
2017-07-07 FTON (default) and FTOFF configurations
    [cone-tip.stl, flange-assembly.stl, inner-assembly.stl, innerShieldAndFlange.stl, lead-shield.stl, lifting-plate.stl, main-cone.stl, nut1.stl]
2017-07-10 added downstream shield and correct materials for torus
    [ShieldDSadapter.stl, ShieldDSlead.stl, ShieldDSleadbase.stl]
2017-07-12 added beamline volumes in the gcard, fixed materials for torus cad volumes
2017-07-19 mv 4a.1.1 to 4a.2.0
    [Beamline.stl, BoreShield.stl, CenterTube.stl, DownstreamShieldingPlate.stl, DownstreamVacuumJacket.stl, Hub001.stl, Plate1.stl, Plate2.stl]
2017-07-19 correct wpdist numbers - these should be read from CCDB though
    [dc_hitprocess.cc]
2017-07-21 switch to non-Cad torus and beamline geometry, fixed SVT geometry to avoid overlap with BMT, updated gcard with RECORD_MIRRORS and no LTCC box
2017-07-27 removed FMT and corrected time2distance parameterizationa
    [dc_hitprocess.cc]
2017-08-02 fix of bugs in b-field dependent term of the time-to-distance function
    [dc_hitprocess.cc]
2017-08-08 using cad beamline and torus
2017-08-14 tagged geometry for 4a.2.1
    [Beamline.stl, BoreShield.stl, CenterTube.stl, DownstreamShieldingPlate.stl, DownstreamVacuumJacket.stl, Hub001.stl, Lower_GI.stl, Plate1.stl]
2017-08-14 fixed ltcc, added frame in gcard. torus bullet added
    [S2-BB.stl, S2-BLB.stl, S2-BRB.stl, S2-BW.stl, S2-LW.stl, S2-RW.stl, S2-TB.stl, S2-TLB.stl]
2017-08-21 removing obsolete volumes; adding relevant volumes
    [Beamline.stl, ShieldDSadapter.stl, ShieldDSlead.stl, ShieldDSleadbase.stl, downstreamTube.stl]
2017-08-21 removed unnecessary flange
    [flange-assembly.stl]
2017-08-21 two new gcards for vacuum line configurations
    [apex.stl]
2017-08-21 porting to latest version
    [apex.stl, lgu01.stl, lgu02.stl, lgu03.stl, lgu04.stl, lgu05.stl, lgu06.stl, lgu07.stl]
2017-08-21 removed original variation
    [ec__parameters_original.txt]
2017-08-21 restoring pars for original ec
    [ec__parameters_original.txt]
2017-08-21 porting to latest geo
    [ctof__parameters_original.txt]
2017-08-21 added missing materials
2017-08-22 fixed cad frame mother to fc
2017-08-23 correct numbers and units for dc stagger
    [dc_hitprocess.cc]
2017-08-25 adding adc for non-photons hits
2017-08-25 removed unnecessary definitions in gbank.cc. fixed indexing in evio output
    [evio_output.cc, gbank.cc]
2017-08-30 bst timewindow corrected. added target from cad
    [TargetAlWindowD.stl, TargetAlWindowU.stl, TargetBaseTubeTorlon.stl, TargetEndCapKapton.stl, TargetFoam.stl, TargetFoam2.stl, TargetFoam3.stl, TargetVacuumTubeAl.stl]
2017-08-30 smaller target enclosure. vacuum line in the shield starting 1mm downstream of target vac extension; removed fton2 variation
2017-09-05 adding 4a.2.2
    [BoreShield.stl, CenterTube.stl, DownstreamShieldingPlate.stl, DownstreamVacuumJacket.stl, Hub001.stl, Lower_GI.stl, Plate1.stl, Plate2.stl]
2017-09-06 default hall material is air
2017-09-11 new target, no transparency in MM
    [TargetVacuumTubeAl.stl]
2017-09-13 removed material from obsolete variation
2017-09-20 added adjuster to torus mount. re-tesselating torus mount
    [adjuster1.stl, adjuster2.stl, adjuster3.stl, innerShieldAndFlange.stl, nut1.stl, nut2.stl, nut3.stl, nut4.stl]
2017-09-22 new stl file for FTOff configuration as well
    [innerShieldAndFlange.stl, nut1.stl, nut2.stl, nut3.stl, nut4.stl, nut5.stl, nut6.stl, nut7.stl]
2017-09-22 more precise inner shield
    [innerShieldAndFlange.stl]
2017-09-29 new stl for inner shield in tagger; moved outer flange upstream to avoide overlap with FC
    [taggerInnerShield.stl]
2017-10-10 downstream shielding additions from CAD model; includes new beamline design
    [DSShieldBackAss.stl, DSShieldBackCover.stl, DSShieldBackLead.stl, DSShieldFlange.stl, DSShieldFlangeAttachment.stl, DSShieldFrontAss.stl, DSShieldFrontCover.stl, DSShieldFrontLead.stl]
2017-10-12 added definitions for FTOff. Removed lifting plate and window support, not needed
    [lifting-plate.stl, taggerInnerShield.stl, windowSupportUpstreamPipe.stl]
2017-10-30 - fixed mismatch typo for internal generator
    [evio_output.cc]
2017-10-30 - fixed bug in dipole field calculation: the transverse coordinate was not computed correctly in some cases.
    [mappedField.cc]
2017-10-30 added magfield descriptor in the cad attributes
2017-10-31 MM IR bigger ; new numbering for ctof and cnd
    [micromegas__parameters_michel.txt]
2017-11-27 added shifted target cad imports
    [TargetAlWindowD.stl, TargetAlWindowU.stl, TargetBaseTubeTorlon.stl, TargetEndCapKapton.stl, TargetFoam.stl, TargetFoam2.stl, TargetFoam3.stl, TargetVacuumWindow50umAl.stl]
2017-12-15 added 4a.2.3
    [BoreShield.stl, CenterTube.stl, DSShieldBackAss.stl, DSShieldBackCover.stl, DSShieldBackLead.stl, DSShieldFlange.stl, DSShieldFlangeAttachment.stl, DSShieldFrontAss.stl]
2018-01-05 fixes case where no background file was provided; using G4ClassicalRK4 for solenoid. added bstShield test
    [mappedField.h]
2018-02-01 added several materials options
2018-02-09 new numbering scheme for the ctof cad volumes
2018-02-28 added mandatory hytType to cad description
2018-03-02 dc gas material changed to 90% Ar, 10% G4_CARBON_DIOXIDE.
2018-03-02 fixed dc material
2018-03-05 - Rafo: fixed bug in ctof and ftof hit process routines
    [ctof_hitprocess.cc, ftof_hitprocess.cc]
2018-03-16 - added option FILTER_NULL_VARIABLES. If set to one, do not write variables with no valuable information.
2018-03-16 making sure FILTER_NULL_VARIABLES starts as false
2018-03-26 fixed clas12 dc doca for merged hits
    [dc_hitprocess.cc]
2018-04-03 fixed odd/even number length
    [ctof_hitprocess.cc]
2018-04-19 ctof reading vars from ccdb. rtpc fixes
    [ctof_hitprocess.cc, ctof_hitprocess.h, rtpc_hitprocess.cc]
2018-06-05 added 4a.2.4, and benchmark results for 4a.2.3
    [BoreShield.stl, CenterTube.stl, DSShieldBackAss.stl, DSShieldBackCover.stl, DSShieldBackLead.stl, DSShieldFlange.stl, DSShieldFlangeAttachment.stl, DSShieldFrontAss.stl]
2018-06-07 runno and default New Torus Field in gcard. 8mm shift in the gcard. precision changes in other volumes
    [micromegas__parameters_michel.txt]
2018-06-15 - Micromegas digitization reading from correct CCDB table - Indentation that makes sense on BMT_hitprocess. Removed unnecessary comment for runno = -1 - added PRODUCTIONCUTFORVOLUMES option. It is a 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
    - PRODUCTIONCUTFORVOLUMES="outerMount, taggerInnerShield, outerFlange, outerMount, nut1, main-cone, DSShieldFrontLead, 100" will set the production cut for those volumes to 10 cm.
    - added relevant volumes production cut: beamline, torus and vacuum line
    [BMT_hitprocess.cc, FMT_hitprocess.cc]
2018-06-28 switching to 4a.2.4 and fixing a typo
2018-06-29 dc routine fix - using new ccdb table
    [dc_hitprocess.cc]
2018-07-03 fixed case where GEMC_DATA_DIR environment does not exist
2018-07-05 added ltcc nose from model
    [BottomPlate.stl, Epoxy.stl, FrontPlate.stl, Mount.stl, NFrame.stl, Nose.stl]
2018-07-16 cleaning up old tags
    [Lower_GI.stl, S1-BB.stl, S1-BLB.stl, S1-BRB.stl, S1-BW.stl, S1-LW.stl, S1-RW.stl, S1-TB.stl]
2018-07-18 added new solenoid field configuration
2018-07-23 new solenoid as default field. added micromegas variation activeOnly
2018-08-01 correct version of magnetic field
2018-08-06 added 4a.2.5
    [BoreShield.stl, BottomPlate.stl, CenterTube.stl, DSShieldBackAss.stl, DSShieldBackCover.stl, DSShieldBackLead.stl, DSShieldFlange.stl, DSShieldFlangeAttachment.stl]
2018-08-07 removing obsolete tag
    [S1-BB.stl, S1-BLB.stl, S1-BRB.stl, S1-BW.stl, S1-LW.stl, S1-RW.stl, S1-TB.stl, S1-TLB.stl]
2018-10-04 updated dc wire position
2018-10-09 fixing examples and adding atlas
    [ForwardShield.stl, HEC.stl, LargeOuterWheel.stl, SmallBarrel.stl, TRT.stl, Toroid.stl]
2018-10-26 RECORD_MIRRORS 0 by default, production cut changed to 2cm
2018-11-05 added 0.5mm thickness W shield
2018-11-06 latest geo from 5.7 coatjava geometry
    [ftof__parameters_java.txt]
2018-12-03 updated scattering chamber and window
    [TargetFoam.stl]
2019-01-08 4a.2.5 moved to 4.3.0
    [BoreShield.stl, BottomPlate.stl, CenterTube.stl, DSShieldBackAss.stl, DSShieldBackCover.stl, DSShieldBackLead.stl, DSShieldFlange.stl, DSShieldFlangeAttachment.stl]
2019-01-10 added polarized target files
    [InsertBath_NoVoid_6.stl]
2019-01-10 Update README.md
    Added polarized target geometry/material and cad volume.
2019-01-15 added development version 4.3.1
    [BoreShield.stl, BottomPlate.stl, CenterTube.stl, DSShieldBackAss.stl, DSShieldBackCover.stl, DSShieldBackLead.stl, DSShieldFlange.stl, DSShieldFlangeAttachment.stl]
2019-02-20 ftof shield position fix and ND3 material removal
2019-03-03 cad target variation renamed lh2, added ld2 as well
2019-03-03 cad target variation renamed lh2, added ld2 as well, cad obsolete
2019-03-07 rga spring card semifinal and added ctof 19 and 30mm variations
    [lgd01.stl, lgd02.stl, lgd03.stl, lgd04.stl, lgd05.stl, lgd06.stl, lgd07.stl, lgd08.stl]
2019-04-11 added Eg2 cad target and magnets gcard
    [cellAlwindow.stl, cellendcap.stl, endcapAlwindow.stl, firstRohacellSpacer.stl, firsttargframe.stl, secondRohacellSpacer.stl, secondtargframe.stl, targetContainer.stl]
2019-04-29 added versions 4.3.2 and 4.4.0
    [BoreShield.stl, BottomPlate.stl, CenterTube.stl, DSShieldBackAss.stl, DSShieldBackCover.stl, DSShieldBackLead.stl, DSShieldFlange.stl, DSShieldFlangeAttachment.stl]
2019-05-09 fixed bug that somehow emerged only on linux (deleting a null pointer)
    [evio_output.cc]
2019-06-13 gemc detector variation match geometry services CCDB variation
    [bst__parameters_default.txt, bst__parameters_java.txt, ftof__parameters_java.txt, ftof__parameters_original.txt, ftof__parameters_rga_fall2018.txt]
2019-06-13 4.3.1 experiments ported to 4.3.2 and 4.4.0
    [bst__parameters_default.txt, bst__parameters_java.txt, ftof__parameters_java.txt, ftof__parameters_original.txt, ftof__parameters_rga_fall2018.txt]
2019-07-10 added ltcc variations. just precisions on the geo service detectors
    [ltcc__parameters_original.txt]
2019-07-11 added rgb-spring and default gcards
2019-07-12 fixed number of paddles for ftof
    [ftof__parameters_rga_fall2018.txt]
2019-07-18 new javacad variations with target positions shifts
    [lgd01.stl, lgd02.stl, lgd03.stl, lgd04.stl, lgd05.stl, lgd06.stl, lgd07.stl, lgd08.stl]
2019-07-22 fixed ctof spring variation
2019-07-25 added default variations for ec, pcal and ftof
    [ftof__parameters_default.txt]
2019-07-25 4.3.2 geometry updated, rich_sector4 added
    [ftof__parameters_default.txt, ftof__parameters_rga_fall2018.txt, lgd01.stl, lgd02.stl, lgd03.stl, lgd04.stl, lgd05.stl, lgd06.stl]
2019-07-26 fixed z limit on tracking to 8000mm instead of 7200mm for all gcards
2019-08-02 added javacad dir
    [Aluminum.stl, CFRP.stl, Layer_201_component_1.stl, Layer_201_component_10.stl, Layer_201_component_11.stl, Layer_201_component_12.stl, Layer_201_component_13.stl, Layer_201_component_14.stl]
2019-08-07 bringing 4.4.0 up to date on source and geometry
    [ftof__parameters_rga_fall2018.txt, lgd01.stl, lgd02.stl, lgd03.stl, lgd04.stl, lgd05.stl, lgd06.stl, lgd07.stl]
2019-08-07 added new detector variations for 4.4.0
    [Aluminum.stl, CFRP.stl, Layer_201_component_1.stl, Layer_201_component_10.stl, Layer_201_component_11.stl, Layer_201_component_12.stl, Layer_201_component_13.stl, Layer_201_component_14.stl]
2019-08-09 mother target better enclosing the scattering chamber
2019-08-09 fixed initialization of default variation for MM. Otherwise it crashes with sqlite
    [BMT_hitprocess.cc]
2019-09-25 precision changes and upstream ctof light guides
    [lgu01.stl, lgu02.stl, lgu03.stl, lgu04.stl, lgu05.stl, lgu06.stl, lgu07.stl, lgu08.stl]
2019-10-01 upstream light guiddes for 4.4.0
    [lgu01.stl, lgu02.stl, lgu03.stl, lgu04.stl, lgu05.stl, lgu06.stl, lgu07.stl, lgu08.stl]
2019-10-04 added template excel file for benchmarks
    [template.xlsx]
2019-10-04 gcard changes, working on excel template
    [template.xlsx]
2019-10-04 fixed order, and phi distribution of particles
    [template.xlsx]
2019-10-07 results with 4.3.2, fixed ft reporting
    [template.xlsx]
2019-10-07 corrected ftof and ltcc numbers
    [template.xlsx]
2019-10-07 excel updated
    [template.xlsx]
2019-10-07 added total column for rates
    [template.xlsx]
2019-10-11 fixed vacuum material
2019-10-15 vacuum extension from eng. design
    [TargetAlWindowD.stl, TargetAlWindowU.stl, TargetBaseTubeTorlon.stl, TargetEndCapKapton.stl, TargetVacuumWindow50umAl.stl, TargetWallKapton.stl, TargetWindowAdapterTorlon.stl, foamExtended.stl]
2019-10-15 forgot material for lh2e
2019-12-11 added MM bonus variation
    [micromegas__parameters_bonus.txt]
2019-12-18 added volume pars file, micromegas rgf configuration, rgf gcard and yaml
    [bst__parameters_java.txt, ftof__parameters_original.txt, ltcc__parameters_original.txt, micromegas__parameters_bonus.txt, micromegas__parameters_rgf_spring2020.txt]
2019-12-20 added 5mm pvc support ring for fmt
2020-02-24 toff_P2P is already subtracted, reverting changes. still using digi variations
    [ftof_hitprocess.cc, ftof_hitprocess.h]
2020-02-28 fixed ftof digitization variation
    [ftof_hitprocess.cc]
2020-04-02 matching 4.4.0 geo to 4.3.2
    [bst__parameters_java.txt, ftof__parameters_original.txt, ltcc__parameters_original.txt, micromegas__parameters_rgf_spring2020.txt]
2020-04-02 fixed ctof to read digitization variation
    [ctof_hitprocess.cc, ctof_hitprocess.h]
2020-07-08 hydrogen gas added to materials
2020-07-13 added RECORD_MIRRORS for mirrors detectors only. fixed ROTATE_FIELDMAP option
    [mappedField.cc, mappedField.h]
2020-07-22 nuclear target test geometry
    [TargetFoam.stl, TargetFoam2.stl, TargetFoam3.stl, TargetVacuumWindow50umAl.stl]
2020-07-27 elmo geometry and transverse target geometry
    [DSShieldBackAss.stl, DSShieldBackCover.stl, DSShieldBackLead.stl, DSShieldFlange.stl, DSShieldFlangeAttachment.stl, DSShieldFrontAss.stl, DSShieldFrontCover.stl, DSShieldFrontLead.stl]
2020-09-08 README updated, switching to 5.0 development
2020-09-08 deleting stuff that wont be needed anymore
    [Beamline.stl, BoreShield.stl, BottomPlate.stl, CenterTube.stl, DSShieldBackAss.stl, DSShieldBackCover.stl, DSShieldBackLead.stl, DSShieldFlange.stl]
2020-09-08 5.0 version
    [Aluminum.stl, BoreShield.stl, BottomPlate.stl, CFRP.stl, CenterTube.stl, DSShieldBackAss.stl, DSShieldBackCover.stl, DSShieldBackLead.stl]
2020-10-28 4.4.1 has MAX_Z_POS changed from 8000 to 9000
    [Aluminum.stl, BoreShield.stl, BottomPlate.stl, CFRP.stl, CenterTube.stl, DSShieldBackAss.stl, DSShieldBackCover.stl, DSShieldBackLead.stl]
2021-02-05 making gcc happy and fix hit process name
    [HitProcess_MapRegister.cc]
2021-02-11 ecal bank name fix for hipo
    [ecal_hitprocess.cc, hipoSchemas.cc]
2021-02-15 fixed view indexing and bank output
    [ecal_hitprocess.cc]
2021-02-15 fix htcc and ltcc timing output
    [htcc_hitprocess.cc, ltcc_hitprocess.cc]
2021-02-16 solenoid and torus field in hipo RUN::config
2021-02-18 correct material and radii of transverse target
    [Transverse_target_for_simulation.FCStd, Transverse_target_for_simulation.stp, downCoils.stl, downRing.stl, ladder.stl, ladderSupport.stl, magnetSupport.stl, targetFrame.stl]
2021-04-01 adding rgb_fall2019 gcard, same as spring but outbending
2021-04-01 adding rgb_fall2019 gcard, same as spring but outbending for 5.0
2021-04-02 geometry last updates
    [80KCan_Al.stl, 80KCan_SS.stl, InsertBath_NoVoid_6.stl, LHeCan_Al.stl, LHeCan_Cu.stl, LHeCan_Nylon.stl, LHeCan_PCTFE.stl, LHeCan_SS.stl]
2021-04-06 exit code for hipo detector not in map. fixed bank indexing for hipo true info
    [gbank.cc, hipoSchemas.cc, hipo_output.cc, hipo_output.h]
2021-04-07 fixed 4.4.1 version string
    [Aluminum.stl, BoreShield.stl, BottomPlate.stl, CFRP.stl, CenterTube.stl, DSShieldBackAss.stl, DSShieldBackCover.stl, DSShieldBackLead.stl]
2021-04-09 deleting pointers on hipo output destruction fixes memory leak
    [evio_output.h, hipo_output.cc, hipo_output.h]
2021-04-13 rcg config for 5.0 and longitudinal target
    [MEOP_CLAS12.stp, TargetFoam.stl, TargetFoam2.stl, TargetFoam3.stl, TargetVacuumWindow50umAl.stl, TargetWindowAdapterTorlon.stl, beam_window.stl, deverter.stl]
2021-04-15 fixing region cut bug, removing torlon adapted from cad target
    [TargetWindowAdapterTorlon.stl]
2021-04-28 bst removed unused var, cnd hipo output, skip true info by default if rejected by digitization
    [cnd_hitprocess.cc, cnd_hitprocess.h, ctof_hitprocess.cc, ftof_hitprocess.cc, hipoSchemas.cc]
2021-06-11 removed printout
2021-06-14 removed log printout
2021-06-30 bstShield w/o heatshield
2021-06-30 size of target root volume to be a better envelope for scattering chambers
    [TargetFoam.stl, TargetFoam2.stl, TargetFoam3.stl, scatteringChamber.stl]
2021-07-07 added materials in beam path for transverse field configuration. TransverseUpstreamBeampipe splitted in two to account for heat shield
    [BeamPathExitWindow.stl, DownstreamRS.stl, InnerRSSheet.stl, InnerRSSheetMIR1.stl, Pumpline60mm.stl, UpstreamRS.stl]
2021-08-10 BMT hit process: fix to z coordinate used to determine strip, to be compatible with shifts of both mother volume and individual sub-volumes
    [BMT_hitprocess.cc, bmt_strip.h]
2021-08-30 mod slim by maxime for rgm
    [micromegas__parameters_slim.txt]
2021-11-22 removed unecessary htcc volume moves from gcards. added stp files for transverseTargetCad
    [AdditionalWindows.stp]
2021-11-23 added spring and fall2018 cad configurations
2021-11-23 added cad dirs in 4.4.2 and 5.0
    [htccCone.stl, htccMollerCone.stl]
2021-11-23 typo on htcc cad dir name fixed
2021-12-09 added htcc moller cone extension
    [htccMollerConeExt.stl]
2021-12-09 fixex htcc cad system of coordinates
2021-12-09 htcc reference system fixed
    [htccCone.stl, htccMollerCone.stl, htccMollerConeExt.stl]
2021-12-14 keeping 5.0 sync with source. fixed problem when mother particles info was not accessible in digitization. syncing hit index in hipo mc true
    [BMT_hitprocess.cc, FMT_hitprocess.cc, bmt_strip.h, cnd_hitprocess.cc]
2022-01-13 fix 4.4.2 and 5.0 conform to OPTICALPHOTONPID. notice: this does depend on the geant4 version.
    [htcc_hitprocess.cc]
2022-02-03 added geantino case for BMT
2022-02-04 ChargedGeantinoDefinition should be used for BMT
2022-02-07 for geantinos, assigning ADC = 1
2022-02-10 adding step limiter for chargedgeantino
2022-02-14 rich sector 4 geometry
    [Aluminum.stl, CFRP.stl, Layer_201_component_1.stl, Layer_201_component_10.stl, Layer_201_component_11.stl, Layer_201_component_12.stl, Layer_201_component_13.stl, Layer_201_component_14.stl]
2022-02-18 added htcc passive materials with fall18 and spring18 variations. added rich sector4
2022-03-03 rich overlaps fix
    [RICH_s4.stl]
2022-03-07 adding band in 5.0. making step 100 microns for fmt. bus cable dimensions fixes for bst
    [HitProcess_MapRegister.cc]
2022-03-07 band digitization unique_ptr fix and band gcard
    [band_hitprocess.cc]
2022-03-16 removed shifts for non present upstream passive material
2022-04-11 added 5.1 version
    [80KCan_Al.stl, 80KCan_SS.stl, AdditionalWindows.stp, Aluminum.stl, BeamPathExitWindow.stl, BoreShield.stl, BottomPlate.stl, CFRP.stl]
2022-04-18 no significant geometry changes, mostly gcards. ltcc precision dimensions changes
    [AdditionalWindows.FCStd]
2022-04-19 hall field in gcards
2022-04-19 using fc default variation no field, fix filename for solenoid binary map
    [clas12BinField.h]
2022-06-29 fixed Cone2 Cylinder FTflangeShieldCylinder for rgh beamline
2022-07-20 fixed rastering vertex algorithm not working for no rastering and removed constants date from digitization routines
    [FMT_hitprocess.cc, ahdc_hitprocess.cc, atof_hitprocess.cc, band_hitprocess.cc, cnd_hitprocess.cc, ctof_hitprocess.cc, ecal_hitprocess.cc]
2022-08-23 temp removing some ltcc cad import creating problems
    [BottomPlate.stl, Epoxy.stl, FrontPlate.stl, Mount.stl, NFrame.stl, Nose.stl, S1-BW.stl, S1-LW.stl]
2022-08-23 fixed electron color doc, autorefresh false while loading geometry, fix raster log, added e.m. g4 physics doc in the file comments
    [hipo_output.cc]
2022-08-30 removed problematic S1-TRB
    [S1-TRB.stl]
2022-09-12 Added nan checks for LUND files numbers and field getters. using mixmaxrng random seed. New EVENT_VERBOSITY flag for dedicated event verbosity. temp-removing ltcc problematic stl model
    [bclas12MappedField.cc, hipoSchemas.cc]
2022-09-16 removed g4 print progress
2022-09-26 removed unused vars, fix indentation
    [BMT_hitprocess.cc, FMT_hitprocess.cc, HitProcess_MapRegister.cc, IC_hitprocess.cc, ahdc_hitprocess.cc, ahdc_hitprocess.h, alertshell_hitprocess.cc, alertshell_hitprocess.h]
2022-10-13 fixes to ftof hit process and tdc order for dc
    [dc_hitprocess.cc, ftof_hitprocess.cc, ftof_hitprocess.h]
2022-10-13 fixes to ctof hit process efficiency
    [ctof_hitprocess.cc]
2022-10-13 added one rich stl and alert ahdc
    [Layer_204_component_32.stl, ahdc__parameters_default.txt, ahdc__parameters_rga_fall2018.txt]
2022-10-14 fixed efficiency for ftof and ctof, order 0 for ahdc and doca is multiplied by 1000
    [ahdc_hitprocess.cc, ctof_hitprocess.cc, ftof_hitprocess.cc]
2022-10-14 added alert atof geo and digitization
    [atof__parameters_default.txt, atof__parameters_rga_fall2018.txt]
2022-10-15 fixing initialization if writeHit, must be for each hit not each event
    [BMT_hitprocess.cc, ECAL_hitprocess.cc, FMT_hitprocess.cc, IC_hitprocess.cc, SVT_hitprocess.cc]
2022-10-21 fixed cmag pointer not being reused
    [bclas12MappedField.cc, bclas12MappedField.h, clas12BinField.cc]
2022-10-25 adding fmt and rtpc to adc schema
2022-10-27 correct ltcc variation for ltcc rgab spring 19
2022-11-07 adding alert detector ids and rtpc digitization fixes
    [hipo_output.h, rtpc_hitprocess.cc, rtpc_hitprocess.h]
2023-02-24 added ddvcs scatt chamber configuration and gcard
2023-02-24 added ddvcs cad
    [crystal_shell.stl, ddvcs_cal.FCStd, layout_calorimeter.stl, moeller_cone.stl]
